SixOfFive/2009_kia_spectra/logs/2026-06-01.md

# 2026-06-01 — dashboard gets a map view; docs catch up to surf

Yesterday a parallel session brought up the kiosk display stack on
slypi (X11 + openbox + **surf**, not Chromium — see the braindump
heads-up + the [slypi vault note]). The vroom repo's reproduction
docs were still telling readers to install Chromium for the kiosk,
and the dashboard had no map view yet — the kiosk was pointed at a
standalone `/home/node/map.html` instead of vroom's dashboard.

Today's work closes both gaps with two commits.

## What landed today

| Commit | What |
|---|---|
| `6aad5e2` | Dashboard map view + toggle; docs + provision.sh switched from chromium to surf |

## Why surf, not Chromium — the gist

Chromium reliably OOM-killed itself on the Pi Zero 2 W (512 MB total)
while loading the dashboard. Surf (suckless WebKit2GTK) handles the
same page plus Leaflet at ~60 MB RSS without OOM, so it's the new
default. Chromium is still apt-installed by `provision.sh` as a
fallback for hardware with more headroom.

Documented in `docs/10-pi-setup.md` under a new "Why surf, not
Chromium" section.

## Doc + provision changes

`docs/10-pi-setup.md`:
- Every "chromium kiosk" reference is now "surf kiosk"
- "Why surf, not Chromium" callout explaining the OOM observation
- Step 8 + "What you should have" reflect the surf/openbox/xinit
  stack

`pi/setup/provision.sh`:
- apt list: dropped `matchbox-window-manager`, added `openbox` +
  `xinit` + `surf` + `xdotool` + `x11-xserver-utils`. Chromium
  retained as a fallback.
- Dropped the LXDE `@autostart` block in
  `/home/$PI_USER/.config/lxsession/LXDE-pi/`
- Added: `/etc/X11/Xwrapper.config` (allowed_users=anybody),
  `~/.xinitrc` (xset + unclutter + openbox + surf at
  `localhost:8000`), `~/.bash_profile` (auto-`exec startx` when
  logging in on tty1), and a `getty@tty1.service.d/autologin.conf`
  drop-in for autologin

The autostart pattern matches what the slypi session converged on in
their separate worktree — same conf paths, same file contents (modulo
the kiosk URL, which their copy points at `file:///home/node/map.html`
and ours points at `http://localhost:8000/`).

## Dashboard map view + toggle

The dashboard now ships with **two views**:

- **Gauges view** (default): the existing battery/RPM/speed/coolant/
  throttle/fuel gauges + control buttons + trip log + events feed
- **Map view**: an embedded Leaflet map, centered (by default) on
  Edmonton city center with OSM raster tiles

A floating button in the top-right corner toggles between them.
Mouse-click in a regular browser, touch-tap on the Elecrow screen —
identical behavior. The choice is persisted to `localStorage` so a
`vroom.service` restart that reloads the page doesn't bounce the
operator back to gauges if they were watching the map.

### Configuration knobs

In `pi/app/config.py`:

```python
MAP_DEFAULT_CENTER = (53.5461, -113.4938)  # Edmonton city center
MAP_DEFAULT_ZOOM = 12
MAP_TILE_URL = "https://{s}.tile.openstreetmap.org/{z}/{x}/{y}.png"
MAP_TILE_ATTRIBUTION = '&copy; <a href=...>OpenStreetMap</a> contributors'
```

Edmonton is the shipped default because it's a public landmark — change
this constant for your install. The Jinja template renders all four
into JS land via `tojson`, so anything you set in Python flows through
without template changes.

### Implementation notes

- **Lazy Leaflet init**: the map JS is only constructed the first time
  the toggle is tapped. A kiosk operator who only ever looks at gauges
  never pays the tile-fetch cost.
- **Hidden vs. unmounted**: the map container starts `display:none`,
  which means Leaflet doesn't render tiles for an invisible div. On
  show, `invalidateSize()` is called so Leaflet recomputes its
  viewport (Leaflet famously misbehaves if its container was hidden
  at construction).
- **Subresource integrity**: both the Leaflet CSS and JS `<link>` /
  `<script>` tags have `integrity="sha256-..."` hashes pinned. If
  unpkg ever serves a different file, the browser refuses to load
  it. (Update the hashes if you bump the Leaflet version.)
- **CDN, not vendored**: matches the precedent set by the slypi-side
  `/home/node/map.html` standalone map. If the Pi is offline (no LAN
  Wi-Fi), the map view shows the page chrome but no tiles. The
  gauges view doesn't need the CDN. A future improvement is vendoring
  Leaflet into `pi/app/display/static/vendor/` so the dashboard
  works fully offline — deferred until/unless that's needed.

### Tests

`pi/tests/test_display_server.py` gained two:

- `test_dashboard_includes_map_view_and_toggle` — verifies the
  toggle button, hidden `#view-map`, Leaflet CDN refs, and the
  `window.MAP_*` JS exports are all in the rendered HTML
- `test_dashboard_map_center_matches_config` — verifies the injected
  `MAP_CENTER` matches `config.MAP_DEFAULT_CENTER` (Edmonton as
  shipped). Renumber the constant in this test if the default
  center is ever changed.

Project test total: 197 → **199** (+2). Lint clean.

## Deploy + verify

On slypi:

```
cd /opt/vroom
git checkout -- pi/systemd/        # established pattern — discard
                                   #   the local User=node sed patches
git pull --ff-only
sudo systemctl restart vroom.service
```

Verified post-restart:

- `curl http://localhost:8000/` renders the new HTML (5524 bytes,
  was ~5000-ish). Toggle button + view-map div + Leaflet CDN refs +
  all four `window.MAP_*` exports all present.
- `python3 pi/tests/test_display_server.py` → **7/7** on Python 3.13.
- `/api/state` still returns the live snapshot.
- Mosquitto (`:1883`), dashboard (`:8000`), SNMP (`:1161`) all
  bound — no service regressions.

The slypi-side kiosk surf process is still pointed at
`file:///home/node/map.html` (the parallel session's standalone map).
**This commit doesn't move it** — that's a one-line `sed` on
`/home/node/.xinitrc` (point at `http://localhost:8000/` instead),
deliberately left to the slypi-session owner.

## Late evening — scope decision: ESP32-only is v1, Pi is v2

After looking at the dashboard map view land, took a step back to ask
"why did we add the Pi in the first place?" Honest review of the
docs:

- The vault note ([[vroom Pi-based remote start for 2009 Kia]]) and
  `docs/architecture.md` are clear: the Pi was always the *telematics*
  half. The trigger function — voltage monitoring, RF replay, run
  timer — has always been ESP32-only.
- The original ask (paraphrased): "my battery never dies in my car."
  That's pure ESP32 work.
- Everything since the SNMP responder commit is technically
  telematics: MQTT broker, dashboard hardening, kiosk stack, map
  view. None of it is wasted (all tested, all works), but **none of
  it is required for the original goal**.

Decision: **v1 ships as ESP32-only. Pi/telematics is parked as v2.**

### What this changes in the repo

Docs only — no code deleted, no slypi services stopped.

- `README.md`: rewritten to lead with the ESP32-only architecture +
  rationale + "v2 — optional telematics" section pointing at the
  parked Pi work
- `docs/BOM.md`: split into "v1 — essential (~$95)" and "v2 —
  optional telematics (+~$121)"
- `docs/architecture.md`: division-of-labor table now starts with
  v1 (everything-on-ESP32), then a "v2 add-on" section restores the
  Pi-side responsibilities; power architecture has v1 (1A buck, no
  MOSFET) + v2 (5A buck, AO3401A gate)
- `braindump.md`: pre-compaction state snapshot updated with the
  scope decision so future sessions see it on entry

### What this does NOT change

- ESP32 firmware (already works without a Pi — the Pi-power MOSFET
  GPIO toggles, `shutdown_pi` UART writes, and the STOPPING-state
  shutdown coordination are inert when no Pi is wired up)
- The `pi/` directory (kept as v2 reference build, all 199 tests
  still pass)
- slypi runtime (vroom.service stays running as the parked v2
  reference; mosquitto, SNMP, dashboard, map view all keep working
  there)
- The reproduction docs 13-20 (still useful — docs 13-16 cover
  in-car install which v1 needs; docs 17 (HA), 18 (long-term-
  stability), 19 (cellular alerting), 20 (SNMP) are v2 reference
  material)

### Why "v2" lives in the repo at all

Keeping it accomplishes three things:

1. **Reversibility** — if the v1 install gets boring after a winter
   of working perfectly and the telematics half becomes interesting,
   it's a `git pull` away. No re-derivation needed.
2. **Documentation** — the Pi-side work is, in aggregate, a pretty
   clean reference for "how to wire a Pi as a vehicle dashboard." It
   has value beyond this build.
3. **Tests stay green** — CI still exercises both halves on every
   push. Drift will catch itself.

The cost is roughly $0 — the repo has the code, tests run on free
CI, and nobody is forced to install the Pi side.

## TODO carried forward (cross-day, no day rollover)

- [x] ~~Update vroom docs about chromium-OOM + surf~~ — done (`6aad5e2`)
- [x] ~~Add tap-toggle between map and gauge view~~ — done (`6aad5e2`)
- [x] ~~Scope-down decision: ESP32-only v1~~ — done (this commit)
- [ ] When parts arrive: bench v1 first (docs 08-12), then in-car
      install (docs 13-16). v2 docs (17-20) only if/when telematics
      becomes interesting after a winter of v1 working.
- [ ] *(deferred to "if v2 becomes a thing")*: Leaflet vendoring,
      slypi xinitrc kiosk swap, HA integration, anything else from
      the prior list
