SixOfFive/2009_kia_spectra/logs/2026-05-30.md

# 2026-05-30 — first Pi deploy + SNMP cross-process bug found

The ESP32 + CC1101 + ADS1115 + display + buck haven't arrived yet, but
the Pi Zero 2 W is on the bench. Today was about getting the Pi-side
stack actually running on real hardware, not just CPython on the dev
workstation (BEAST). Target box: **slypi**, a Pi Zero 2 W Rev 1.0
running Debian 13 trixie, kernel `6.18.29+rpt-rpi-v8` aarch64. slypi
already had NetworkManager-managed static networking, Postfix relay,
logcheck, unattended-upgrades, and paired BT mouse + keyboard from
prior setup — the vroom Pi-side stack drops in on top. The slypi
vault note is the source of truth for the bits we keep off GitHub
(LAN IP, SSH credentials, host-key fingerprint).

## What landed today

| Commit | What |
|---|---|
| _(today)_ | `pi/systemd/vroom-snmp.service`: drop misleading `After=`/`Wants=vroom.service` |
| _(today)_ | `docs/20-snmp-integration.md`: new "Known limitation" on cross-process state staleness |
| _(today)_ | This daily log |

## Display mount decision — keep the existing docs/14 plan

Asked: "do you have the writeup done for mounting the screen onto the
project box?" Re-confirmed the design: the screen does **not** mount on
the enclosure. The current `docs/14-case-mounting.md` has:

- Hammond 1591ESBK enclosure → Velcro'd **under** the driver's-side
  knee panel
- 5" display → VHB-taped to the **top of the dash** above the radio
  bezel
- 50 cm HDMI ribbon + USB cable run up the right side of the steering
  column between them

Walked through the thermal + visibility + antenna-placement reasoning
for why "tablet on dash" (everything in one enclosure on the dash-top)
loses to the split. Decision held — no docs change.

## Provisioning slypi for vroom — the recon

```
host:       slypi (Pi Zero 2 W Rev 1.0, BCM43430 Wi-Fi+BT combo chip)
RAM:        415 MB total, 251 MB free at start
disk:       29 GB SD, 12% used
python3:    3.13.5  (Debian 13 default)
git:        missing
pip3:       missing
flask:      missing
paho-mqtt:  missing
serial:     missing
/opt:       empty
serial0:    no UART device (enable_uart=0 in config.txt — expected)
:8000, :1161:  both free
```

## What I installed

Four apt packages — chose Debian's packaged versions over `pip install
--break-system-packages` because trixie's are recent enough
(flask 3.1.1, paho-mqtt 2.1.0, pyserial 3.5):

```
sudo apt install -y --no-install-recommends \
    git python3-flask python3-serial python3-paho-mqtt
```

Note: `provision.sh` in the repo still uses
`pip3 install --break-system-packages paho-mqtt`. That's a different
trade — pip path on Pi OS Lite (no apt package for paho there).
Trixie has it in apt, which is cleaner; deviating from `provision.sh`
intentionally on this box.

## Repo + runtime layout

```
/opt/vroom             (git clone, owned by deploy user)
/var/log/vroom         (empty — ProtectSystem=strict in
                        vroom-snmp.service grants RW here)
/var/lib/vroom         (empty, future runtime state)
/etc/systemd/system/vroom.service
/etc/systemd/system/vroom-snmp.service
/etc/sudoers.d/vroom   (NOPASSWD: /sbin/shutdown for deploy user)
```

## Service-file patches for slypi

slypi's primary user isn't `pi` (Pi OS Lite default that the shipped
`pi/systemd/vroom*.service` files assume) — see the slypi vault note
for the actual username. Generic patch shape:

```
sed -i "s|^User=pi$|User=$DEPLOY_USER|; \
        s|^Group=pi$|Group=$DEPLOY_USER|" \
    /etc/systemd/system/vroom.service \
    /etc/systemd/system/vroom-snmp.service
```

Not pushed back to the repo — the canonical install is still `pi`, and
slypi is a one-off. If a second non-`pi`-user host ever joins the
fleet, a `PI_USER` env var on `provision.sh` would be the right
generalization.

## secrets.py on slypi

```
MQTT_BROKER = None              # no MQTT broker for vroom yet
SNMP_COMMUNITY = "public"
SNMP_PORT = 1161
SNMP_BIND_HOST = "0.0.0.0"
WIFI_SSID = "unused-managed-by-NetworkManager"
```

WiFi creds left as throwaway strings — wlan0 is managed by
NetworkManager with `ipv4.method manual`; the vroom daemon shouldn't
try to manage WiFi.

MQTT off entirely until we set up a broker for vroom. `config.py`'s
`mqtt_enabled()` returns `False` cleanly when `MQTT_BROKER is None`, so
both publisher and subscriber threads start and immediately exit with
`[mqtt] disabled`.

## Bug — SNMP responder serves boot-time defaults forever

The shipped `vroom-snmp.service` runs `pi.app.snmp_responder` as a
**separate process** from `pi.app.daemon`. Both `import pi.app.state`
and read `STATE`. I assumed in yesterday's design that they'd share
this dict the way threads inside one process do. They don't — module-
level dicts are per-process in CPython, so the UART listener writes
to the daemon process's dict and the SNMP responder reads its own
untouched copy. The walk confirmed:

```
.1.3.6.1.4.1.99999.7.1.0 = INTEGER: 99           # unknown
.1.3.6.1.4.1.99999.7.2.0 = Gauge32: 0            # battery_mv
.1.3.6.1.4.1.99999.7.3.0 = INTEGER: 0            # engine_running
.1.3.6.1.4.1.99999.7.4.0 = STRING: unknown       # state_name
...all the rest of the OIDs return their defaults
```

Compare to `/api/state` from the dashboard, which on the same box
shows `v_battery: 12.6`, `esp32_state: "boot"`, etc. — the daemon
process has live(ish) state; the SNMP process doesn't see it.

The wire format is fine — snmpwalk works, BER encoding is correct,
GET/GETNEXT/walk all do the right thing. The data is the problem.

### The fix (planned for next session, not today)

Run the SNMP responder as a **thread inside the main daemon**, sibling
to `uart_listener` and `mqtt_publisher`. Same process → shared `STATE`
dict. Roughly: add `snmp_responder.start_thread()` and call it from
`daemon.main()`. Delete `vroom-snmp.service`. ~30 LoC + a docs sweep
through `docs/20-snmp-integration.md` and `docs/architecture.md`.

Holding off today because (a) it's a meaningful refactor that wants
its own commit + test pass, and (b) the wire-format testing the
responder enables is still valuable on its own. Documented the
limitation in `docs/20` so anyone reading the OID table knows what
they're getting.

### Misleading systemd dependency caught while debugging

The `vroom-snmp.service` unit had `After=vroom.service` and
`Wants=vroom.service`, which implied the two services were
state-coupled. They aren't. Dropped both lines and added a comment in
the unit file explaining why.

Side-effect during debugging: the `Wants=` line was strong enough to
pull up `vroom.service` when I enabled `vroom-snmp.service`, even
though I'd never explicitly enabled vroom.service. That's how I
noticed the port-8000 collision when I tried to start the dashboard
"for the first time" — it was already running. Now both are properly
`enabled` (not just `running`).

## End state on slypi

```
$ systemctl list-unit-files | grep vroom
vroom-snmp.service                  enabled         enabled
vroom.service                       enabled         enabled

$ systemctl is-active vroom.service vroom-snmp.service
active
active

$ sudo ss -tulnp | grep -E ':8000|:1161'
udp UNCONN 0  0  0.0.0.0:1161  ...python3 -m pi.app.snmp_responder
tcp LISTEN 0  128 0.0.0.0:8000  ...python3 -m pi.app.daemon

$ ps -o pid,rss,cmd -C python3
   PID   RSS CMD
  7637 33076 /usr/bin/python3 -m pi.app.daemon
  8131 12200 /usr/bin/python3 -m pi.app.snmp_responder
```

44 MB resident across both, out of 415 MB total. Plenty of room.

Verified from BEAST (the dev workstation) over the LAN:

```
$ curl http://slypi:8000/api/state
{"counter":null,"engine_running":false,"esp32_state":"boot",
 "events":[],"last_obd":{...},"v_battery":12.6,...}

$ python -c "...snmpwalk via in-tree code..." slypi:1161
.1.3.6.1.4.1.99999.7.1.0 = INTEGER: 99
.1.3.6.1.4.1.99999.7.2.0 = Gauge32: 0
... (all 10 OIDs walk cleanly to END_OF_MIB)
```

BEAST is Windows — no `snmpwalk` in the path. The walk ran via
`pi/app/snmp_responder.py`'s own BER helpers and an inline GETNEXT
loop. Useful to know — for future LibreNMS / Cacti setup either
install net-snmp on the polling host, or just keep using the in-tree
client when sanity-checking.

## What we still can't do without parts

- `uart_listener` errors once per second (`/dev/serial0` doesn't exist)
  → journal noise. Not enabling the UART today because `enable_uart=1`
  in `/boot/firmware/config.txt` interacts with the BCM43430 BT/Wi-Fi
  coexistence pattern documented in the slypi vault note (heavy
  concurrent BT + Wi-Fi can stall the shared 2.4 GHz antenna, and one
  observed reboot left `wlan0` missing until a second reboot let
  `brcmfmac` reprobe). Will do the careful UART setup in the
  docs/11-uart-link.md session, when there's actually an ESP32 on the
  other end of the cable.
- Manual remote-start from the dashboard buttons returns `503 ESP32
  link not connected` — by design, the link is lazy-opened but every
  `send` fails with the missing-port error
- MQTT publish-state cadence — disabled until a broker is up

None of this is blocking. The Phase-3 in-car install (docs/13-19) still
gates on parts arriving.

## Later same day — SNMP refactor landed

Did the thread-in-daemon refactor that the "Known limitation" section
called out. Now one process serves both dashboard + SNMP from the
same in-process `STATE` dict.

Changes (commit `c3876a1`):

- `pi/app/snmp_responder.py` — added `start_thread()` that wraps
  `serve_forever` in a `daemon=True` thread named `vroom-snmp`. Kept
  `main()` for back-compat but it now logs a startup WARNING about
  the per-process state-staleness pitfall.
- `pi/app/daemon.py` — calls `snmp_responder.start_thread()` after
  the MQTT threads, gated on `config.snmp_ready()`.
- `pi/app/config.py` — added `SNMP_ENABLED` toggle + secrets import
  for `SNMP_COMMUNITY`/`SNMP_PORT`/`SNMP_BIND_HOST` with the same
  defaults as the example file. Added `snmp_ready()` helper.
- `pi/tests/test_snmp_responder.py` — new
  `test_start_thread_shares_in_process_state` test: spawns the
  thread, queries it, mutates the shared snapshot source, re-queries,
  asserts the response reflects the mutation. This is the explicit
  regression guard for the cross-process bug.
- `pi/systemd/vroom-snmp.service` — DELETED. No longer needed.
- `pi/setup/provision.sh` — no longer installs vroom-snmp.service.
- `docs/20-snmp-integration.md` — rewrote the architecture
  description, dropped the "Known limitation" callout, replaced with
  a much smaller "Standalone process mode (debugging only)" note.
- `docs/architecture.md` — Pi-side daemon layout is now a single-
  process table of four threads.

### Deploy on slypi

Stop + disable + remove the old separate service:

```
sudo systemctl disable --now vroom-snmp.service
sudo rm /etc/systemd/system/vroom-snmp.service
sudo systemctl daemon-reload
```

Pull. First attempt failed — `git pull` refused because the local
`pi/systemd/vroom.service` and `pi/systemd/vroom-snmp.service` had
the `User=pi` → `User=$DEPLOY_USER` patches from yesterday, and the
remote had deleted one of them entirely. Fix:

```
cd /opt/vroom
git checkout -- pi/systemd/       # discard local sed patches
git pull --ff-only                # now applies cleanly
sudo sed -i "s|^User=pi$|User=$DEPLOY_USER|; \
             s|^Group=pi$|Group=$DEPLOY_USER|" \
    /etc/systemd/system/vroom.service
sudo systemctl daemon-reload
sudo systemctl restart vroom.service
```

Established pattern for slypi: never modify the repo copies under
`/opt/vroom/pi/systemd/` directly — sed-patch only the deployed copies
under `/etc/systemd/system/`. Keeps `git pull` clean forever.

Verified:

```
$ sudo ss -tulnp | grep -E ':8000|:1161'
udp UNCONN ... :1161 ... python3,pid=8828,fd=3
tcp LISTEN ... :8000 ... python3,pid=8828,fd=4
```

Both ports on the same PID. Journal confirms:
`[daemon] SNMP responder on udp://0.0.0.0:1161`.

### Live-data verification

Side-by-side comparison from BEAST against slypi:

```
/api/state:                snmpwalk:
  v_battery     = 12.6       .2.0  Gauge32   = 12600    (12.6 * 1000 mV)
  esp32_state   = boot       .4.0  STRING    = "boot"
  engine_running= False      .3.0  INTEGER   = 0
  events count  = 0          .7.0  Counter32 = 0
  uptime_s      = 0          .5.0  TimeTicks = 0
```

The walk now reflects the daemon's actual state, not boot-time
defaults. The previous run before the refactor returned
`battery_mv: 0` and `state_name: "unknown"` for the same box at the
same time — i.e. the SNMP-process dict was empty while the dashboard
dict had real data. Fixed.

### Side note — UDP packet loss

Saw 1/3 timeouts on direct GET requests during testing — but GETNEXT
past end of MIB resolves 3/3 cleanly, and the responder replies to
every request the kernel hands it (verified by tcpdump-adjacent
observation: the responder thread is not crashing, requests just
aren't always arriving). This is plain UDP-over-Wi-Fi loss on
slypi's BCM43430 chip with BT also active — matches the Wi-Fi/BT
coexistence quirk documented in the slypi vault note. Real SNMP
clients (snmpwalk, LibreNMS, etc.) handle this with `-r N` retries.
Not a code issue, but worth knowing so a future "why does SNMP
sometimes lag" doesn't get chased through the responder code.

## Evening pass — Pi-side hygiene (one more commit)

Four small follow-ups landed in commit `ed814fe`, plus runtime
configuration on slypi:

### 1. Baseline: full test suite on slypi's Python 3.13

CI runs the test matrix on 3.10/3.11/3.12; slypi has 3.13 (Debian
trixie default). `192/192` passing on 3.13, no surprises. 3.13's
`PEP 695` generics + `typing.Tuple` deprecation didn't trip anything
because the code already used built-in generics (`tuple[int, ...]`)
where applicable.

### 2. `uart_listener` error-suppression

Pre-fix, the per-second `[uart-listener] ERROR recv` spam (port
doesn't exist → identical errno-2 every loop iteration) was a real
problem in the journal — 86,400 identical lines per day if the ESP32
takes a few days to arrive. Fixed by adding repeated-error
suppression in `listen_forever`:

- First instance of an identical error logs immediately (so the
  operator sees the problem at boot)
- Further identical errors are suppressed for 60s
- A single "still failing" summary line lands at the end of each
  window with the count and elapsed time
- When recv() recovers, a "recv() recovered" line is logged

Implementation made `time.monotonic` and `time.sleep` injectable so
the new 5 tests in `pi/tests/test_uart_listener.py` exercise the
suppression window without wall-clock waits.

Verified on slypi: after deploy, journal shows the first ERROR at
startup, then exactly one "[60 occurrences in last 60s]" line per
minute. Down from ~3600 lines/hour to ~60.

### 3. `vroom.service` systemd hardening

Added the same defense-in-depth directives the deleted
`vroom-snmp.service` had — `PrivateTmp`, `ProtectSystem=strict`,
`ProtectHome`, `ProtectKernel*`, `ProtectControlGroups`,
`Restrict*`, `LockPersonality`, `MemoryDenyWriteExecute`,
`RestrictAddressFamilies=AF_INET AF_INET6 AF_UNIX`. Plus
`ReadWritePaths=/var/log/vroom /var/lib/vroom` (trip log + future
state) and `DeviceAllow` for `/dev/serial0` + `/dev/ttyAMA0` +
`/dev/ttyS0`.

Intentionally **not** set: `NoNewPrivileges`. The daemon shells out
to `sudo shutdown` when the ESP32 requests power-down, and
NoNewPrivileges would block sudo's setuid escalation. Inline
comment in the unit file explains the tradeoff.

Verified on slypi: `systemctl show vroom.service` confirms
`PrivateTmp=yes`, `ProtectSystem=strict`, `MemoryDenyWriteExecute=yes`,
`RestrictAddressFamilies=AF_INET AF_INET6 AF_UNIX`. Daemon still
runs cleanly — no surprise breakage from the hardening.

### 4. `enable_uart=1` + serial-console disable + dialout group

Two-step:

```
# Append enable_uart=1 to /boot/firmware/config.txt
# (backup at config.txt.bak.20260530)
# Disable serial console (raspi-config nonint do_serial_cons 1)
sudo reboot
# Then add the daemon user to dialout so it can open /dev/serial0
sudo usermod -aG dialout $DEPLOY_USER
sudo systemctl restart vroom.service
```

After reboot + group add + restart:

```
$ ls -l /dev/serial0 /dev/ttyS0
lrwxrwxrwx 1 root root        5 May 30 16:20 /dev/serial0 -> ttyS0
crw-rw---- 1 root dialout 4, 64 May 30 16:20 /dev/ttyS0

$ sudo journalctl -u vroom.service --since "60s ago" | grep -c "ERROR recv"
0
```

Zero ERROR lines from uart_listener after restart — the port opens
cleanly, recv() returns no data (because there's no ESP32 on the
other end yet), uart_listener sleeps poll_interval and loops. Same
behavior we'll have when the ESP32 is connected-but-quiet. Exactly
the "no surprises when parts arrive" state we wanted.

slypi-specific gotchas worth knowing:

- **BCM43430 BT/Wi-Fi coexistence** — `enable_uart=1` alone is safe
  (turns on the mini-UART on GPIO 14/15; the PL011 stays wired to
  BT). Avoided `dtoverlay=disable-bt` and `dtoverlay=miniuart-bt`
  precisely because those WOULD touch BT, and slypi has paired BT
  mouse + keyboard. Post-reboot verified: `bluetoothctl show`
  reports the controller `Powered: yes`, and `wlan0` came up on the
  first reboot (didn't hit the vault-documented "wlan0 missing,
  reboot again" quirk this time).
- **Serial console was routed to `serial0`** by default in
  `/boot/firmware/cmdline.txt` (`console=serial0,115200`). That
  would have raced with the daemon for the port — `raspi-config
  nonint do_serial_cons 1` removed it. Now `cmdline.txt` has just
  `console=tty1`.
- **`node` user wasn't in `dialout`** by default — the daemon's
  first attempt to open `/dev/serial0` after reboot got
  `Permission denied: '/dev/serial0'` (errno 13, not 2). Fixed by
  adding to dialout group + restarting the service so the new
  group set takes effect. NEW gotcha worth pinning in the slypi
  vault note: **systemd does NOT re-read supplementary group
  memberships on `restart` unless the unit is fully stopped first**
  — `restart` was enough here, but in general `stop` + `start` is
  the safer pattern after a `usermod -aG`.

### Final slypi state

```
$ ps -o pid,etime,rss,cmd -C python3
   PID  ELAPSED   RSS CMD
   986    02:05 32936 /usr/bin/python3 -m pi.app.daemon

$ sudo ss -tulnp | grep -E ':8000|:1161'
udp UNCONN ... :1161 ...python3,pid=986,fd=8
tcp LISTEN ... :8000 ...python3,pid=986,fd=9

$ curl -s http://localhost:8000/api/state | jq '.v_battery, .esp32_state'
12.6
"boot"

$ snmp-via-in-tree-client slypi:1161 .1.3.6.1.4.1.99999.7.2.0
Gauge32: 12600     # matches /api/state
```

Single 33-MB process, both ports, dashboard + SNMP serving consistent
live data, no UART noise. All 197 tests passing on Python 3.13. The
Pi side is done as a standalone unit — every remaining gap (UART
data, MQTT publishes, trip log writes) is now downstream of "ESP32
on the cable" or "MQTT broker decision", not Pi-side work.

## Late evening — mosquitto on slypi (the MQTT broker decision)

Picked "fresh mosquitto on slypi" over "reuse an existing LAN broker"
— vroom is a self-contained appliance, no reason to couple its
plumbing to another service that could be retired independently.
slypi has 250+ MB of free RAM and mosquitto's RSS is ~3 MB, so
co-locating with `vroom.service` on the same Pi Zero 2 W is fine.

### Install + config

```
sudo apt install -y --no-install-recommends mosquitto mosquitto-clients
# Got mosquitto 2.0.21 from trixie. Debian auto-enables and starts the
# service bound to 127.0.0.1:1883 only (2.x security-by-default).
```

Default `/etc/mosquitto/mosquitto.conf` keeps persistence on (DB at
`/var/lib/mosquitto/mosquitto.db`) and logs to
`/var/log/mosquitto/mosquitto.log` — both fine, left alone. The
vroom-specific override is intentionally tiny:

```
# /etc/mosquitto/conf.d/vroom.conf
listener 1883 0.0.0.0
allow_anonymous false
password_file /etc/mosquitto/passwd
```

Only the **deltas** from the base config — duplicating any base key
(persistence_location, log_dest, etc.) is a fatal config error in
mosquitto 2.x. Hit that on the first attempt; minimal config is
correct.

### Auth

One user, `vroom`, password is 128 bits from `openssl rand -hex 16`
(cryptographic, not invented). Stored in `/etc/mosquitto/passwd`
(hashed) and in `/opt/vroom/pi/app/secrets.py` (cleartext, mode 600,
gitignored) and in the slypi vault note (unredacted). No copy of the
cleartext lives in this public log.

The password file needs `root:mosquitto` ownership (not
`mosquitto:mosquitto`) — mosquitto 2.x warns on any non-root owner
and future versions will refuse to load. Got the warning on the
first attempt; fixed with `chown root:mosquitto`.

```
sudo touch /etc/mosquitto/passwd
sudo chown root:mosquitto /etc/mosquitto/passwd
sudo chmod 0640 /etc/mosquitto/passwd
sudo mosquitto_passwd -b /etc/mosquitto/passwd vroom "$MQTT_PASS"
```

No ACLs for v1 — authenticated users can publish or subscribe
anywhere. Future improvement if multiple publishers ever share this
broker: split into per-app users (`vroom-pub` / `vroom-sub` / etc.)
with topic ACLs.

### Verification — local

```
$ mosquitto_pub -h 127.0.0.1 -t test/no-auth -m x
Connection error: Connection Refused: not authorised   (good — auth required)

$ mosquitto_pub -h 127.0.0.1 -u vroom -P "$PW" -t test/hello -m broker-up
$ mosquitto_sub -h 127.0.0.1 -u vroom -P "$PW" -t test/hello -C 1
broker-up   (good — pub/sub round-trip)

$ mosquitto_pub -h 127.0.0.1 -u vroom -P "$PW" -t test/r -r -m retained
$ mosquitto_sub -h 127.0.0.1 -u vroom -P "$PW" -t test/r -C 1
retained   (good — retain works; cleaned up with -r -n after)
```

### Wiring vroom to the local broker

Updated `/opt/vroom/pi/app/secrets.py`:

```python
MQTT_BROKER = "127.0.0.1"            # was None (disabled)
MQTT_PORT = 1883
MQTT_USERNAME = "vroom"
MQTT_PASSWORD = "<128-bit cleartext>"
MQTT_TOPIC_PREFIX = "vroom/spectra"
```

`secrets.py` is mode 600, owned by the deploy user, gitignored. Then
`sudo systemctl restart vroom.service` and the daemon's startup
journal now reads:

```
[mqtt-sub] connected, subscribed to vroom/spectra/cmd
[mqtt] connected to 127.0.0.1:1883
```

(Previously both said `disabled (MQTT_ENABLED=False or no broker in secrets)`.)

### Cross-LAN verification from BEAST

```python
import paho.mqtt.client as mqtt, time
c = mqtt.Client(mqtt.CallbackAPIVersion.VERSION2, client_id='beast-probe')
c.username_pw_set('vroom', PASSWORD)
c.on_message = lambda *_: print(...)
c.connect('slypi', 1883, 60)
c.subscribe('vroom/spectra/#')
... loop for 22 s ...

connected rc=Success
[vroom/spectra/state] retain=True  {"v_battery": 12.6, "esp32_state": "boot", ...}
[vroom/spectra/state] retain=False {"v_battery": 12.6, "esp32_state": "boot", ...}
[vroom/spectra/state] retain=False {"v_battery": 12.6, "esp32_state": "boot", ...}
got 3 messages on vroom/spectra/# in 22s
```

- **First message** is `retain=True` — the broker held the most-recent
  snapshot and pushed it to BEAST immediately on subscribe. Exactly
  what we want for Home-Assistant-style late subscribers: connect →
  see current state without waiting for the next publish interval.
- **Subsequent messages** are `retain=False` — live publishes from
  vroom's publisher thread every 10 s (`MQTT_PUBLISH_INTERVAL_S` in
  `pi/app/config.py`).
- Payload schema matches `/api/state` — same `v_battery: 12.6`,
  `esp32_state: "boot"`, OBD dict, etc.

22 s / 10 s interval ≈ 2.2 → 3 messages is correct (1 retained-on-
connect + 2 live publishes).

BEAST is Windows, so `mosquitto_pub`/`sub` aren't in the path —
`pip install paho-mqtt` and the inline script above is the practical
way to sanity-check the broker from BEAST. paho-mqtt is also the
library vroom uses on the Pi side (already in apt as
`python3-paho-mqtt`).

### Three protocol surfaces, one source of truth

vroom now has three ways to observe state from outside the Pi:

| Surface | Endpoint | Payload | Cadence |
|---|---|---|---|
| Dashboard JSON | `http://slypi:8000/api/state` | JSON | on-demand (browser polls every 1 s) |
| SNMPv2c | `snmpwalk slypi:1161 .1.3.6.1.4.1.99999.7` | 10 OIDs | on-demand |
| MQTT | `slypi:1883` topic `vroom/spectra/state` | JSON (retained) | every 10 s, plus retained-on-connect |

All three serve the same `state.snapshot()` dict — confirmed live
during the SNMP refactor that they return matching values (`v_battery`
in JSON = `battery_mv` in SNMP = `v_battery` in MQTT, all 12.6 V /
12600 mV / `12.6`).

## TODO carried forward

- [x] ~~Refactor `snmp_responder` to thread-in-daemon~~ — done (`c3876a1`)
- [x] ~~`uart_listener` ENOENT backoff~~ — done (`ed814fe`)
- [x] ~~Systemd hardening on `vroom.service`~~ — done (`ed814fe`)
- [x] ~~Enable UART on slypi + verify BT still works~~ — done (slypi
      reboot 2026-05-30 16:20)
- [x] ~~Test suite on slypi's Python 3.13~~ — 197/197 done
- [x] ~~Decide on an MQTT broker for vroom~~ — fresh mosquitto on slypi,
      `vroom/spectra/{state,event,cmd}` topics, retain-on-state, ~3 MB RSS
- [ ] When parts arrive: docs/11 UART link, then test against actual ESP32
- [ ] Photos of slypi for `logs/images/2026-05-30/` (none today — just
      a Pi on a desk, nothing photogenic)
- [ ] Eventual: home-assistant integration following `docs/17` (broker
      is up; just need an HA host pointed at it)
