SixOfFive/2009_kia_spectra/logs/2026-05-24.md

# 2026-05-24 — production hardening day

Still pre-parts. Continued through the remaining hardware-independent work items from braindump §11.

## What landed today

| Commit | What |
|---|---|
| `8e174e1` | Deep sleep + RTC-memory streak persistence (`lib/persistence.py` + controller refactor) |
| `8b4d21c` | Phase 2 reproduction docs: flash MicroPython → bench smoke tests → Pi setup → UART link → KeeLoq bench validation (docs/08–12) |
| `76d791c` | GitHub Actions CI (Python 3.10/3.11/3.12) + 9 end-to-end integration tests with paired UART pipe |

Plus README + architecture + braindump refresh capturing the new state.

## Deep sleep — the big one

The whole point of the ESP32 is microamp current between samples. Without deep sleep we'd sit at ~80 mA and drain the car battery in a few days. Now:

- `lib/persistence.py` stores an 8-byte blob in RTC memory: 4-byte magic `VRM2` + uint16 `low_v_count` + 2 reserved. Survives `machine.deepsleep()` (which is a hard reset on the ESP32; nothing else but RTC memory survives).
- `controller.py` replaced the `low_v_streak_start` timestamp (broken across deep sleep because `time.time()` resets) with a sample-count approach. Each MONITORING tick increments or resets the count and persists. Trigger fires when count × WAKE_INTERVAL_S ≥ LOW_V_SUSTAIN_S.
- `run()` loop: after a MONITORING tick where we just took a sample, call `machine.deepsleep(WAKE_INTERVAL_S * 1000)`. Board resets, `load_streak()` reloads the count at the top of next `run()`.
- Other states (STARTING/RUNNING/STOPPING/COOLDOWN) stay in the regular 100ms tick loop — Pi is on and we need UART comms.

Trade-off documented in the controller docstring: manual remote-start from the dashboard only works when the ESP32 is awake, which it only is briefly between deep-sleep cycles or once a trigger has fired. By design — primary mode is voltage-trigger.

## Phase 2 docs (08–12)

Five new reproduction docs that walk anyone from "fresh ESP32 + Pi out of box" to "synthesized KeeLoq Lock cycle accepted by the car":

- **08 flash-micropython** — Thonny + esptool, COM port + USB-serial driver notes, machine.CAN availability check
- **09 bench-smoke-tests** — per-module isolation tests in order: blink, WiFi scan, ADS1115 I2C, CC1101 SPI part-ID + first OOK burst visible on SDR, SN65HVD230 CAN loopback (skippable if firmware lacks CAN)
- **10 pi-setup** — Imager settings, first-boot SSH, provision.sh, secrets.py, systemd start, chromium kiosk on the Elecrow
- **11 uart-link** — 3-wire ESP32↔Pi UART wiring with the explicit "both sides 3.3V, level shifter not needed but warning re: 5V clone boards" callout, bare-cat protocol sanity test, full JSON round-trip with ping ACK
- **12 keeloq-bench-validation** — the moment-of-truth doc. Populate secrets, synthesize a packet, decrypt back with validate-key.py, RTL-SDR sniff comparison to FOB pattern, then car test in order: Lock → Unlock → Start. Includes valet-switch safety setup and the FOB-counter-desync explanation for after bench testing.

## CI

`.github/workflows/tests.yml` runs all unit + integration tests on every push and PR across Python 3.10/3.11/3.12. Flask is the only third-party install needed (paho-mqtt no-ops cleanly when absent).

## Integration tests

`esp32/tests/test_integration.py` builds a paired in-memory UART pipe, wraps one end in the ESP32-side `UartLink` and the other in the Pi-side `Esp32Link`, then drives the controller through realistic scenarios:

- MONITORING sample → STATUS message decodes correctly on Pi side
- STATUS message dispatched via `uart_listener.dispatch` flows into Pi STATE
- Pi sends `start_engine` → ESP32 dispatches → triggers RF + power-on + events → Pi sees them
- KEELOQ_TX event detail contains function + counter
- OBD message round-trips with all fields intact

Plus three explicit constant-parity tests (`TYPE_*`, `CMD_*`, `EVENT_*`) that fail loudly if `pi_link.py` and `esp32_link.py` drift on any shared constant name or value.

## Test totals: 74 across the project

- 4 keeloq + 6 compustar + 9 obd2
- 8 ads1115 + 6 cc1101 + 5 persistence
- 12 controller + 9 integration
- 6 esp32_link + 9 uart_listener

## What's left

Genuinely just hardware bench-test + SDR captures + in-car validation:

1. Inventory parts on arrival
2. Flash MicroPython, copy `esp32/src/` to the chip
3. Run docs/09 bench smoke tests
4. Run sdr/01–07 walkthrough with the FOB → recover device key → fill secrets.py
5. Run docs/12 KeeLoq bench validation → Lock cycle in the car
6. Move to perfboard, mount in case, in-car install

If the bench reveals anything that needs new code, that'll be the next code work. Until then we wait for shipping.

## Late additions — watchdog, dashboard events, install scripts

Three more commits (`e8abc34` README refresh + `f88f076` this round):

- **Hardware watchdog** in the controller: `machine.WDT(timeout=120s)` fed at every tick. Default ON via `WDT_ENABLED` in config. CPython is a no-op (test confirms `ctrl.wdt is None` in tests). 2 new controller tests pass.
- **Dashboard recent-events panel**: the events were always flowing into `state.events` via `uart_listener.dispatch`, but nothing displayed them. Added a bounded list panel to `dashboard.html`, dark-theme styled, JS reverses to newest-first and color-codes by event name (engine_started = green, low_voltage_trigger = red, etc.). Now you can actually see what just happened on the dashboard.
- **mpremote install scripts** (`esp32/scripts/install.sh` + `.ps1`): wraps the `mpremote connect <port> cp -r esp32/src/. :` workflow with sanity checks. Documented in `docs/09` as the faster alternative to dragging files in Thonny.

Final test count: **76** across the project. CI green.

## Where we land

Everything that can be coded without hardware in hand is coded. Test coverage is real (76 passing, including 9 end-to-end integration tests with paired UART pipe). Documentation is reproducible end-to-end through Phase 2.

Next genuine code work waits on parts. The first real signal will be whether the manufacturer-key database hits for the FOB (sdr/07 Path A) or if we need a PICkit (Path B).

## Even later — simulator, MQTT subscriber, power budget, pre-flight check

Couple more rounds added (`b344acf`, plus pre-flight in this round):

- **`esp32/scripts/simulate.py`** — CPython driver that runs the controller through three scripted scenarios with mocked hardware (`low_voltage` full cycle, `manual` command dispatch, `long_idle` no-spurious-trigger). Every emitted UART message printed in human-readable form. Useful for hands-on protocol debugging without burning a board. ASCII-only after fighting Windows cp1252.

- **MQTT command subscriber** (`pi/app/comms/mqtt_subscriber.py`) — closes the home-network loop. Subscribes to `<prefix>/cmd` on the same broker the publisher uses; whitelist forwards `start_engine` / `stop_engine` / `ping` / `set_threshold` to the ESP32, drops everything else. Wired into daemon.py alongside listener + publisher. Shares `state.ESP32_LINK_LOCK` with Flask so concurrent commands don't interleave UART bytes. Now you can `mqtt.publish vroom/spectra/cmd '{"cmd":"start_engine"}'` from Home Assistant.

- **`docs/power-budget.md`** — end-to-end current-draw analysis confirming the architecture meets the "weeks parked" goal: ~9.5 mA from us + ~30 mA car parasitic = ~26 days to first trigger from a full battery. Net-restorative: each 15-min run dumps ~4.8 Ah back via alternator. LM2596 quiescent is the dominant load on our side; swap to TPS62291 if real-world parked drain comes in worse than predicted.

- **`tools/preflight.py`** — runs from your dev machine to validate config thresholds, secrets presence, module imports, and optional deps (flask required, paho-mqtt optional). Catches missing-secrets-before-flash issues in <2s. `--side esp32|pi|both`, `--strict` to exit nonzero on warnings.

- **`pi/app/state.send_to_esp32(msg)`** — thread-safe write wrapper holding `ESP32_LINK_LOCK`. Used by both Flask `/api/command` and MQTT subscriber to avoid byte interleaving on the UART.

**Final test count: 85** (76 + 9 mqtt_subscriber).

**Final state**: all hardware-independent code + tests + reproduction docs + safety analyses complete. Everything from `braindump.md §11` and §13 that doesn't require physical parts is done.

## Final polish round

- `docs/day-one.md` — take-to-the-bench cheat sheet combining docs/08-12 into an ordered checklist with per-module triage table (catches the ESP32 antenna-only scam and the OBD-II male-vs-female trap as you unbox), and a "when things go wrong" troubleshooting section
- Dashboard toast notifications — replaces the blocking `alert()` modal on `/api/command` failure with a slide-up toast at the bottom, color-coded by outcome. Cleaner on a 5" touchscreen + doesn't block the rest of the UI.
- `SECURITY.md` — threat model for a publicly-published in-cab device that can start an engine. Documents what's in the repo vs gitignored, what an SDR-armed attacker can already do regardless of this project, what we newly expose (recovered device key on the SD card / ESP32 flash), and what we explicitly don't defend against (LAN-side dashboard auth, MQTT broker compromise beyond the whitelist, power-glitch flash dumps).
- README build-status updated: 85 tests, latest feature set, day-one.md linked.

That's the end of the road for "things to do without parts in hand." 12 commits today, ~3500 lines of code + docs net added, every change auto-committed and pushed.

## End-of-day SDR progress summary

Got far enough into Phase 1 to identify the rough HOP/SER structure of the FOB packet but ran into a fundamental demodulator quality issue. Details below; finer breakdown of struggles in the next section.

### Captures completed
- Frequency confirmed via `rtl_power` sweep (recorded in `framing.md`, public per user OK).
- Per-button captures at `-g 20`:
  - Start: 13 bursts across 3 multi-press files (002, 003, 004)
  - Lock: 3 bursts (one file from earlier round — user didn't capture lock-002/003/004)
  - Unlock: 13 bursts across 2 files
  - Trunk: 13 bursts across 2 files
- All trimmed via `trim-burst.py` into per-burst `.bin` files
- All demodulated via `demod-ook.py` into `.pN.bits` files (gitignored)

### Demodulator status
- Works structurally — finds preamble + 66-bit data
- This FOB's encoding doesn't match standard HCS PWM (which has clean 1:2 pulse ratio per bit). Pairs of pulses can be (S,S), (S,L), (L,S), or (L,L); standard PWM only allows (S,L) and (L,S). The (S,S) and (L,L) pairs make the bit decision noisy.
- Per-bit accuracy ~80% on a single decode; majority-vote across multiple decodes recovers most (but not all) bits.

### Framing classification (via `analyze-framing.py`)
```
pos:  0         1         2         3         4         5         6
      0123456789012345678901234567890123456789012345678901234567890123456
type: SSHSHSSSHSSSHSSSSHSSHHSSHHHHHHSHHHHHHHSSSSHSSSHSSSSSSSSSSSHHSSHHHS
```
27 HOP positions, 39 SER positions, 0 FN positions identified. The function code didn't cleanly fall out — Start's noisy decoding makes it `?` at the positions where Unlock and Trunk show stable differing values. Candidates for the 4-bit function code: positions 29, 35, 36 (clear button-by-button differences) plus one more we can't identify without cleaner Start data.

Details (sanitized public version) saved here; per-FOB bit details in the gitignored `sdr/analysis/framing.local.md`.

### Tools added today (~all gitstaged + pushed)
- `inspect-capture.py` — pre-URH burst finder
- `trim-burst.py` — slice multi-press captures
- `demod-ook.py` — headless OOK demodulator (replaces URH)
- `debug-envelope.py` — run-length diagnostics
- `consensus-bits.py` — majority-vote across .bits files
- `analyze-framing.py` — classify positions HOP/FN/SER across buttons

The whole SDR walkthrough is now Python-stdlib end-to-end — URH dropped as a dependency.

### What's blocking advancement to step 07 (key recovery)
1. Demodulator bit-decision logic needs improvement for this FOB's specific encoding. Standard PWM ratio test (`hi_len < lo_len ?`) coin-flips on (S,S) and (L,L) pairs.
2. The function code bits aren't cleanly identified yet — need either better demod OR 10+ Lock captures to symmetrize the dataset.
3. Without the function code mapping locked, can't move to key recovery confidently.

### Probable next moves
- Capture 10+ Lock presses to balance the dataset
- Investigate whether this FOB uses Manchester encoding or some other non-standard scheme (the consistent (S,S)+(L,L) pair patterns hint at this)
- Or: install URH after all (`py -3.13 -m pip install urh`) for visual signal inspection, comparing one packet's waveform against what the demodulator decodes

## SDR phase actual start — Vomeko dongle + Win11 USB-3 host pain

Started running through `sdr/01-software-setup.md` for real. The walkthrough survived first contact but exposed three doc gaps that got fixed in-place:

### Struggle 1: rtl-sdr Windows binaries — bad link

The doc pointed at `https://github.com/osmocom/rtl-sdr/releases` for Windows binaries. **That GitHub mirror has no releases.** Real sources are:
- Official osmocom FTP: https://ftp.osmocom.org/binaries/windows/rtl-sdr/ (fresh weekly builds)
- RTL-SDR Blog fork: https://github.com/rtlsdrblog/rtl-sdr-blog/releases (signed Windows release, includes Zadig and tuned drivers for R828D)

Fixed in commit `bb93ead`.

### Struggle 2: URH wheels on Python 3.14

`pip install urh` on Python 3.14 (current default install) fails with "You need Cython to build URH's extensions!" — URH 2.10 publishes prebuilt Windows wheels only for **cp313-win_amd64** (Python 3.13 specifically). Not 3.10, not 3.11, not 3.12, not 3.14. Linux ships wheels for 3.10–3.14.

Solution: install Python 3.13 alongside 3.14 (with "Add to PATH" unchecked), then `py -3.13 -m pip install --user urh` → `py -3.13 -m urh`. Documented after first guessing 3.12 (wrong — also no Windows wheel for 3.12). Commits `e9af934` then `750880e`.

### Struggle 3: R828D tuner + USB-3-only host = unreliable

The Vomeko dongle (R828D tuner, not R820T2 as the docs assumed — these clones ship with whichever is cheaper that batch) failed dramatically on direct USB 3.x connection:
- `Unknown USB Device (Device Descriptor Request Failed)` initially
- After Zadig: descriptor reads work, but `rtlsdr_demod_read_reg failed with -9` (USB pipe stall) on register reads
- Tuner identifies as R828D, then i2c writes fail
- Async bulk transfers crash with `cb transfer status: 4` → `5` (device dropped) and `Library error -5`

What got it working:
1. **USB 2.0 hub between the dongle and the PC.** Forces USB 2.0 negotiation, isolates the dongle from the host controller. Even an unpowered cheap hub helps.
2. **Drop sample rate to 250 kSps** instead of 2 MS/s. R828D + USB-3-only-host + budget hub can't sustain 2 MS/s reliably — `rtl_test` survives sometimes, fails other times. 250 kSps is rock-solid. For our 50 kHz-wide FOB signal, 250 kSps has 2.5× margin so it's plenty.

Both changes documented in `sdr/01` and `sdr/04`. Commits `982a051`, `f0bae96`, `7323993`.

### Success: frequency confirmed

Once the dongle stabilized via the hub, `rtl_power` ran cleanly (sweep mode is gentler than streaming) and produced a clean spectrum result. Strong peak above the noise floor in the expected ISM band, classic HCS OOK signature spreading across ~10 kHz of adjacent bins. Recorded the measured center frequency (which user OK'd as non-sensitive) into `sdr/analysis/framing.md`. Commit `4e172a8`.

Total turnaround from "rtl_test prints garbage" → "FOB carrier identified" was about two hours of poking. The dongle is borderline-stable but workable for the project.

## Privacy hygiene update

Refactored `sdr/analysis/framing.md` to keep only the universal / explicitly-OK info in the committed file:
- Packet layout (universal HCS300/301)
- Timing constants (universal HCS encoder configuration)
- Measured frequency (user said OK to publish)

Moved per-FOB sensitive values (28-bit serial, function-code mapping, captured hopping codes, counter values) to a new gitignored file:
- `sdr/analysis/framing.local.md` (gitignored)
- `sdr/analysis/framing.local.md.example` (committed template; copy it before step 06)
- `.gitignore` extended with `sdr/analysis/*.local.md` pattern

Updated `sdr/06` and `sdr/07` to direct future-me (or any reader) to write FOB-identifying values to the local file, not the committed one. The device key always lived in the gitignored `esp32/src/secrets.py`; this just gives the same treatment to the serial + function mapping + hopping captures.

**Heading into step 04 (recording 10 Start + 3 Lock + 3 Unlock captures) at 250 kSps. The captures themselves are gitignored (`sdr/captures/*.bin`) so they stay local.**

## Late-day plot twist — this FOB isn't KeeLoq at all

The thing that broke the demodulator (~80% per-bit accuracy on Start with consistent S/S and L/L pulse pairs) wasn't a demodulator bug. The whole HCS300/KeeLoq assumption was wrong. Cross-referencing the rtl_433 project source tree found `compustar_1wg3r.c` — a device decoder for the Compustar 1WG3R family (1WG3R-SH, 1WAMR-1900) that's almost certainly the same protocol family as our 1WSHR-PRO. Key revelations:

- **Modulation: OOK_PULSE_PWM** with `short_width=708 µs`, `long_width=1076 µs`, `sync_width=1448 µs`. Not the 1:2 ratio HCS uses.
- **Fixed code.** No rolling counter, no KeeLoq encryption, no device key. Every press of the Start button transmits an identical 35-bit pattern.
- Integrity is a single inversion check (`button_inverse XOR button_code == 0xFF` in the canonical 1WG3R layout).

Empirically confirmed by re-decoding our captures with the corrected pulse widths: all 10 Start presses produce the same bits. All 10 Unlock presses produce the same different bits. The "rolling code" we'd been assuming had to exist *didn't*. That's what the (S,S)+(L,L) "decoder error" pairs were — they were sync pulses (3 of them in a row per packet) which the HCS-PWM demodulator was misclassifying.

### Implications

- KeeLoq cipher infrastructure (`esp32/src/lib/keeloq.py`) — **not needed for this FOB.** Kept in tree as future-proofing for any HCS-KeeLoq variant.
- Device-key recovery (sdr/07 walkthrough) — **not needed.** No key to recover.
- Counter management (RTC-memory persistence of a hopping-code counter) — **not needed.**
- ESP32 firmware reduces to: store 4 captured bit patterns in `secrets.py`, transmit verbatim with proper pulse widths. Capture-and-replay, not synthesize-and-encrypt.

This makes the whole project substantially simpler.

## rtl_433 ground-truth verification

Installed the nightly Windows build of rtl_433 (release 25.12 doesn't have the compustar_1wg3r decoder yet — it was added post-25.12). Ran `-A` (pulse analyzer mode) on `fob-start-lg20-b1.bin`:

```
Pulse width distribution:
 [1] count: 142, width:  732 us  [728;760]    -> "0" bit HIGH
 [3] count: 144, width: 1100 us  [1100;1108]  -> "1" bit HIGH
 [2] count:  24, width: 1476 us  [1472;1480]  -> sync HIGH

Gap width distribution:
 [0] count: 142, width:  756 us  -> LOW gap after "1" bit
 [2] count: 144, width: 1136 us  -> LOW gap after "0" bit
 [1] count:  24, width: 1500 us  -> LOW gap after sync

SNR: 42 dB
```

Two important things the analyzer told us that we'd been guessing:

1. **The protocol uses symmetric PWM.** Both HIGH and LOW vary per bit, not just HIGH. "0" = HIGH(732) + LOW(1136); "1" = HIGH(1100) + LOW(756); sync = HIGH(1476) + LOW(1500). Pulse pairs sum to ~1860 µs.
2. **Burst arithmetic checks out exactly:** 142 zeros + 144 ones + 24 syncs = 310 pulses. If each packet is `[3 syncs] + [35 data bits]` and there are 8 repeats per burst plus a ~6-pulse wake-up preamble, that's `6 + 8 × (3 + 35) = 310`. Match.

rtl_433's `-R 302` (compustar_1wg3r decoder) does NOT decode our packets — it expects 1 sync + 36 bits per packet per the canonical 1WG3R spec, but our 1WSHR-PRO transmits 3 syncs + 35 bits. The 1WSHR-PRO is a structural sub-variant of 1WG3R: same RF protocol family, same pulse widths within tolerance, slightly different framing. Since we replay verbatim (don't decode), the divergence is cosmetic.

Recorded all of this in `sdr/analysis/framing.md` (public, commit `0df2936`).

## Firmware rewrite — KeeLoq → fixed-code replay

Pushed as commit `80bef8d`. 12 files, 571 insertions, 427 deletions.

**Removed:**
- `controller.py`: counter persistence (`_load_counter` / `_save_counter` / `COUNTER_FILE` / `self.counter` / the `json` import).
- `compustar.py`: `build_packet` / `build_hopping_code` / TE-based `packet_to_pulses` (3 functions ~80 LOC).
- `secrets.py.example`: `COMPUSTAR_DEVICE_KEY` / `COMPUSTAR_SERIAL` / `COMPUSTAR_COUNTER`.
- `config.py`: `RF_TE_US`.
- `preflight.py`: device-key / serial / counter checks.

**Added:**
- `compustar.py`: `parse_bit_pattern()`, `packet_to_pulses()` with symmetric PWM, `build_pulses_for_button()`, `validate_packets()`, `Button` class (string identifiers).
- `controller.py`: `_transmit_button(button_name)` with graceful failure modes (missing dict / missing key / malformed pattern → emit `compustar_tx_fail` event, don't crash).
- `secrets.py.example`: `COMPUSTAR_REMOTE_ID` + `COMPUSTAR_PACKETS` dict (35-char bit patterns per button, with leniency for whitespace / `_` / `-` separators).
- `preflight.py`: `validate_packets()` call + placeholder-pattern warning.

**Renamed:**
- Both `pi_link.py` ends: `EVENT_KEELOQ_TX(_FAIL)` → `EVENT_COMPUSTAR_TX(_FAIL)`. Wire value `keeloq_tx` → `compustar_tx`.
- Dashboard `main.js` `EVENT_CLASS` map updated.

**Test totals:** 23 compustar + 17 controller + 9 integration + 4 keeloq + 6 cc1101 + 8 ads1115 + 5 persistence + 9 obd2 = **81 ESP32 tests passing**. Preflight clean.

The keeloq module + its tests are kept as-is — unused for this FOB but useful future-proofing for any HCS-KeeLoq variant a future reader might be working with.

## What's actually left

Still genuinely waiting on physical parts before the next round of new code work:

1. Update `framing.local.md` with the rtl_433-verified pulse widths (DONE — kept gitignored)
2. Copy `secrets.py.example` → `secrets.py` and fill in the 4 captured 35-bit bit patterns + Remote ID (will do when bench-testing transmit)
3. Bench-test transmit: load secrets, send Start packet via CC1101 at 433.968 MHz, confirm the car cycles (Lock first as a safety per the existing valet-switch protocol from `docs/12`)
4. Rewrite `docs/12-keeloq-bench-validation.md` to drop the KeeLoq framing and reflect the much simpler "store-and-replay" path. (Will do once the bench cycle confirms our captures are good.)
5. Mark `sdr/07-key-recovery.md` as not-applicable to this FOB, leave it in tree for any future HCS-KeeLoq variant.

Everything coded today is hardware-ready. The mental model went from "synthesize encrypted rolling-code packets" to "echo back the 35 bits we already captured" — a much smaller, much easier problem.

## Doc-cleanup round — `502f8ec`

The firmware was rewritten but the reproduction docs were still walking readers through KeeLoq recovery + HCS66 synthesis. Spent the post-rewrite round bringing them in line.

Renamed `docs/12-keeloq-bench-validation.md` → `docs/12-bench-validation.md` and rewrote it: secrets-populate workflow now expects `COMPUSTAR_REMOTE_ID` + the four 35-bit `COMPUSTAR_PACKETS` strings. The "counter desync after testing" warning is gone — fixed-code means no counter on either side, so bench-testing has zero effect on the real FOB.

Updated `sdr/05-demodulation.md` to direct readers to `demod-compustar.py` for the 1WG3R family (the project's actual case); kept `demod-ook.py` as the documented HCS-PWM fallback. Added an `rtl_433 -A` cross-check section showing how to verify pulse widths independently of our demodulator.

Rewrote `sdr/06-framing-extraction.md` for the simpler path: read the 16-bit Remote ID from any decoded packet, capture the 35-bit pattern per button once, record both in `framing.local.md`. The HCS-KeeLoq diff-based discovery (start-vs-start to isolate hopping bits, etc.) moved to an appendix.

Marked `sdr/07-key-recovery.md` with a "NOT NEEDED for Compustar 1WG3R-family FOBs" callout at the top. The original key-recovery content is preserved below for any reader whose FOB is an HCS-KeeLoq variant. The bottom "replicate the FOB" section was rewritten to note the `build_packet` API was removed and that HCS-KeeLoq users can either resurrect it from git history or write their own around the still-in-tree `keeloq.py`.

Cross-refs updated in `reproduce.md`, `day-one.md`, `11-uart-link.md`, `README.md`. `braindump.md` section-4 steps 1-6 marked done with notes on what shipped where; section-13 cheat sheet updated for a future Claude landing after this commit.

10 files, +732/-495 LOC. All 81 ESP32 tests still pass.

## Security pass — the leaks I caused and cleaned up

When user asked "the captures and other information that could be used to mess with my car is excluded or obfuscated?" I did a grep audit of committed files. Bad news: my own example code had leaked real values into committed text. Specifically:

- **Real 16-bit Remote ID** in seven files: `braindump.md` (3 places), `docs/12-bench-validation.md` (expected REPL output), `sdr/05-demodulation.md` (example demod output), `esp32/tests/test_controller.py`, `esp32/tests/test_integration.py`, `esp32/scripts/simulate.py`.
- **Real button code byte + its bitwise-NOT** in `sdr/05-demodulation.md`'s example demod output line.
- **Real 35-bit Start pattern** in `esp32/src/lib/compustar.py`'s `parse_bit_pattern` docstring example.
- **All four real 35-bit button patterns** (Start / Lock / Unlock / Trunk) in `sdr/06-framing-extraction.md`'s "fill framing.local.md" and "populate secrets.py" example blocks.

Combined, that's enough material to remotely operate the user's car. Not just operationally sensitive — actively dangerous.

Scrubbed everything in commit `6e82722`:

- Every real Remote ID literal → `0x____` / `0x<your-fob-id>` / `0xXXXX` placeholders, except test fixtures which use the obviously-synthetic `0xABCD`.
- The compustar.py docstring pattern → an alternating filler that's clearly synthetic.
- The four pattern literals in sdr/06 → `<35 chars from your demod output>` placeholders, with an explicit "don't post your real captured patterns publicly" callout.
- The button=0x9F / ~button=0x60 in sdr/05 → `0x<bc>` / `0x<~bc>` placeholders.

Then realized in the same audit that `braindump.md` itself shouldn't be public regardless — it's a Claude-session context-preservation document with operational details and forward-looking project state. Untracked it via `git rm --cached braindump.md` + gitignore entry in `379e2b1`. Local copy still on disk for future sessions; just not pushed.

The scrub only fixes HEAD. The leaked values still live in the blob objects of commits `0fa7dc8 .. 502f8ec` on GitHub, accessible via direct SHA URL until GitHub's GC reaps them (default ~90 days). Wrote a force-push history-rewrite procedure at `tools/scrub-history/` (gitignored — its `replacements.txt` lists the leaked literals on the LEFT side of each substitution rule, so committing it would be a re-leak):

1. `pip install git-filter-repo`
2. Backup bundle via `git bundle create`
3. `git filter-repo --path braindump.md --invert-paths --force` (removes braindump.md from every historic commit)
4. `git filter-repo --replace-text replacements.txt` (substitutes the literal Remote ID + button codes + bit patterns across all remaining blobs)
5. Verify with `git log --all -S "..."` greps
6. Re-add `origin` (filter-repo strips it as a safety)
7. `git push --force-with-lease origin main`
8. Optional: email GitHub Support to request immediate GC

User chose this path. Waiting for them to run it locally.

`.gitignore` updates today:
- `tools/scrub-history/` — the working dir for the history rewrite (must never be committed; its content includes the leaked literals).
- `braindump.md` — context-preservation doc that shouldn't be public regardless.

Existing gitignore rules that worked correctly:
- `sdr/analysis/framing.local.md` — the actual values lived here the whole time, never tracked.
- `sdr/captures/*` — raw IQ + bits files.
- `esp32/src/secrets.py` — never created on disk yet, will be gitignored when populated.

## End-of-day commit summary

| Commit | What |
|---|---|
| `0df2936` | sdr/analysis/framing.md: record rtl_433 -A ground-truth verification |
| `80bef8d` | firmware: replace KeeLoq path with 1WSHR-PRO fixed-code packet replay (12 files, +571/-427) |
| `1bebd81` | logs/2026-05-24: add late-day plot twist + firmware rewrite milestone |
| `502f8ec` | docs: rewrite reproduction docs for Compustar fixed-code path (10 files, +732/-495) |
| `6e82722` | security: scrub real FOB identifying values from committed docs + code |
| `043ae74` | gitignore: exclude tools/scrub-history/ working directory |
| `379e2b1` | security: untrack braindump.md, exclude from future commits |

Plus this log update.

## Final state

- Phase 1 (SDR analysis): **done**. Pulse widths verified, four button patterns captured, Remote ID known. All in `framing.local.md` (gitignored).
- Phase 2 (ESP32 + Pi firmware): **done**. 81 tests passing. Capture-and-replay path works end-to-end in CPython simulation. Awaiting parts for hardware bench validation per `docs/12-bench-validation.md`.
- Phase 3 (in-car install): blocked on parts.
- Security: HEAD on GitHub is clean. History rewrite procedure prepared locally; user-initiated whenever convenient.

The day went from "demodulator is at 80% accuracy and we're stuck" to "we don't need the demodulator's interpretation at all because the protocol is fixed-code; capture-and-replay handles everything". Net: one of those productive days where the win is in throwing away code that turned out to be solving the wrong problem.
