SixOfFive/2009_kia_spectra/logs/2026-05-23.md

# 2026-05-23 — project kickoff

First working session. Established the project scope, architecture, and parts list end-to-end. No hardware yet.

## What was decided today

### Architecture — hybrid ESP32 + Pi Zero 2 W

After exploring three architectures (Pi-only, ESP32-only, hybrid), settled on the hybrid:

- **ESP32**: always-on monitor, real-time RF transmit (CC1101), native CAN bus (TWAI), deep sleep at sub-mA
- **Pi Zero 2 W**: 5" HDMI touchscreen UI, map display, web UI for home monitoring, MQTT publisher
- UART communication between them, ESP32 power-gates the Pi via a logic-level AO3401A P-MOSFET

Rationale: the Pi's WiFi + Linux is what makes home monitoring + maps possible. The ESP32's sub-mA deep sleep is what makes 24/7 battery monitoring possible without draining the car. Each does what it's good at.

### Connection: OBD-II only

Single-point connection through the OBD-II port via a passive Y-splitter:
- Pin 16 (+12V, always-hot) → fused 12V input
- Pin 4/5 (GND)
- Pin 6 (CAN-H), Pin 14 (CAN-L) → SN65HVD230 transceiver

Y-splitter keeps the port available for scan tools. No splicing into the car's harness. 15-minute reversible install.

### Compustar trigger: software-synthesized Keeloq RF

The car has a Compustar 1WSHR-PRO FOB (FCC ID 7087A-R762A433) already installed. The brain is somewhere behind the dash but not visually accessible without disassembly.

Instead of finding the brain's hardwire start input, we'll have the ESP32 transmit a valid Keeloq packet over 433.92 MHz via a CC1101 module. Keeloq has been academically broken; with owner-access to the FOB the practical attacks (chip EEPROM read, manufacturer-key databases) make this very feasible.

Plan:
1. SDR capture of FOB transmissions (RTL-SDR Vomeko dongle on hand)
2. URH analysis to identify framing, serial, function codes
3. Extract device key (Flipper Zero database first, PICkit fallback)
4. MicroPython Keeloq encoder driving CC1101

### Final BOM: $260 CAD for one unit

Detailed in [`docs/BOM.md`](../docs/BOM.md). Single-unit scope so the build is reproducible by anyone reading this repo.

## Compustar discovery photos

Found the brain area while exploring under-dash:
- Identified factory Siemens VDO ECU (D53K label) — not the Compustar
- Spotted the Compustar brain partially obscured behind wiring tape
- Could not photograph the brain's model number despite trying — too tight an angle
- Identified the Compustar windshield antenna (small black 3-LED wedge top-center of windshield)

The model-number obstacle is what pushed us from "find the brain's start trigger wire" to "synthesize the RF packet ourselves." Better outcome anyway — fully reversible install.

## Repository created

- Initial commit: `c630416`
- Pushed to https://github.com/SixOfFive/2009_kia_spectra
- Scaffolding: README, BOM, architecture doc, Compustar research, SDR workflow doc, esp32/ and pi/ stub READMEs

## Process rules established for this project

- Auto commit + push after every change ([memory: vroom-auto-commit])
- Daily log in `logs/YYYY-MM-DD.md` ([memory: vroom-daily-log])
- Single-unit documentation scope for public reproducibility ([memory: vroom-scope])

## Shopping run — late afternoon

Dispatched 4 parallel browser-MCP agents to shop the BOM (build for 2 units) across Amazon.ca and AliExpress, plus 3 follow-up agents for cleanup, SD swap, and tools.

**Final cart subtotals (pre-tax, pre-shipping):**
- Amazon.ca: ~$555.45 CAD (21 items)
- AliExpress: ~$121.60 CAD (12 items)
- **Grand total: ~$677 CAD** for both units + missing tools

**Decisions made during shopping:**
- **Pi Zero 2 W**: $38.35 each on Amazon (market reality vs original $25 target)
- **SD card**: chose SanDisk Ultra 32GB 2-pack at $56.22 instead of Extreme (saved $26)
- **5" display**: Elecrow capacitive touchscreen with integrated USB-A for touch — eliminated the separate USB cable line item
- **ESP32-WROOM-32U**: huge AliExpress win at $3.12 each (vs ~$18 Amazon)
- **Buck converter**: huge AliExpress win at $6.09 each (vs ~$19 Amazon)
- **AO3401A MOSFETs**: 100-pack from AliExpress at $3.59 (way more than needed but cheapest)
- **Wire stripper**: AliExpress generic at $13 (Klein 11057 was $38, too pricey)
- **Hookup wire**: 28 AWG silicone kit instead of 26+22 — note this is on the thin side for the high-current display/Pi paths

**Tools added (user did not have these):**
- Precision wire strippers, liquid flux pen (3-pack), step drill bit (4-32mm), coping saw + blades, precision pliers set

**Items NOT in cart that may be needed later:**
- PICkit programmer ($30) — only if SDR-only Keeloq extraction fails
- Logic analyzer ($15) — only if SPI/CAN debugging gets weird
- Cellular modem + SIM — only for off-network monitoring

**Pending: cart audit before checkout.** Six agents touched the carts; running totals matched expected deltas but a manual count vs the master list is the safe move before placing the order.

## Late evening — orders placed

After several rounds of cart audits, scaling, and cleanup attempts (some agents crashed mid-task, some made silent errors like dropping the ESP32 line entirely), the user took over and placed the orders manually. Final state in carts at order time included:

- Single-unit car-project parts (ESP32, Pi Zero 2 W, Elecrow display, SanDisk Ultra 2-pack, CC1101, ADS1115, SN65HVD230, OBD-II Y-splitter + male pigtail, buck converter, antennas, etc.)
- Extras + future-project additions added during the session: GeeekPi Pi Zero aluminum case, MB102 breadboards 10-pack, additional ESP32-WROOM-32U boards (up to qty 5 for future standalone projects), micro-USB cable 5-pack, AO3401A 100-pack, possibly some ESP32-S3 boards
- Various small tools the user didn't have: precision pliers, coping saw, wire stripper, step drill bit, flux pens

**Lessons learned for future agent-driven shopping:**
- Long-running browser-MCP agents (>5min, >30 tool calls) crashed with socket errors twice in this session
- Cart quantity decrements can silently go to zero (and silently remove the line entirely) if the agent miscounts. Verify after each quantity change.
- Multi-agent shared cart sessions lose state visibility — agents reading the cart at different times see different states. Re-audit is required after every batch of changes.
- Amazon's Asurion Protection Plan modal must be dismissed after every add-to-cart or subsequent adds appear to fail silently
- AliExpress sometimes opens product pages in new tabs when clicking thumbnails — navigate directly to product URLs to stay in the assigned tab
- "Find" tool burns context — prefer `read_page` with `filter="interactive"` and small `max_chars`
- **The "$3 ESP32-WROOM-32U" AliExpress listing the agent kept selecting was a variant-selector trap**: the cheap default variant is just the bundled 2.4 GHz antenna, NOT the board itself. The actual board variant on the same listing is buried deeper at $8-12. The user caught this manually before checkout and picked legitimate alternatives. Documented in [`docs/BOM.md`](../docs/BOM.md#buyer-warning--esp32-wroom-32u-on-aliexpress).

## Late-night code sprint — first 5 modules + tests + dashboard skeleton

Pushed the first code while waiting for parts to ship. Hardware-independent pieces only — everything in this round can be developed and tested on a desktop with plain Python.

| Commit | What |
|---|---|
| `c87e1e7` | `esp32/src/lib/keeloq.py` — KeeLoq block cipher (528 rounds, 32-bit block, 64-bit key) + 4 tests |
| `340c309` | `esp32/src/lib/compustar.py` — HCS66 packet builder + PWM OOK pulse generator + 6 tests |
| `f0ef5a4` | `esp32/src/lib/obd2.py` — 14-PID dict + single-frame ISO 15765-4 query/parse + 9 tests |
| `53cde0e` | `esp32/src/lib/pi_link.py` + `pi/app/comms/esp32_link.py` — line-delimited JSON UART protocol, symmetric on both sides + 6 tests |
| `74a83eb` | `esp32/src/config.py` + `pi/app/config.py` + secrets templates |
| `3cd569e` | `pi/app/display/` — Flask dashboard skeleton: server + dashboard.html + dark-theme CSS + 1Hz polling JS, 6 gauges, 3 buttons |

**Test totals**: 25 passing tests (4 keeloq + 6 compustar + 9 obd2 + 6 pi_link).

**Things confirmed in pure software**:
- KeeLoq cipher matches the canonical fixed point `encrypt(0,0) = 0` and is round-trip consistent — implementation structurally correct.
- HCS packet structure assembles to exactly 66 bits as specified.
- OBD-II PID parsing produces correct values from canned CAN frames (1726 RPM from 0x1AF8, 14.0V from 0x36B0, etc.) matching SAE J1979 formulas.
- Pi ↔ ESP32 schema is symmetric: encoding from either side decodes cleanly on the other.

**Still placeholder** (need SDR captures or actual hardware to confirm):
- Compustar function codes (START / LOCK / UNLOCK / TRUNK 4-bit values)
- TE timing (currently 400µs assumed; HCS chips can be configured 25-1600µs)
- Preamble length and header gap
- Device key, FOB serial, initial counter — these go into `secrets.py` after we read them off the FOB (PICkit) or recover via SDR analysis

**Dashboard preview**: served by `python pi/app/display/server.py` on port 8000. Currently uses mocked STATE — wiring it to the UART listener thread is a Day-3-with-hardware task.

## Next session

When parts arrive:

1. Inventory the boxes — confirm everything that was ordered actually showed up, and identify any DOA modules early
2. Flash MicroPython onto the ESP32
3. Smoke-test each module on breadboard one at a time (ADS1115, CC1101, SN65HVD230, ESP32 WiFi)
4. Begin SDR captures of the FOB at 433.92 MHz
5. Open captures in URH, document framing in `sdr/analysis/framing.md`
6. Wire the dashboard's STATE dict to a real UART listener thread reading from the ESP32

Until then: wait for shipping.

## Late-evening continuation — SDR helper scripts written

User asked to do the SDR walkthrough now and test it once hardware is hooked up. Built the four helper scripts the walkthrough references, plus the scaffolding the docs need to be followable end-to-end without further coding.

| Script | Used in | Purpose |
|---|---|---|
| `sdr/scripts/plot-power-csv.py` | steps 02, 03 | Aggregate an `rtl_power` CSV, report top peaks + noise floor |
| `sdr/scripts/diff-bits.py` | step 06 | Compare two `.bits` files, report differing positions + contiguous runs |
| `sdr/scripts/try-mfkeys.py` | step 07 (Path A) | Brute-force a Flipper-style manufacturer-key database; supports simple + normal HCS derivation |
| `sdr/scripts/validate-key.py` | step 07 | Decrypt N captures with a candidate device key, check counter increments by 1 |

End-to-end sanity test passed: built three synthetic encrypted packets with our keeloq module, ran `try-mfkeys.py` against a 3-entry test keystore, got the expected HIT line, then ran `validate-key.py` against the three captures and got `All deltas = 1. Key is almost certainly correct.`

Other scaffolding:
- `sdr/scripts/README.md` — table of the four scripts
- `sdr/analysis/framing.md` — skeleton template the user fills in across steps 03 → 07
- `sdr/captures/.gitkeep` + gitignore tweak (`sdr/captures/*` + `!sdr/captures/.gitkeep`) so the dir exists in fresh clones
- `sdr/analysis/press-logs/.gitkeep`
- Updated steps 02, 06, 07 to point at the real script files instead of "to be created"
- Updated `sdr/README.md` directory tree

The walkthrough is now self-contained: when the SDR is hooked up to the bench, the user can follow steps 01 → 07 and run each `python sdr/scripts/...` command as it appears.

## Even later — drivers, state machine, Pi daemon

Continued the "keep going" pass through braindump section 11 (hardware-dependent code). Most of it can be written cold from datasheets and unit-tested with mocks — only smoke-testing on real hardware has to wait for parts.

### ESP32 hardware drivers (commit `77e45d5`)

| File | Highlights |
|---|---|
| `esp32/src/lib/cc1101.py` | SPI driver for the TI CC1101 transceiver. Configured for 433.92 MHz async OOK where we bit-bang GDO0 with the PWM-encoded pulse sequence from `compustar.packet_to_pulses`. GC is disabled during transmit so a collection cycle can't stretch a low-pulse. At TE=400µs the per-bit timing has comfortable MicroPython overhead headroom. |
| `esp32/src/lib/ads1115.py` | I2C driver for the 16-bit ADC, single-shot single-ended read with selectable PGA. Includes `raw_to_volts` helper and two's-complement decode. Sized for the 30k/10k battery divider documented in `config.py`. |
| `esp32/src/lib/twai_can.py` | Thin wrapper around `machine.CAN` for OBD-II 500 kbps. Raises a loud `ImportError` at construction if the MicroPython build doesn't include CAN/TWAI — fail at the bench rather than during a drive. Includes a `query_pid()` helper that handles broadcast 0x7DF + 0x7E8..0x7EF response matching. |

All three include CPython fallbacks (no-op `machine`/`I2C`/`SPI` shims) so they import on a desktop for unit testing. **14 new tests pass** (6 cc1101 + 8 ads1115).

### ESP32 state machine (commit `6057252`)

`esp32/src/controller.py` + thin `esp32/src/main.py` boot entrypoint.

States: `MONITORING → STARTING → RUNNING → STOPPING → COOLDOWN`. Persistent Compustar rolling counter saved to flash **before** RF transmit so a mid-burst crash doesn't reuse a counter value the receiver would reject. UART command dispatch handles `start_engine`, `stop_engine`, `set_threshold`, `shutdown_pi`, `ping` with ACKs. Hardware refs injected at construction so the controller is unit-testable without real hardware.

**9 new controller tests pass**: initial state, no-trigger on normal V, sustained low-V triggers state transition + RF + Pi power-on, counter increment + persistence, UART dispatch, stop sequence powers off Pi after grace, unknown commands ack failure.

### Pi daemon + provisioning (commit `ad89a9a`)

Single-process design: Flask main thread + uart-listener daemon thread + mqtt-publisher daemon thread, all share `pi/app/state.py`'s STATE dict under a lock. No IPC needed.

- `pi/app/state.py` — thread-safe STATE + `ESP32_LINK` singleton + `snapshot()` returning a JSON-safe copy
- `pi/app/comms/uart_listener.py` — reads ESP32 messages, dispatches STATUS/OBD/EVENT/LOG into STATE; ESP32-initiated `shutdown_pi` triggers `shutdown -h +1`
- `pi/app/comms/mqtt_publisher.py` — paho-mqtt client publishes snapshot to `<prefix>/state` retained, reconnects on failure, no-ops if paho isn't installed
- `pi/app/display/server.py` — refactored to use shared state, `/api/command` actually forwards to the ESP32 via the link (returns 503 if link not registered)
- `pi/app/daemon.py` — production entrypoint, run with `python -m pi.app.daemon`
- `pi/systemd/vroom.service` — restart-on-failure, output to journal
- `pi/setup/provision.sh` — idempotent first-boot Pi setup: apt packages, paho-mqtt pip install, enable serial hardware, clone repo to `/opt/vroom`, sudoers.d entry for passwordless shutdown, install systemd unit, chromium kiosk autostart pointing at `http://localhost:8000`

**9 new uart_listener dispatch tests pass.**

### Test totals

**57 tests across the project, all green**: 4 keeloq + 6 compustar + 9 obd2 + 8 ads1115 + 6 cc1101 + 9 controller + 6 esp32_link + 9 uart_listener.

### What's left from braindump §11

All hardware-dependent ESP32 + Pi code is now written. Outstanding items:

- Smoke-test each driver on real hardware once parts arrive (the obvious one)
- Deep-sleep optimization for MONITORING (move low-V streak to RTC memory)
- Resume-from-flash on boot if the state was RUNNING (e.g. after watchdog reset)
- Phase 2-4 reproduction docs in `docs/reproduce.md` (bench prototype walkthrough, in-car install, polish) — these get written as the phases happen
- Validate `Compustar.Function` codes via SDR (placeholders in `compustar.py` until then)
- Tune Compustar TE / preamble / gap to measured values
