SixOfFive/2009_kia_spectra/docs/images/obd2-power-pinout.png

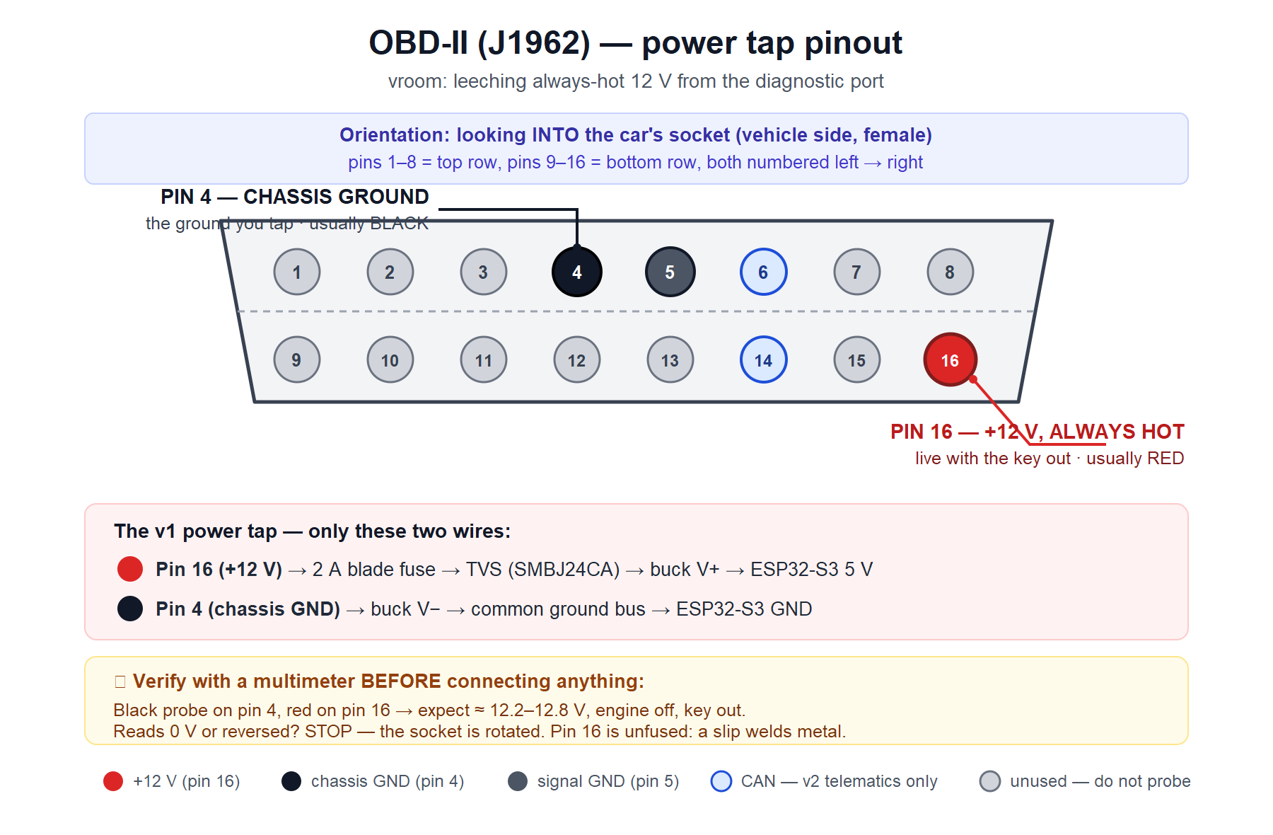
docs/images/obd2-power-pinout.png
