SixOfFive/2009_kia_spectra/esp32-s3/docs/wiring-breadboard.png

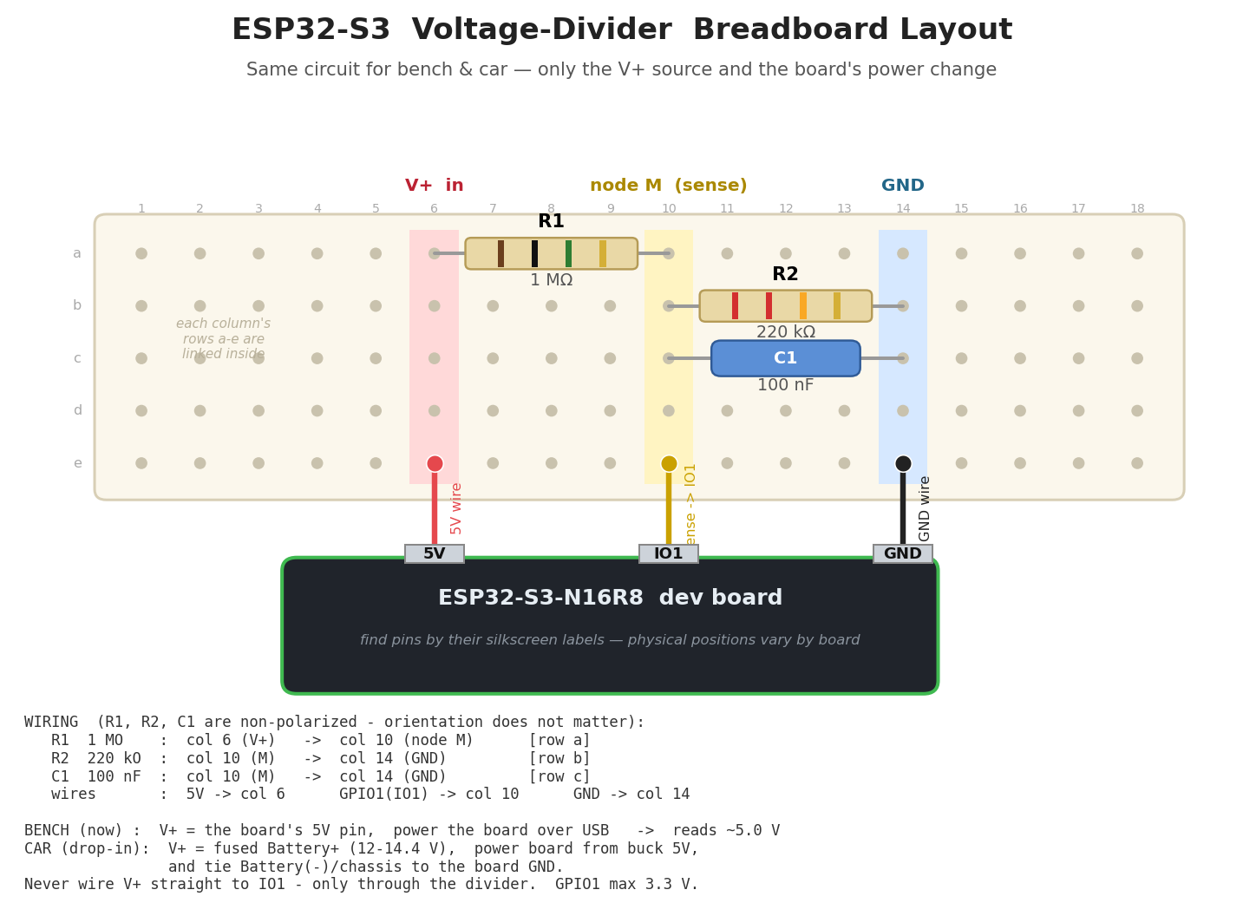
esp32-s3/docs/wiring-breadboard.png
