SixOfFive/2009_kia_spectra/esp32-s3/voltage_monitor/voltage_monitor.ino

// voltage_monitor.ino
// ESP32-S3-N16R8 voltage monitor with on-device history + live web dashboard.
//
//   * Reads a resistor divider on GPIO1, scales to the real source voltage.
//   * Records a rolling 24 h history (1440 samples @ 60 s) in PSRAM of:
//       voltage, chip temp, free heap, disk used, net bytes in, net bytes out.
//     History is snapshotted to the LittleFS filesystem every 10 min and reloaded
//     on boot, so it survives reboots. Served as CSV at /history -> the browser
//     RENDERS the graphs from the ESP32 (refresh / AP mode show real history).
//   * WiFi STA; on boot-failure OR 5 min of lost connection -> Access-Point
//     fallback (own DHCP/router at 192.168.4.1) so the dashboard stays reachable.
//
// Build / flash (KEEP the PartitionScheme - maps the full 16 MB incl. the FS):
//   arduino-cli compile --fqbn esp32:esp32:esp32s3:PSRAM=opi,FlashSize=16M,PartitionScheme=app3M_fat9M_16MB -u -p COM6 <this folder>

#include <Arduino.h>
#include <WiFi.h>
#include <WebServer.h>
#include <ESPmDNS.h>
#include <DNSServer.h>
#include <LittleFS.h>
#include <Update.h>
#include <SPI.h>
#include <time.h>
#include <Preferences.h>   // NVS-backed persistence for CPU clock + WiFi power-save
#include "esp_task_wdt.h"   // task watchdog -- auto-reboot if the loop or safety task stalls
#include <lwip/sockets.h>   // select() -- gate chunked sends without blocking (see waitWritable)
#include "esp_system.h"     // esp_reset_reason() -- why the last boot happened
#include "esp_core_dump.h"  // fw 4.79: /coredump -- where the last panic was
#include "esp_partition.h"  // fw 4.79: reading the coredump partition
#include "esp_sntp.h"       // NTP sync notification callback
#include "esp_wifi.h"       // esp_wifi_set_protocol() -- force 802.11b for range/stability
#include <BLEDevice.h>      // stack placed once at boot and kept up (fw 4.76): scans, connect test, OBD link
#include <BLEScan.h>
#include <BLEAdvertisedDevice.h>
#include <BLEClient.h>      // /btconnect -- can the board talk to a dongle, not just see it
#include <BLERemoteService.h>
#include <BLERemoteCharacteristic.h>
#include "obd_elm.h"      // OBD pages: ELM327 reply parsing and J1979 decoding, host-tested
// Defined with the OBD log further down but called earlier -- by the safety task's
// edge detector and by /obdjson -- and the Arduino builder's generated prototypes
// missed both.
bool obdEngineFresh(uint32_t nowMs, ObdEngine* out);
void obdLogRecount();
#include "esp_attr.h"       // RTC_NOINIT_ATTR -- WDT breadcrumbs that survive a reset
#include <stdarg.h>         // logLine() variadic formatting
#include <Adafruit_GFX.h>
#include <Adafruit_ILI9341.h>
#include <XPT2046_Touchscreen.h>
#include <Fonts/FreeSansBold24pt7b.h>
#include <Fonts/FreeSans12pt7b.h>
#include "cc1101_compustar.h"
#include "snmp_agent.h"

// secrets.h (gitignored) holds WiFi credentials + the per-FOB captured
// Compustar patterns. The repo ships only secrets.h.example. Without a
// real secrets.h the firmware still builds and runs (AP-only, RF disabled)
// using the placeholders below -- nothing secret is committed.
#if __has_include("secrets.h")
  #include "secrets.h"
#else
  #define SECRET_WIFI_SSID "your-wifi"
  #define SECRET_WIFI_PASS "your-password"
  #define SECRET_AP_PASS   "esp32volt"
  #define COMPUSTAR_PATTERNS_CAPTURED 0
  #define COMPUSTAR_START  "00000000000000000000000000000000000"
  #define COMPUSTAR_LOCK   "00000000000000000000000000000000000"
  #define COMPUSTAR_UNLOCK "00000000000000000000000000000000000"
  #define COMPUSTAR_TRUNK  "00000000000000000000000000000000000"
#endif

// ----------------------- user config -----------------------
// WiFi + AP credentials come from secrets.h (gitignored). See the
// secrets include block above for the placeholder fallback.
const char* WIFI_SSID = SECRET_WIFI_SSID;
const char* WIFI_PASS = SECRET_WIFI_PASS;
const char* HOSTNAME  = "esp32-volt";       // -> http://esp32-volt.local/

const char* AP_SSID   = "ESP32-Volt";       // fallback Access Point (its own DHCP @ 192.168.4.1)
const char* AP_PASS   = SECRET_AP_PASS;      // from secrets.h (8+ chars, or "" for open)

// ---- Runtime-configurable WiFi (NVS-backed) -------------------------------
// Everything below can be changed from the WiFi tab and survives reboots. The
// constants above are only the FIRST-BOOT defaults, used until the NVS keys
// exist. secrets.h therefore seeds the config; it no longer dictates it.
//
// Safety note: this device lives behind a dash and can start a car. A bad SSID
// or password would strand it on its fallback AP with no way to fix it, so
// credential changes go through applyPendingWifi() -- try, verify, and revert
// automatically if the new network does not come up.
String   g_sta_ssid, g_sta_pass;          // home network
String   g_ap_ssid,  g_ap_pass;           // fallback AP
String   g_hostname;
uint8_t  g_ap_auth    = 1;                // 0 open, 1 WPA2-PSK, 2 WPA/WPA2 mixed, 3 WPA2/WPA3
uint8_t  g_ap_chan    = 1;                // fallback AP channel
bool     g_ap_hidden  = false;
uint8_t  g_sta_minsec = 2;                // min accepted AP security: 0 any, 1 WPA, 2 WPA2, 3 WPA3
                                          // (2 = the Arduino default, i.e. today's behaviour)
uint32_t g_ap_after_s = 300;              // home WiFi down this long -> raise the AP
uint32_t g_ap_retry_s = 600;              // from the AP, retry home this often
uint32_t g_ap_wait_s  = 10;               // how long each retry waits for a join
uint32_t g_boot_s     = 20;               // boot-time connect window
float    g_tx_dbm     = 19.5f;            // TX power (snapped to the nearest supported step)
uint8_t  g_proto      = 7;                // bit0 = 11b, bit1 = 11g, bit2 = 11n, bit3 = LR

// Pending credential switch, driven from loop() so the HTTP reply gets out first.
bool     g_wifiPend    = false;
String   g_pendSsid, g_pendPass;

// Forward declarations: the /wificfg handlers appear earlier in this file than
// these helpers, and Arduino's auto-prototype pass does not cover statics.
static void             applyWifiRangeProfile();
float                   longTermMvph(float vNow);
float                   smoothedVoltsRecent(int n);
void                    seedLongTermFromHistory();
long                    longTermEtaS(float vNow);
static wifi_auth_mode_t staMinAuth();
static uint8_t          protoBits();
static wifi_power_t     txEnumFor(float dbm);


const char* FW_VERSION = "4.80";
// Compile stamp, so a board in the field can be matched to a build without
// guessing from the version alone (two flashes can share a version during
// development). Shown in the footer of every page and in /json.
const char* FW_BUILD   = __DATE__ " " __TIME__;            // 4.34 = live sustain countdown on Main + every countdown start/reset logged with its reason

// ----- NTP time sync (only when WiFi STA is connected) -----
const char* NTP_SERVER1 = "time.windows.com";
const char* NTP_SERVER2 = "pool.ntp.org";
// POSIX TZ for Mountain Time (Edmonton/Alberta) incl. DST. Change this one
// string if you're elsewhere -- it only affects on-device localtime; the
// dashboard formats per-sample timestamps in the browser's own timezone.
const char* TZ_INFO = "MST7MDT,M3.2.0,M11.1.0";
const uint32_t NTP_RESYNC_MS = 6UL * 3600UL * 1000UL;   // re-sync every 6 h (drift)

const int   VSENSE_PIN = 1;                 // GPIO1 = ADC1_CH0 (ADC1 = safe with WiFi on)
const float DIVIDER    = 5.545f;            // (1M + 220k) / 220k
float       CAL        = 1.000f;            // calibration trim

const int      HIST_N     = 1440;           // ring-buffer length (24 h @ 60 s)
const uint32_t SAMPLE_MS  = 60000;          // one history sample per 60 s
const uint32_t SAVE_MS    = 600000;         // snapshot history to flash every 10 min
const uint32_t AP_AFTER_DOWN_MS = 300000;   // 5 min of lost WiFi -> Access Point
// ...and once in AP mode, keep trying to get back onto the home network. Without
// this the fallback is a one-way door: a brief router hiccup strands the board
// in SoftAP until someone power-cycles it. In a parked car that means it is
// unreachable AND drawing roughly double (AP mode has no power save at all).
const uint32_t AP_RETRY_STA_MS  = 600000;   // from AP, re-try the home WiFi every 10 min
const uint32_t AP_RETRY_WAIT_MS = 10000;    // how long to wait for the join
const int      SAMPLES    = 64;             // ADC averaging

// Onboard RGB LED voltage indicator (volts):
//   > 14.6 or < 9.0  -> RED    (over-voltage or too low)
//   12.0 .. 14.6     -> GREEN  (good)
//   9.0  .. 12.0     -> BLUE   (low-ish)
const bool     LED_ENABLED = false;         // physical LED OFF for now; set true near deployment
const int      LED_PIN    = 48;             // onboard WS2812; if unresponsive try 38 or 47
const float    V_LOW      = 9.0f;
const float    V_MID      = 12.0f;
const float    V_HIGH     = 14.6f;
const uint8_t  LED_BRIGHT = 32;             // 0-255

// 2.4" ILI9341 + XPT2046 SPI display (set false to disable)
const bool DISPLAY_ENABLED = false;         // display set aside for now; flip true to re-enable
const int  TFT_SCLK = 12, TFT_MOSI = 11, TFT_MISO = 13;
const int  TFT_CS = 10, TFT_DC = 9, TFT_RST = 14, TFT_BL = 21;
const int  TS_CS = 8, TS_IRQ = 7;

// CC1101 433.92 MHz OOK transmitter (Compustar 1WG3R replay).
// 3.3V logic ONLY -- the CC1101 is not 5V tolerant. Pins chosen to avoid
// the ADC voltage pin (GPIO1), the strapping pins (0/3/45/46), the
// flash/PSRAM pins (26-37), native USB (19/20), UART0 (43/44), the RGB
// LED (48), and the display pins (7-14, 21). See cc1101_compustar.h.
const bool     RF_ENABLED  = true;          // set false to skip CC1101 init entirely
const int      CC1101_SCK  = 18;
const int      CC1101_MISO = 17;
const int      CC1101_MOSI = 16;
const int      CC1101_CS   = 15;
const int      CC1101_GDO0 = 4;
const uint8_t  RF_TX_POWER = 0xC0;          // PATABLE[1]: 0xC0 ~ +10 dBm (max)
const uint8_t  RF_REPEATS  = 8;             // packet repeats per press (FOB sends ~8)
// Remote-start is a press-AND-HOLD on the real FOB (the SDR captures were ~10
// bursts over many seconds), and the brain deliberately wants the start code
// sustained before it will crank -- an anti-accidental-start guard. A short
// lock-length burst isn't enough. START therefore repeats far more (~4.5 s of
// continuous packets) to mimic a held button.
// START wake-up structure (the FOB precedes each start packet with a long
// carrier to wake the receiver's duty-cycled listener):
const uint16_t RF_WAKEUP_MS    = 1450;      // continuous wake-up carrier per burst (FOB ~1436 ms)
const uint8_t  RF_TRAIN_CELLS  = 6;         // ~750 us equal on/off training cells after the carrier (FOB ~5-6)
const uint8_t  RF_START_DATAREPS = 8;       // sync+data repeats after EACH carrier (FOB sends 8)
const uint8_t  RF_START_BURSTS = 1;         // ONE burst per press, exactly like the FOB. Was 3 (over-
                                            // engineered from a long-hold capture); a 2nd start command
                                            // ~2.5 s later can read as a re-press and CANCEL the start.
const uint16_t RF_GUARD_MS = 39;            // silence between bursts
// fw 4.1: SDR timeline of the FOB (sdr/captures/fob-60s-2026-08-06.bin) showed
// the 8 data packets are spaced only ~1.1 ms apart -- back-to-back inside the
// window the carrier just woke -- and a ~0.5 s carrier trails the data. Our 4.0
// spaced packets 39 ms apart and sent no tail, so the receiver likely dropped
// bit-clock lock between packets. Match the FOB exactly.
const uint16_t RF_START_PKT_GAP_MS = 1;     // gap between the 8 data packets (FOB ~1.1 ms)
const uint16_t RF_TAIL_CARRIER_MS  = 525;   // trailing carrier after the data (FOB ~525 ms)

// ----- Low-voltage auto-start (OPT-IN -- ships DISABLED) -----
// When ARMED, the firmware fires the Compustar START code by itself once
// battery voltage has stayed at or below the threshold continuously for the
// hold time. The point is to start the engine while the battery can still
// crank, so the alternator puts charge back before it goes flat.
//
// Why a sustain time at all: cranking the engine yanks terminal voltage down
// to ~9-10 V for a second or two. Requiring the low reading to persist for a
// full minute means a real crank (or a momentary load like the blower) can
// never be mistaken for a flat battery.
// Default trigger is 12.2 V (changed from 12.4 V on 2026-08-12).
//
// The cold-weather argument for 12.4 V is real and worth keeping on record:
//   * Cold cranking. Near -20 C the engine needs roughly double the torque
//     while the battery can deliver only about half its rated power, so the
//     "still cranks" line moves UP a couple tenths from the mild-weather value.
//   * Electrolyte freezing. 12.2 V resting is about SG 1.19, which slushes up
//     around -26 C. 12.4 V is ~SG 1.23, good to about -37 C.
//
// It is nevertheless the wrong number FOR THIS CAR, on measurement rather than
// theory. This battery settles at about 12.30 V after days parked. A 12.4 V
// trigger therefore sits ABOVE its resting voltage: the board would fire at
// once, then need 12.55 V (threshold + AS_REARM_MARGIN) held for AS_REARM_S to
// re-arm -- a level this battery never reaches without a long drive. It would
// fall through to the AS_REARM_MAX_COOLDOWNS escape hatch and start the engine
// every cooldown, indefinitely. A threshold above resting voltage is not a
// safety margin, it is a loop.
//
// The honest reading of a 12.30 V rested battery is ~60 % SoC on a pack that no
// longer holds a full charge -- consistent with the two batteries this car has
// already killed. Raising the trigger cannot fix a tired battery; it only makes
// the starter run more. Revisit if the battery is replaced, or once the
// parasitic drain is located: a healthy pack resting at 12.6-12.7 V would carry
// a 12.4 V trigger comfortably, and in deep cold it should.
const float    AS_DEF_VOLTS     = 12.2f;    // suggested trigger (V) -- see above
const uint32_t AS_DEF_HOLD_S    = 60;       // must stay below threshold this long
const uint32_t AS_DEF_COOL_S    = 7200;     // 2 h between VERIFIED auto-starts (anti-loop)
// Gap before retrying a start that produced NO charging. This is a different
// risk from the cooldown above and deserves its own number. A cooldown exists
// because the engine ran: firing again soon would toggle a running engine off
// and waste fuel. A failed start is positive evidence the engine is NOT running,
// so an early retry cannot toggle anything off -- and on 2026-08-15 the first
// burst was simply ignored by the Compustar while the retry started the car in
// 19 s, so waiting a full cooldown just drains the battery for nothing.
// The verification window (AS_VERIFY_S, 180 s) is the effective floor: the
// g_verifying guard blocks any fire until it closes.
const uint32_t AS_DEF_RETRY_S   = 300;      // 5 min before retrying an unverified start
const float    AS_V_FLOOR       = 8.0f;     // below this the divider isn't on a battery
const float    AS_V_CEIL        = 16.0f;    // above this the reading isn't a plausible battery
const float    AS_ALT_V         = 13.2f;    // above this the alternator is running
const uint32_t AS_PARK_S        = 900;      // must sit below AS_ALT_V this long before arming
// Re-arm hysteresis: after a start the battery must climb back above the
// trigger by this margin and hold, so a battery sitting right at the trigger
// doesn't re-fire every cooldown. Deliberately RELATIVE to the threshold, not a
// fixed 12.55 V -- on a tired battery that can only recover to, say, 12.5 V a
// fixed bar would never be met and auto-start would silently stop working.
// AS_REARM_MAX_COOLDOWNS is the escape hatch for the same reason: hysteresis
// may delay a start, it must never be able to block one permanently.
const float    AS_REARM_MARGIN  = 0.15f;    // must recover to (threshold + this)...
const uint32_t AS_REARM_S       = 600;      // ...and hold it this long
const uint8_t  AS_REARM_MAX_COOLDOWNS = 2;  // after this many cooldowns, re-arm anyway
const uint32_t AS_VERIFY_S      = 180;      // after firing, expect charging within this
// An engine edge has to PERSIST, not just cross a voltage. Measured 2026-08-17:
// one continuous drive (13:21 -> 14:57) was recorded as FOURTEEN separate runs,
// several lasting 1-2 seconds, because the alternator dips below the off
// threshold (AS_ALT_V - 0.3 = 12.9 V) transiently at idle and under load. Every
// spurious OFF in that drive read 12.52-12.90 V while every ON read 13.2-14.2 V,
// so voltage alone cannot separate them -- the signal is genuinely crossing the
// line. Time can: the shortest gap that looked like a real stop in that drive
// was 164 s, and every artefact was under 60 s.
// The edge is TIMESTAMPED WHEN IT FIRST APPEARED, not when it was confirmed, so
// run durations and the gaps between runs stay exact.
// The off edge was AS_ALT_V - 0.3 = 12.90 V until 2026-08-19, when a run that
// ended ~12:57 had still not closed 36 minutes later. A battery that has just
// been charged holds SURFACE CHARGE well above its rested voltage, and that
// afternoon it plateaued at 12.91-12.99 V -- straddling the old threshold, so
// the detector never saw the engine stop. Left alone it self-clears once the
// surface charge decays, but the OFF is then timestamped ~45 min late, which
// inflates the run and starts the 12 h long-term anchor from the wrong moment.
// Measured separation that day, which is what 13.10 V is chosen from:
//   engine actually running   13.58 - 14.27 V  (14.2 at start, tapering to 13.6)
//   after shutdown, settling  12.91 - 13.11 V  (decaying)
// AS_RUN_OFF_S is what protects this: the 2026-08-17 dips that caused the
// fourteen-runs bug were all under 60 s, so a 120 s hold still rejects them
// even with the threshold this close to the running floor.
const float    AS_ENG_OFF_V     = 13.10f;   // below this, held AS_RUN_OFF_S, a run ends
const uint32_t AS_RUN_OFF_S     = 120;      // low must hold this long to end a run
const uint32_t AS_RUN_ON_S      = 5;        // and high this long to start one
// Longest run this car could plausibly have made. Only used at boot, to tell an
// open run that is still going from one orphaned by the pre-4.58 static-reset bug.
const uint32_t RUN_MAX_PLAUSIBLE_S = 12UL * 3600UL;
// Consecutive history samples that must be above AS_ENG_OFF_V before a boot
// reconstruction believes the engine was running then. The graph is a 1-in-240
// snapshot, so isolated samples catch transients that are not the alternator.
const int      RUN_RECON_MIN_N     = 3;
const uint8_t  AS_DEF_MAX_FAILS = 2;        // consecutive unverified starts -> lockout (default)
// Optional cap on auto-starts per rolling 24 h. 0 (or any value <= 0) means
// UNLIMITED, which is the default: if the battery genuinely needs starting six
// times in a cold night, refusing on the seventh is its own kind of failure.
// The lockout-on-no-charge guard is what stops a runaway, not this.
const int      AS_DEF_MAX24     = 0;        // 0 / -1 = unlimited
const uint32_t AS_BOOT_GRACE_MS = 120000;   // no auto-start in the first 2 min after boot
const float    AS_V_MIN_CFG     = 10.0f;    // accepted config range for the threshold
const float    AS_V_MAX_CFG     = 13.0f;
const int      START_N          = 64;       // start-event ring buffer length
// The WebServer abandons an upload when no byte arrives within the connection's
// read timeout -- 5 s, set when it accepts the client -- and reports that as
// UPLOAD_FILE_ABORTED, which the handler logs as "aborted by client" although the
// client never gave up. Six uploads of fw 4.73 died that way at random offsets
// over a -60 dBm link, with and without WiFi power-save. A stall is not a failure.
const uint32_t OTA_STALL_MS     = 30000;

// ----- SNMP (read-only, for Cacti / LibreNMS / snmpwalk) -----
// Enterprise subtree 1.3.6.1.4.1.99999.**8** -- the Pi-side responder uses .7,
// so both can live on one network. Port 161 is fine here: no OS privilege
// rules on bare metal. Community is read-only; there is no SET path at all.
const bool     SNMP_ENABLED   = true;
// ----- Bluetooth (debug page only) -----
// The radio is OFF in normal operation and only the Debug page turns it on:
// /btscan brings the stack up, scans and reports; /btconnect makes ONE short
// connection to an address you name, asks it a few read-only questions and
// disconnects. Nothing is stored, nothing is paired, nothing stays connected.
//
// Two hard constraints, both of which change how a result should be read:
//   * The ESP32-S3 has NO Bluetooth Classic. This is BLE only, so a Classic
//     (SPP) device is invisible to it -- an empty result does NOT mean nothing
//     is there.
//   * BLE and WiFi share one radio and one antenna. A scan steals airtime from
//     the link this page arrived over, so keep scans short.
// Measured: the NimBLE stack takes ~70 KB of heap while it is up. The first
// value here was 80 KB, which is nonsense -- it let a scan start with 10 KB left
// for WiFi and HTTP, and the board panicked. The floor has to cover the stack
// AND leave the rest of the system its working room.
const uint32_t BT_MIN_HEAP    = 130000;     // refuse to bring the stack up below this
// NimBLE's teardown is not instantaneous. Starting a fresh init() seconds after
// a deinit() panicked repeatedly; this gap lets the controller settle first.
const uint32_t BT_COOLDOWN_MS = 5000;
// fw 4.76: the stack is placed ONCE, at boot, and never taken down. 4.72 turned the
// radio off after 5 min idle to hand its ~70 KB back, but every bring-up/teardown
// cycle left the heap more fragmented until a bring-up could not be placed at all
// ("memory is too fragmented to start Bluetooth"), and only a reboot cured that.
// Placed at boot, there is no later bring-up left to refuse.
// NOT DONE -- tried while testing 4.76, then reverted: lowering the core's 4096 B
// "malloc() prefers internal RAM up to here" threshold (heap_caps_malloc_extmem_enable)
// to move web strings and JSON into PSRAM. lwIP in this core allocates with plain
// malloc (CONFIG_SPIRAM_TRY_ALLOCATE_WIFI_LWIP is off), so its packet buffers moved
// into PSRAM as well -- a setup the core does not support. It bought ~25 KB of
// headroom, which is not worth running lwIP in an unsupported configuration. Leave it
// at 4096. (An OTA under it rebooted reset=PANIC, but so did a later one on 4096: that
// panic is core 0's 1024 B IPC task overflowing during the boot-time Bluetooth bring-up
// on the first boot after an OTA -- the 4.79 core dump shows it -- not this threshold.)
// Free heap is not the binding constraint -- CONTIGUITY is. The stack wants
// sizeable blocks, and HTTP traffic fragments the heap with String churn, so a
// board reporting 170 KB free can still fail to place a 70 KB stack. Gate on the
// largest single allocation available, not just the total.
const uint32_t BT_MIN_BLOCK   = 60000;
const int      BT_SCAN_MAX_S  = 15;
const uint16_t SNMP_PORT      = 161;
const char*    SNMP_COMMUNITY = "public";
// -----------------------------------------------------------

struct Sample {
  uint32_t ts;          // unix epoch seconds when sampled (0 if NTP not yet synced)
  float    vbatt;       // volts
  float    temp;        // chip C
  uint16_t heap_kb;     // free heap, KB
  uint16_t disk_kb;     // filesystem used, KB
  uint32_t net_in;      // bytes received this interval (approx, HTTP)
  uint32_t net_out;     // bytes sent this interval
  int16_t  rssi;        // WiFi RSSI dBm (0 in AP mode)
  uint8_t  cpu0;        // core 0 load %, averaged across the interval
  uint8_t  cpu1;        // core 1 load %, averaged across the interval
  int16_t  drain;       // battery drain rate at this sample, mV/h (signed; <0 = discharging, 0 = not fitted yet)
  uint16_t link_mbps;   // WiFi link rate at this sample (nominal Mbps from the negotiated PHY; 0 if not associated)
};

// Battery-drain regression result. Declared up here with Sample because the
// .ino auto-prototype pass emits `DrainFit computeDrain();` near the top of the
// file -- the type has to already exist by then or the build fails.
const int      DRAIN_MIN_N  = 30;      // need at least 30 min of samples
const float    DRAIN_FLAT_V = 11.8f;   // projection target: below this it won't crank
const uint32_t DRAIN_GAP_S  = 600;     // a >10 min hole ends the window (board was off)

struct DrainFit {
  bool     ok;
  float    mvph;    // signed millivolts/hour; negative = discharging. Temperature-
                    // compensated: the true depletion rate with the diurnal thermal
                    // swing regressed out (falls back to raw slope if temp is flat).
  float    r2;      // 0..1 fit quality (of the two-variable model)
  int      n;       // samples in the fit
  uint32_t win_s;   // span covered
  float    days;    // days until DRAIN_FLAT_V at this rate; <0 = n/a
  float    mv_per_c;// temperature coefficient the fit found, mV/degC (diagnostic)
};
DrainFit g_drain = {false, 0, 0, 0, 0, -1, 0};   // refreshed once per history sample

// Hourly drain bucket + its regression result. Declared up here for the SAME
// reason as DrainFit above: the .ino auto-prototype pass emits
// `HourFit computeHourlyDrain();` near the top of the file, so both types have
// to exist by then. (Full rationale for the buckets is further down, at DR_MAX.)
// Series carried by the hourly archive and served by /agg. The ORDER IS THE FILE
// FORMAT -- append only, and bump HAG_MAGIC if anything is ever reordered or
// removed. Names match the /history column names and the chart `col` fields.
enum { AG_VBATT = 0, AG_TEMP, AG_DRAIN, AG_RSSI, AG_LINK, AG_NIN, AG_NOUT,
       AG_CPU0, AG_CPU1, AG_HEAP, AG_DISK, AG_N };
const char* const AG_NAME[AG_N] = { "vbatt", "temp", "drain", "rssi", "link",
       "net_in", "net_out", "cpu0", "cpu1", "heap_kb", "disk_kb" };
// Decimal places per series when serialised -- the difference between 12.25 and
// 12.250000 over a poor link, across ~180 rows, is most of the payload.
const uint8_t AG_DEC[AG_N] = { 2, 1, 0, 0, 0, 0, 0, 0, 0, 0, 0 };

// 136 B per hour. Deliberately floats rather than scaled ints: the drain fit
// needs the precision on vbatt, and at 3.3 KB/day the packing saves nothing that
// matters on a 10 MB filesystem. Flash wear is not a constraint here (see 4.37).
struct HourAgg {
  uint32_t ts;                                   // midpoint of the hour covered
  float    mean[AG_N], mn[AG_N], mx[AG_N];
};

struct HourFit   { bool ok; float mvph; float r2; int n; uint32_t span_s; float mvpc; };
HourFit g_hfit = {false, 0, 0, 0, 0, 0};

// ---- Run history ----------------------------------------------------------
// Engine starts, stops and failed attempts ONLY, kept separately from the event
// log because they answer a different question over a much longer window: how
// long does this car sit between runs, and how often does a start not take?
// The event log rotates at 48 KB x 2 and would lose that inside a fortnight.
//
// 16 B per event, appended, two generations of 2000 -- roughly 4000 events, or
// years at the handful per day this car produces.
enum { RUN_CMD = 0, RUN_ON = 1, RUN_OFF = 2, RUN_FAIL = 3 };
enum { RSRC_AUTO = 0, RSRC_MANUAL = 1, RSRC_EXT = 2 };
struct RunEvent {
  uint32_t ts;                 // unix epoch (0 = clock not yet valid; dropped)
  uint8_t  kind, src, flags;   // flags bit0 on RUN_CMD = the CC1101 accepted the burst
  uint8_t  _rsv;
  float    v;                  // battery volts at the event
  uint32_t dur_s;              // RUN_OFF: how long it ran; otherwise 0
};
const uint8_t  RUN_F_TX_OK    = 0x01;         // the CC1101 accepted the burst
const uint8_t  RUN_F_BACKFILL = 0x80;         // reconstructed, NOT recorded live
const uint8_t  RUN_F_RECON    = 0x40;         // edge inferred at boot, timestamp is an estimate
const uint8_t  RUN_F_OBD      = 0x20;         // edge timed by the engine computer over OBD, not by voltage
const uint8_t  RUN_F_STOPCMD  = 0x10;         // fw 4.78: a CMD record that was a stop (Start sent to a running engine)
const char*    RUN_FILE = "/runs.bin";
const char*    RUN_OLD  = "/runs.old";
const uint32_t RUN_MAGIC = 0x52554E31;        // "RUN1"
const int      RUN_ROTATE = 2000;             // records per generation

// One-time reconstruction, written only if no run file exists at all.
//
// The run history starts empty because nothing durable ever recorded engine
// events -- that is the gap this feature closes. These entries are recovered
// from other evidence and are flagged RUN_F_BACKFILL so the dashboard marks them
// as reconstructed; they must never be mistaken for live records.
//
// Provenance:
//   2026-08-08 16:52  the value of `last_run` in NVS, read off /json on 08-14/15
//                     before the 08-15 run overwrote it. Auto-start had never
//                     fired at that point, so the source was the key or the FOB.
//                     No end time was ever stored, so there is no matching OFF.
//   2026-08-15        the first automatic start. Timestamps and voltages cross-
//                     checked against the /starts ring (1786806639, 1786808727)
//                     and last_run (1786808746); the derived times agree exactly.
//
// Anything older is genuinely unrecoverable: the 1000-line log ring had already
// rolled back only as far as 08:21 that morning, and the sample ring holds 24 h.
struct RunSeed { uint32_t ts; uint8_t kind, src, flags; float v; uint32_t dur; };
const RunSeed RUN_SEED[] = {
  { 1786229571, RUN_ON,   RSRC_EXT,  RUN_F_BACKFILL,                  0.00f,    0 },
  { 1786806639, RUN_CMD,  RSRC_AUTO, RUN_F_BACKFILL | RUN_F_TX_OK,   12.14f,    0 },
  { 1786806819, RUN_FAIL, RSRC_AUTO, RUN_F_BACKFILL,                 12.16f,  180 },
  { 1786808727, RUN_CMD,  RSRC_AUTO, RUN_F_BACKFILL | RUN_F_TX_OK,   12.16f,    0 },
  { 1786808746, RUN_ON,   RSRC_AUTO, RUN_F_BACKFILL,                 13.29f,    0 },
  { 1786810288, RUN_OFF,  RSRC_AUTO, RUN_F_BACKFILL,                 12.89f, 1541 },
};
const int RUN_SEED_N = sizeof(RUN_SEED) / sizeof(RUN_SEED[0]);

// The engine edges are detected on the safety task (core 0), which must never
// touch the filesystem. Queue here, let the loop write. A ring rather than a
// single slot because a fire and its ENGINE ON can land close together.
const int      RUNQ_N = 8;
RunEvent       g_runq[RUNQ_N];
// Set for the duration of an OTA. The safety task on core 0 must not touch the
// filesystem while Update.write() is erasing: on the S3 a flash erase disables
// the cache for BOTH cores, and a second core stalled inside a critical section
// at that moment is exactly how the interrupt watchdog fires. Observed as
// `boot: fw 4.48, reset=interrupt-watchdog` after a dozen failed uploads.
volatile bool  g_otaActive = false;
volatile int   g_runqHead = 0, g_runqTail = 0;
static portMUX_TYPE g_runqMux = portMUX_INITIALIZER_UNLOCKED;

// ---- countdown flap windows ----------------------------------------------
// A battery dithering across the trigger emits a STARTED/RESET pair every few
// seconds. The generic flap consolidation further down cannot collapse these
// because it keys on the FULL line text and every line carries its own voltage
// -- 12.19 V and 12.20 V are different strings, so the count never accumulates
// and the ring fills with near-identical lines.
//
// So the countdown stops logging per event entirely. Events accumulate and each
// window emits exactly TWO lines -- one for starts, one for resets. Voltages
// become a range, so a start at 12.15 V and one at 12.20 V fold into the same
// line instead of splitting it, which is what defeated the old mechanism.
//
// A window is also closed early, before an auto-start fires or an engine edge is
// logged, so a summary never lands after the event it led up to. That is what
// keeps the log readable in order despite the batching.
//
// Lines are kept short deliberately: LOG_LEN is 108 including a 20-character
// timestamp, so the reset line has an 88-character budget and the reason list is
// truncated rather than allowed to push the counts off the end.
const uint32_t CD_WIN_MS   = 1800000UL;   // 30 min
const int      CD_VERBOSE  = 0;           // 0 = never log individually; one summary per kind
const int      CD_WHY_N    = 4;           // distinct reset reasons tracked per window

struct CdWin {
  uint32_t t0ms;                  // window start (millis; 0 = no window open)
  uint16_t n;                     // events seen in this window
  uint16_t suppressed;            // of which this many were not logged individually
  float    vmin, vmax;
  uint32_t smax;                  // RESET only: longest countdown reached, seconds
  const char* why[CD_WHY_N];      // RESET only: distinct reasons (string literals)
  uint16_t whyN[CD_WHY_N];
  uint8_t  whys;
};
CdWin g_cdStart = {0}, g_cdReset = {0};

// The single place a Sample is mapped onto the series vector. Both the hourly
// accumulator and /agg's day span go through here, so they cannot drift apart.
// NOTE: this is the FIRST function definition in the file, which is where the
// .ino auto-prototype block gets inserted -- so every type used in any function
// signature (HourFit, DrainFit, HourAgg, Sample) must be declared ABOVE it.
static inline void agFromSample(float* av, const Sample& s) {
  av[AG_VBATT] = s.vbatt;   av[AG_TEMP] = s.temp;      av[AG_DRAIN] = s.drain;
  av[AG_RSSI]  = s.rssi;    av[AG_LINK] = s.link_mbps;
  av[AG_NIN]   = s.net_in;  av[AG_NOUT] = s.net_out;
  av[AG_CPU0]  = s.cpu0;    av[AG_CPU1] = s.cpu1;
  av[AG_HEAP]  = s.heap_kb; av[AG_DISK] = s.disk_kb;
}

// ---------- rolling event log (bounded RAM ring; never touches flash) ----------
// A fixed ring of the most recent lines -- can't grow, so it can't fill RAM or
// the drive. Viewable at /logs (auto-refreshing page) and /logtext (raw). Written
// from both the loop and the safety task, so the ring update is under a spinlock.
static const int LOG_LINES = 1000;          // capacity; rarely full (events are sparse + debounced)
static const int LOG_LEN   = 108;
static char (*g_log)[LOG_LEN] = nullptr;    // ring in PSRAM (8 MB, like the history buffer) -- no DRAM cost
static int  g_logHead = 0, g_logCount = 0;
static portMUX_TYPE g_logMux = portMUX_INITIALIZER_UNLOCKED;
// Flash-persistence cursor. logLine() (called from BOTH cores) only bumps the
// ring + g_logSeq under the spinlock; the loop drains new lines to LittleFS via
// flushLogToFlash(), so all file I/O stays single-threaded on the loop core and
// never runs inside the critical section.
static volatile uint32_t g_logSeq = 0;          // total lines ever pushed (monotonic)
static volatile uint32_t g_logPersistedSeq = 0; // how many have reached flash

// ---- flap consolidation --------------------------------------------------
// A value dithering at a threshold emits the same one- or two-line pattern over
// and over. Observed: LOW-V STARTED/RESET pairs one second apart, repeatedly --
// left alone that fills the 1000-line ring in minutes and buries everything
// else worth reading.
//
// So recognise a repeating 1- or 2-line cycle and, instead of appending, keep
// rewriting a "[repeated N times]" suffix on the lines already in the ring.
// Keyed on the FULL message text including voltages, so 12.22 V and 12.23 V are
// different lines and a change in the value starts a fresh count. That is what
// makes the collapsed line trustworthy rather than a lie of omission.
static char     g_flapA[LOG_LEN] = {0};        // first line of the detected cycle
static char     g_flapB[LOG_LEN] = {0};        // second line ("" = single-line cycle)
static int      g_flapIA = -1, g_flapIB = -1;  // their ring indices
static uint16_t g_flapN    = 0;                // repeats collapsed so far
static uint8_t  g_flapStep = 0;                // next expected slot in the cycle
static char     g_prevMsg[LOG_LEN] = {0};      // last two appended messages
static char     g_lastMsg[LOG_LEN] = {0};
static int      g_prevIdx = -1, g_lastIdx = -1;

// Rewrite ring[idx] as its original text plus "[repeated N times]". Caller holds
// g_logMux. Truncates any previous suffix first so the count never stacks up.
static void flapStamp(int idx, uint16_t n) {
  if (idx < 0 || !g_log) return;
  char* p = strstr(g_log[idx], "  [repeated ");
  if (p) *p = 0;
  size_t len = strlen(g_log[idx]);
  snprintf(g_log[idx] + len, LOG_LEN - len, "  [repeated %u times]", (unsigned)(n + 1));
}

static void flapReset() {
  g_flapA[0] = g_flapB[0] = 0; g_flapIA = g_flapIB = -1;
  g_flapN = 0; g_flapStep = 0;
}

void logLine(const char* fmt, ...) {
  char msg[LOG_LEN];
  va_list ap; va_start(ap, fmt); vsnprintf(msg, sizeof(msg), fmt, ap); va_end(ap);
  char line[LOG_LEN];
  time_t tt = time(nullptr);
  if (tt > 1700000000L) {                       // wall clock: full date + time
    struct tm* lt = localtime(&tt);
    char stamp[24];
    strftime(stamp, sizeof(stamp), "%Y-%m-%d %H:%M:%S", lt);
    snprintf(line, sizeof(line), "%s %s", stamp, msg);
  } else {                                       // pre-NTP: uptime seconds
    snprintf(line, sizeof(line), "+%lus %s", (unsigned long)(millis() / 1000), msg);
  }
  portENTER_CRITICAL(&g_logMux);
  if (g_log) {
    bool collapsed = false;

    // Already tracking a cycle: does this message continue it?
    if (g_flapN > 0 || g_flapA[0]) {
      const char* expect = (g_flapStep == 0) ? g_flapA : g_flapB;
      if (expect[0] && strcmp(msg, expect) == 0) {
        bool pair = (g_flapB[0] != 0);
        g_flapStep = pair ? (g_flapStep ^ 1) : 0;
        if (g_flapStep == 0) {                 // a full cycle just completed
          g_flapN++;
          flapStamp(g_flapIA, g_flapN);
          if (pair) flapStamp(g_flapIB, g_flapN);
          g_logSeq++;                          // re-persist the amended line(s)
        }
        collapsed = true;
      } else {
        flapReset();                           // pattern broken -- resume normally
      }
    }

    if (!collapsed) {
      // Detect the START of a cycle from the two most recently appended lines.
      if (g_lastMsg[0] && strcmp(msg, g_lastMsg) == 0) {          // A,A
        strncpy(g_flapA, msg, LOG_LEN - 1); g_flapA[LOG_LEN - 1] = 0;
        g_flapB[0] = 0; g_flapIA = g_lastIdx; g_flapIB = -1;
        g_flapN = 1; g_flapStep = 0;
        flapStamp(g_flapIA, g_flapN);
        g_logSeq++;
        collapsed = true;
      } else if (g_prevMsg[0] && strcmp(msg, g_prevMsg) == 0) {   // A,B,A
        strncpy(g_flapA, g_prevMsg, LOG_LEN - 1); g_flapA[LOG_LEN - 1] = 0;
        strncpy(g_flapB, g_lastMsg, LOG_LEN - 1); g_flapB[LOG_LEN - 1] = 0;
        g_flapIA = g_prevIdx; g_flapIB = g_lastIdx;
        g_flapN = 1; g_flapStep = 1;           // we have just re-seen A
        flapStamp(g_flapIA, g_flapN);
        flapStamp(g_flapIB, g_flapN);
        g_logSeq++;
        collapsed = true;
      }
    }

    if (!collapsed) {                          // ordinary append
      strncpy(g_log[g_logHead], line, LOG_LEN - 1); g_log[g_logHead][LOG_LEN - 1] = 0;
      strncpy(g_prevMsg, g_lastMsg, LOG_LEN - 1); g_prevMsg[LOG_LEN - 1] = 0;
      strncpy(g_lastMsg, msg,       LOG_LEN - 1); g_lastMsg[LOG_LEN - 1] = 0;
      g_prevIdx = g_lastIdx; g_lastIdx = g_logHead;
      g_logHead = (g_logHead + 1) % LOG_LINES;
      if (g_logCount < LOG_LINES) g_logCount++;
      g_logSeq++;                       // loop will persist anything past g_logPersistedSeq
    }
  }
  portEXIT_CRITICAL(&g_logMux);
  Serial.println(line);                 // keep the USB console too
}

// Human name for a WiFi disconnect reason code (esp_wifi_types wifi_err_reason_t).
static const char* wifiReason(uint8_t r) {
  switch (r) {
    case 1:   return "unspecified";
    case 2:   return "auth-expire";
    case 3:   return "auth-leave";
    case 4:   return "assoc-expire";
    case 5:   return "assoc-toomany";
    case 8:   return "assoc-leave";
    case 15:  return "4way-handshake-timeout";
    case 200: return "beacon-timeout";
    case 201: return "no-AP-found";
    case 202: return "auth-fail";
    case 203: return "assoc-fail";
    case 204: return "handshake-timeout";
    case 205: return "connection-fail";
    default:  return "other";
  }
}

// Human name for the negotiated PHY mode (the closest thing to "what speed are
// we linked at" -- 11b/g are single rates, HT20/40 are the 11n widths).
static const char* phyModeName(wifi_phy_mode_t m) {
  switch (m) {
    case WIFI_PHY_MODE_LR:   return "LR";
    case WIFI_PHY_MODE_11B:  return "11b";
    case WIFI_PHY_MODE_11G:  return "11g";
    case WIFI_PHY_MODE_HT20: return "11n-HT20";
    case WIFI_PHY_MODE_HT40: return "11n-HT40";
    case WIFI_PHY_MODE_HE20: return "11ax-HE20";
    default: return "?";
  }
}

// Negotiated PHY mode as a string, or "n/a" if not currently associated.
static const char* staPhyMode() {
  wifi_phy_mode_t pm;
  if (WiFi.status() == WL_CONNECTED && esp_wifi_sta_get_negotiated_phymode(&pm) == ESP_OK)
    return phyModeName(pm);
  return "n/a";
}

// Nominal link rate (Mbps) for the negotiated PHY -- a graphable "speed": drops
// when the AP downshifts us on a weak link. 0 when not associated.
static uint16_t staLinkMbps() {
  wifi_phy_mode_t pm;
  if (WiFi.status() != WL_CONNECTED || esp_wifi_sta_get_negotiated_phymode(&pm) != ESP_OK) return 0;
  switch (pm) {
    case WIFI_PHY_MODE_11B:  return 11;
    case WIFI_PHY_MODE_11G:  return 54;
    case WIFI_PHY_MODE_HT20: return 72;
    case WIFI_PHY_MODE_HT40: return 150;
    case WIFI_PHY_MODE_HE20: return 143;
    case WIFI_PHY_MODE_LR:   return 1;
    default: return 0;
  }
}

// Verbose WiFi diagnostics into the event log: association, IP, and -- most
// usefully for the drop-out hunt -- the disconnect REASON code every time it
// falls off. (Per-request / SNMP-poll traffic is deliberately NOT logged.)
void onWiFiEvent(WiFiEvent_t ev, WiFiEventInfo_t info) {
  switch (ev) {
    case ARDUINO_EVENT_WIFI_STA_CONNECTED:
      logLine("WiFi assoc to AP (channel %d)", info.wifi_sta_connected.channel);
      break;
    case ARDUINO_EVENT_WIFI_STA_GOT_IP:
      logLine("WiFi got IP %s @ %d dBm, ch %d, %s, SSID '%s'",
              WiFi.localIP().toString().c_str(), (int)WiFi.RSSI(),
              WiFi.channel(), staPhyMode(), WiFi.SSID().c_str());
      break;
    case ARDUINO_EVENT_WIFI_STA_DISCONNECTED: {
      // Debounce: the driver retries every few seconds while out of range, each
      // firing this event. Log the first, then suppress identical repeats for
      // 2 min so a prolonged outage can't flood the ring -- and report the count.
      uint8_t r = info.wifi_sta_disconnected.reason;
      static uint8_t lastR = 255; static uint32_t lastMs = 0; static uint16_t supp = 0;
      uint32_t now = millis();
      if (r != lastR || (now - lastMs) > 120000UL) {
        if (supp) logLine("WiFi DISCONNECT: reason %u (%s) [+%u more suppressed]", r, wifiReason(r), supp);
        else      logLine("WiFi DISCONNECT: reason %u (%s)", r, wifiReason(r));
        lastR = r; lastMs = now; supp = 0;
      } else if (supp < 60000) supp++;
      break; }
    case ARDUINO_EVENT_WIFI_STA_LOST_IP:
      logLine("WiFi lost IP");
      break;
    default: break;
  }
}

// Why the last boot happened -- brownout / watchdog / panic are the ones that
// would silently make it "go unusable", so surface them at boot.
static const char* resetReasonName() {
  switch (esp_reset_reason()) {
    case ESP_RST_POWERON:   return "power-on";
    case ESP_RST_SW:        return "software";
    case ESP_RST_PANIC:     return "PANIC/exception";
    case ESP_RST_INT_WDT:   return "interrupt-watchdog";
    case ESP_RST_TASK_WDT:  return "TASK-WATCHDOG";
    case ESP_RST_WDT:       return "other-watchdog";
    case ESP_RST_BROWNOUT:  return "BROWNOUT";
    case ESP_RST_DEEPSLEEP: return "deep-sleep";
    case ESP_RST_EXT:       return "external-pin";
    default:                return "unknown";
  }
}

// NTP sync notification (initial + each periodic re-sync).
void onNtpSync(struct timeval* tv) {
  logLine("NTP sync: clock updated");
}

// ----- time sync state -----
uint32_t lastNtpSyncMs = 0;     // millis() of the last configTzTime() kick
bool     g_timeSynced  = false; // true once the clock reads a plausible year

bool timeIsValid() {
  return time(nullptr) > 1700000000UL;   // ~2023-11-14; means NTP set the clock
}

// Kick off (or refresh) SNTP. Safe to call repeatedly; each call re-queries
// the servers. Only meaningful with a live STA connection.
void syncTimeNow() {
  configTzTime(TZ_INFO, NTP_SERVER1, NTP_SERVER2);
  lastNtpSyncMs = millis();
}

WebServer server(80);
DNSServer dnsServer;
bool      apMode    = false;
int       g_last_mv = 0;

// Persisted power/perf settings (NVS). Loaded in setup(), re-saved on each
// toggle. NVS lives in a flash partition, so these survive reboot AND a
// brownout -- the chosen CPU clock and WiFi power-save state come back.
Preferences prefs;
uint32_t  g_cpu_mhz = 240;       // restored at boot, then applied
bool      g_wifi_ps = true;      // restored at boot, then applied (true = modem-sleep)

// ----- low-voltage auto-start: persisted config + live state -----
// Config lives in NVS (survives reboot/brownout). Ships disabled; arming is
// a deliberate click in the dashboard.
bool      g_as_en    = false;              // ARMED?  NVS "as_en"
float     g_as_volts = AS_DEF_VOLTS;       // trigger threshold, V   NVS "as_volts"
uint32_t  g_as_hold  = AS_DEF_HOLD_S;      // sustain seconds        NVS "as_hold"
uint32_t  g_as_cool  = AS_DEF_COOL_S;      // cooldown seconds       NVS "as_cool"
uint32_t  g_lowSince    = 0;               // millis() when V first went below threshold (0 = not low)
uint32_t  g_lastStartMs = 0;               // millis() of the last auto-start this session
uint32_t  g_lastStartTs = 0;               // epoch of the last auto-start  NVS "as_last"
uint32_t  g_lastRunTs   = 0;               // epoch the engine was last seen RUNNING (charging),
                                           // whoever started it -- key/FOB/board.  NVS "last_run"

// Engine on/off state. FILE SCOPE, not function-static, because reconcileOpenRun()
// has to seed it at boot -- see the note there for why a plain static loses runs.
bool      g_btUp        = false;           // BLE stack currently initialised
bool      engRunning    = false;
uint32_t  engOnMs       = 0;               // millis() of the confirmed ON edge
bool      g_runRecDone  = false;           // boot reconciliation has run (or had nothing to do)
float     g_lastV       = 0.0f;            // most recent voltage reading (owned by the safety task)
float     g_lastTemp    = 0.0f;            // most recent chip temp C (owned by the safety task)

// Safety task + watchdog (definitions in setup / after evalAutoStart). Declared
// here so evalAutoStart() and handleTransmit() can see g_rfMutex.
TaskHandle_t      g_safetyTask   = nullptr;
SemaphoreHandle_t g_rfMutex      = nullptr;
// Task-watchdog timeout. Raised 30 s -> 300 s on 2026-08-12 on the evidence of
// four days of logs: NINE watchdog firings, every one of them network I/O
// ('http', '/history', 'ota'), and every one recording "safety was 'idle'" --
// the core-0 task the watchdog exists to protect was healthy in all nine. Not
// one real hang was ever caught; each firing cost a reboot AND 15 minutes of
// disarmed auto-start, because a reboot resets the 900 s park-confirm.
//
// So a longer timeout makes the safety function MORE available, not less. The
// cost is that a genuine safety-task hang now takes up to 5 min to self-recover
// instead of 30 s -- immaterial when the sampler runs at 1 Hz, the trigger needs
// a 60 s sustain, and the battery moves about 1 mV/h.
//
// This is compensation, not the fix: bounding the I/O (waitWritable) is the
// correct repair, and it stays. The wider timeout stops legitimate slowness --
// a 68 s OTA over a contended channel -- from looking like a stall.
const uint32_t    WDT_TIMEOUT_MS = 300000;  // 5 min; see the note above

// WDT-culprit breadcrumbs. Each watched task stamps "what am I doing" into RTC
// memory, which survives a TASK-WATCHDOG reset -- so the next boot can report
// which task was stuck on what, instead of us guessing. On a reset the stuck
// task's mark shows the blocking op; the healthy task's mark just shows its last
// normal phase. A magic guards against garbage on a cold (power-on) boot.
RTC_NOINIT_ATTR static char     g_loopMark[28];
RTC_NOINIT_ATTR static char     g_safetyMark[28];
RTC_NOINIT_ATTR static uint32_t g_markMagic;

// ---- Tier 1 of sample storage: RTC slow RAM -------------------------------
// Newly-taken samples land here and NOTHING is written to flash until the batch
// is full. RTC_NOINIT survives a watchdog reset, a software reset and an OTA
// reboot -- every reset this board has actually taken -- so batching costs no
// data. Only pulling the battery loses the tail, and that also stops the car.
//
// This replaces a 46 KB rewrite of the whole ring every 10 minutes. That was
// ~6.6 MB/day, and it also meant any reboot threw away up to ten minutes of
// history. Now a reboot costs nothing and a day costs 46 KB.
const int SB_N = 30;                                   // 30 min of samples, 960 B of RTC RAM
const uint32_t SB_MAGIC = 0x53424631;                  // "SBF1"
RTC_NOINIT_ATTR static Sample   g_sb[SB_N];
RTC_NOINIT_ATTR static uint16_t g_sbN;
RTC_NOINIT_ATTR static uint32_t g_sbMagic;
volatile bool g_sbFlush = false;                        // safety task asks, loop writes
// The safety task appends to g_sb while the loop is writing it out, so the count
// needs its own lock -- same arrangement as g_logMux for the event log.
static portMUX_TYPE g_sbMux = portMUX_INITIALIZER_UNLOCKED;

// Written-bytes counters, so wear is observable rather than assumed. Reset on
// boot; exposed in /json as fs_wr_b / fs_wr_n.
uint32_t g_fsBytes = 0, g_fsCommits = 0;
static const uint32_t MARK_MAGIC = 0x574D4B31;   // "WMK1"
static inline void loopMark(const char* s)   { strncpy(g_loopMark,   s, sizeof(g_loopMark) - 1);   g_loopMark[sizeof(g_loopMark) - 1] = 0; }
static inline void safetyMark(const char* s) { strncpy(g_safetyMark, s, sizeof(g_safetyMark) - 1); g_safetyMark[sizeof(g_safetyMark) - 1] = 0; }

// Extra restraint state. These stop the three ways an automatic starter
// misbehaves: firing while you're driving, firing over and over on a battery
// that never really recovers, and cranking a car that isn't going to start.
uint32_t  g_parkS       = 0;               // seconds continuously below AS_ALT_V (alternator off)
uint32_t  g_rearmS      = 0;               // seconds continuously at/above AS_REARM_V
bool      g_needRearm   = false;           // set after a start; blocks refiring until recovered
bool      g_asLock      = false;           // latched lockout  NVS "as_lock"
uint8_t   g_asFails     = 0;               // consecutive unverified starts  NVS "as_fails"
// ---- Hourly drain buckets -------------------------------------------------
// The 24 h sample ring cannot see a drain that plays out over days, and a
// two-point anchor (fw 4.29) is hostage to noise at either end. So keep one
// averaged bucket per hour for the WHOLE park and regress across all of them.
//
// Each bucket is 60 samples averaged, which kills the per-sample ADC
// quantisation (~5.5 mV) outright. Buckets persist to LittleFS, so a reboot --
// the thing that has repeatedly destroyed this measurement -- costs nothing.
//
// Two deliberate choices:
//   * Buckets are stored from engine-off, but the FIT starts at +12 h. The first
//     half-day is surface charge dissipating, not parasitic drain; including it
//     would badly overstate the slope. The data is still there to look at.
//   * Temperature is stored per bucket and used as a second regressor. This
//     battery moves ~5 mV/degC and the diurnal swing is several times the daily
//     trend, so a time-only fit over a partial last day is biased by whatever
//     the weather did. V ~ time + temp removes it.
const int      DR_MAX      = 1500;                        // ~62 days
const uint32_t DR_SETTLE_S = 12UL * 3600UL;               // skip post-run settling
const int      DR_MIN_PTS  = 6;                           // need this many to report
const char*    DR_FILE     = "/hourly.bin";               // long-term archive
const char*    DR_OLD      = "/hourly.old";               // one prior generation

// Daily tier. The hourly archive covers ~125 days across two generations, so a
// year view needs its own store -- and at 365 points a year wants daily
// resolution anyway. Deliberately reuses HourAgg rather than introducing a
// second record type: no new on-disk format, and therefore no third format
// migration (the first two both shipped with bugs, see 4.38 and 4.39).
// 400 records x 136 B = 54 KB per generation, two generations = ~2 years.
const int      DY_MAX      = 400;
const char*    DY_FILE     = "/daily.bin";
const char*    DY_OLD      = "/daily.old";
HourAgg*       g_dy   = nullptr;                          // PSRAM ring
int            g_dyN  = 0;
double         g_dySum[AG_N];
float          g_dyMin[AG_N], g_dyMax[AG_N];
uint32_t       g_dyCnt = 0, g_dyDay = 0;
volatile bool  g_dyPending = false;
HourAgg        g_dyPend;

// /agg scratch: sums + per-bucket min/max for the largest span (365 buckets x
// AG_N series x 3 arrays) and the counts. PSRAM, allocated once at boot.
float*         g_agBuf = nullptr;
uint16_t*      g_agCnt = nullptr;
HourAgg*       g_dr   = nullptr;                          // PSRAM ring (rolls at DR_MAX), ~204 KB
int            g_drN  = 0;
double         g_agSum[AG_N];                             // in-progress hour
float          g_agMin[AG_N], g_agMax[AG_N];
uint32_t       g_drCnt = 0, g_drHour = 0;
volatile bool  g_drPending = false;                       // a bucket awaits flash (loop core)
HourAgg        g_drPend;

// File format. The legacy 12 B {ts,v,t} records written by 4.36-4.39 have no
// header, and a leading epoch never collides with this magic, so the absence of
// a header is itself the version marker.
const uint32_t HAG_MAGIC = 0x48414731;                    // "HAG1"

static void dyReset() {
  for (int i = 0; i < AG_N; i++) { g_dySum[i] = 0; g_dyMin[i] = 1e30f; g_dyMax[i] = -1e30f; }
  g_dyCnt = 0;
}

static void dyPush(const HourAgg& b) {
  if (!g_dy) return;
  if (g_dyN < DY_MAX) { g_dy[g_dyN++] = b; }
  else { memmove(g_dy, g_dy + 1, (DY_MAX - 1) * sizeof(HourAgg)); g_dy[DY_MAX - 1] = b; }
}

static void agReset() {
  for (int i = 0; i < AG_N; i++) { g_agSum[i] = 0; g_agMin[i] = 1e30f; g_agMax[i] = -1e30f; }
  g_drCnt = 0;
}

static void drPush(const HourAgg& b) {
  if (!g_dr) return;
  if (g_drN < DR_MAX) { g_dr[g_drN++] = b; }
  else { memmove(g_dr, g_dr + 1, (DR_MAX - 1) * sizeof(HourAgg)); g_dr[DR_MAX - 1] = b; }
}

// Regress V against time and temperature across the settled buckets.
// Returns mV/h (negative = discharging), r2, and the temp coefficient.
HourFit computeHourlyDrain() {
  HourFit f = {false, 0, 0, 0, 0, 0};
  if (!g_dr || g_drN < DR_MIN_PTS) return f;
  uint32_t from = g_lastRunTs ? (g_lastRunTs + DR_SETTLE_S) : 0;
  int i0 = 0; while (i0 < g_drN && g_dr[i0].ts < from) i0++;
  int n = g_drN - i0;
  if (n < DR_MIN_PTS) return f;

  double t0 = g_dr[i0].ts;
  double sx=0, sy=0, sz=0, sxx=0, sxy=0, sxz=0, szz=0, syz=0;
  double tmin=1e9, tmax=-1e9;
  for (int i = i0; i < g_drN; i++) {
    double x = (g_dr[i].ts - t0) / 3600.0;     // hours
    double y = g_dr[i].mean[AG_VBATT];          // volts
    double z = g_dr[i].mean[AG_TEMP];           // degC
    sx+=x; sy+=y; sz+=z; sxx+=x*x; sxy+=x*y; sxz+=x*z; szz+=z*z; syz+=y*z;
    if (z<tmin) tmin=z; if (z>tmax) tmax=z;
  }
  double N = n;
  // Centre everything, then solve the 2x2 normal equations for [b_time, b_temp].
  double mx=sx/N, my=sy/N, mz=sz/N;
  double Sxx=sxx-N*mx*mx, Szz=szz-N*mz*mz, Sxz=sxz-N*mx*mz;
  double Sxy=sxy-N*mx*my, Szy=syz-N*mz*my;
  double b_time, b_temp = 0;
  double det = Sxx*Szz - Sxz*Sxz;
  if ((tmax - tmin) > 3.0 && fabs(det) > 1e-9) {        // enough temp spread to separate
    b_time = (Sxy*Szz - Szy*Sxz) / det;
    b_temp = (Szy*Sxx - Sxy*Sxz) / det;
  } else {
    if (fabs(Sxx) < 1e-9) return f;
    b_time = Sxy / Sxx;                                  // temp flat -> plain fit
  }
  double a = my - b_time*mx - b_temp*mz;
  double ssr=0, sst=0;
  for (int i = i0; i < g_drN; i++) {
    double x=(g_dr[i].ts-t0)/3600.0, y=g_dr[i].mean[AG_VBATT], z=g_dr[i].mean[AG_TEMP];
    double e = y - (a + b_time*x + b_temp*z);
    ssr += e*e; sst += (y-my)*(y-my);
  }
  f.ok     = true;
  f.mvph   = (float)(b_time * 1000.0);
  f.mvpc   = (float)(b_temp * 1000.0);
  f.r2     = sst > 0 ? (float)(1.0 - ssr/sst) : 0.0f;
  f.n      = n;
  f.span_s = g_dr[g_drN-1].ts - g_dr[i0].ts;
  return f;
}

// ---- Long-term drain reference -------------------------------------------
// A 24 h RAM ring cannot measure a drain that plays out over days, and every
// reboot restarts it -- which is exactly what the /history watchdog stalls were
// doing. So anchor a reference point in NVS instead: 12 h after the engine last
// stopped (skipping the fast, fluctuating settling phase while surface charge
// dissipates), record time+voltage. The long-term rate is then simply the slope
// from that anchor to now, and it SURVIVES REBOOTS because both ends are stored.
const uint32_t LT_SETTLE_S = 12UL * 3600UL;   // ignore the first 12 h after a run
const uint32_t LT_MIN_S    = 6UL  * 3600UL;   // need this much baseline to report
const int      LT_SMOOTH_N = 120;             // samples averaged at each end (2 h @ 60 s)
uint32_t  g_ltRefTs  = 0;                  // epoch of the settled reference
float     g_ltRefV   = 0.0f;               // voltage at that reference
uint32_t  g_ltDue    = 0;                  // epoch when the reference should be taken

bool      g_verifying   = false;           // waiting to see the alternator come up
uint32_t  g_verifyMs    = 0;               // millis() when verification started
int       g_pendingIdx  = -1;              // index of the start event awaiting verification
bool      g_verifyAuto  = false;           // was the pending start automatic? (only those can lock out)
// fw 4.78: run attribution and dating.
int8_t    g_verifiedSrc = -1;              // source of a start the board verified; the ON edge that follows is its
uint32_t  g_verifiedMs  = 0;               // millis() of that verification
volatile uint32_t g_stopCmdMs = 0;         // millis() a Start was sent to a running engine (a stop)
bool      g_runStartDated = false;         // this run's ON time already comes from the ECU
uint32_t  g_lastOffTs   = 0;               // wall clock of the last OFF edge; no start is dated before it
const uint32_t OBD_BACKDATE_MAX_S = 1800;  // PID 1F may move a run's start back by at most this
uint32_t  g_win24Ms     = 0;               // millis() at the start of the rolling 24 h window
uint8_t   g_fires24     = 0;               // auto-starts fired in that window (informational)
int       g_as_max24    = AS_DEF_MAX24;    // cap per 24 h; <= 0 = unlimited  NVS "as_max24"
// Consecutive unverified starts before the lockout latches. Adjustable because
// the RF link to the Compustar is probabilistic, not binary: 2026-08-15 saw the
// first attempt draw no crank at all (battery flat at 12.17 V three seconds
// after a tx=ok burst) and the retry 35 min later bring the alternator up in
// 19 s. A fixed 2 turns two unlucky bursts into a latched lockout on a car that
// starts perfectly well. 0 disables the latch entirely.  NVS "as_maxf"
uint8_t   g_as_maxfails = AS_DEF_MAX_FAILS;
uint32_t  g_as_retry    = AS_DEF_RETRY_S;  // gap after an UNVERIFIED start  NVS "as_retry"

// One logged engine-start event. Written through to flash immediately so a
// start is never lost to the brownout that a cranking engine can cause.
struct StartEvent {
  uint32_t ts;        // unix epoch when fired (0 if NTP hadn't synced)
  uint32_t up_s;      // uptime seconds at fire -- orders events even with no clock
  float    vbatt;     // battery voltage at the moment it fired
  uint8_t  src;       // 0 = auto (low voltage), 1 = manual (dashboard button),
                      // 2 = external (key/FOB -- detected from alternator voltage)
  uint8_t  ok;        // 1 = the CC1101 reported the burst went out
  uint8_t  ver;       // did the engine actually run? 0 = unknown, 1 = confirmed, 2 = no charge seen
  uint8_t  _pad;
};
StartEvent g_starts[START_N];
int       g_startCount = 0;
int       g_startHead  = 0;

Sample*   hist      = nullptr;               // ring buffer (in PSRAM)
int       histCount = 0;                     // valid samples (<= HIST_N)
int       histHead  = 0;                     // next write index
uint32_t  g_in_total = 0, g_out_total = 0;   // cumulative HTTP byte counters
uint32_t  lastInSnap = 0, lastOutSnap = 0;

SPIClass  tftSPI(HSPI);
Adafruit_ILI9341 tft(&tftSPI, TFT_DC, TFT_CS, TFT_RST);
XPT2046_Touchscreen ts(TS_CS, TS_IRQ);
int       dispMode = 0;                       // 0 = voltage, 1 = temperature
bool      dispTouchPrev = false;
char      dispLastVal[16] = "";

// CC1101 radio on its own SPI bus (FSPI), separate from the display's HSPI.
SPIClass        radioSPI(FSPI);
CC1101Compustar radio(&radioSPI, CC1101_SCK, CC1101_MISO, CC1101_MOSI,
                      CC1101_CS, CC1101_GDO0);
bool            rfReady = false;

// RF transmit status as a short string for the dashboard / JSON.
//   off     = RF_ENABLED is false
//   absent  = enabled but the CC1101 didn't answer on SPI
//   blocked = chip present but patterns not captured (placeholder secrets)
//   armed   = chip present AND real patterns loaded -> /transmit will TX
const char* rfStatusStr() {
  if (!RF_ENABLED) return "off";
  if (!rfReady)    return "absent";
  return COMPUSTAR_PATTERNS_CAPTURED ? "armed" : "blocked";
}

// Map a button name to its captured 35-bit pattern. nullptr if unknown.
const char* compustarPattern(const String& btn) {
  if (btn == "START")  return COMPUSTAR_START;
  if (btn == "LOCK")   return COMPUSTAR_LOCK;
  if (btn == "UNLOCK") return COMPUSTAR_UNLOCK;
  if (btn == "TRUNK")  return COMPUSTAR_TRUNK;
  return nullptr;
}

// ---------- CPU load ----------
// Real per-core utilisation, not a proxy. The Arduino ESP32 core ships with
// CONFIG_FREERTOS_GENERATE_RUN_TIME_STATS + USE_TRACE_FACILITY enabled and the
// counters clocked off esp_timer, so every task (including the two idle tasks)
// carries a microsecond run-time counter. Load on a core is simply the share of
// wall time its IDLE task did NOT get.
//
// Deliberately NOT the "spin a low-priority counter task" trick: that keeps a
// runnable task on the CPU forever, which defeats FreeRTOS tick-idling and would
// quietly raise the parked-car current draw.
float g_cpu0 = 0.0f, g_cpu1 = 0.0f;   // percent, 0..100 (latest 2 s window)
// Accumulated across the history interval so the graph plots the average load
// over the whole minute, not whichever 2 s window happened to land on it.
float    g_cpuAcc0 = 0.0f, g_cpuAcc1 = 0.0f;
uint16_t g_cpuN    = 0;

void sampleCpuLoad() {
  static uint32_t pIdle0 = 0, pIdle1 = 0, pTotal = 0;
  UBaseType_t n = uxTaskGetNumberOfTasks();
  TaskStatus_t* st = (TaskStatus_t*) malloc(n * sizeof(TaskStatus_t));
  if (!st) return;
  uint32_t total = 0;
  n = uxTaskGetSystemState(st, n, &total);
  uint32_t idle0 = 0, idle1 = 0;
  for (UBaseType_t i = 0; i < n; i++) {
    const char* nm = st[i].pcTaskName;
    if (nm && strncmp(nm, "IDLE", 4) == 0) {
      if      (nm[4] == '1') idle1 = st[i].ulRunTimeCounter;
      else                   idle0 = st[i].ulRunTimeCounter;   // "IDLE0" or plain "IDLE"
    }
  }
  free(st);
  uint32_t dT = total - pTotal;              // unsigned math handles the wrap
  if (pTotal != 0 && dT > 0) {
    uint32_t d0 = idle0 - pIdle0, d1 = idle1 - pIdle1;
    float l0 = 100.0f - (100.0f * (float)d0 / (float)dT);
    float l1 = 100.0f - (100.0f * (float)d1 / (float)dT);
    g_cpu0 = l0 < 0 ? 0 : (l0 > 100 ? 100 : l0);
    g_cpu1 = l1 < 0 ? 0 : (l1 > 100 ? 100 : l1);
    g_cpuAcc0 += g_cpu0; g_cpuAcc1 += g_cpu1; g_cpuN++;
  }
  pIdle0 = idle0; pIdle1 = idle1; pTotal = total;
}

float readBatteryVolts() {
  uint32_t acc = 0;
  for (int i = 0; i < SAMPLES; i++) acc += analogReadMilliVolts(VSENSE_PIN);
  g_last_mv = (int)(acc / SAMPLES);
  g_lastV = (g_last_mv / 1000.0f) * DIVIDER * CAL;
  return g_lastV;
}

// Bound how long a SINGLE chunked write may block.
//
// NetworkClient::write() retries up to WIFI_CLIENT_MAX_WRITE_RETRY (10) times,
// each doing a 1 s select() plus a send() bounded by SO_SNDTIMEO -- and
// WebServer sets that from HTTP_MAX_SEND_WAIT, which is 5000 ms. So one write
// against a stalled client can block ~10 x (1 + 5) = 60 s, TWICE the 30 s task
// watchdog.
//
// This is why fw 4.24 did not fix it. 4.24 fed the WDT *between* chunks, which
// helps a merely-slow client, but the feed sits AFTER the write -- and a write
// that never returns is never followed. Confirmed in the field on 4.26:
// "WDT stall: loop was '/history'". Bounding the socket to 1000 ms caps one
// write at ~10 x (1 + 1) = 20 s, comfortably inside the watchdog, after which
// the per-chunk feed does its job.
static void boundSendStall() { server.client().setTimeout(1000); }

// Wait until the socket will actually accept a write, WITHOUT ever entering a
// blocking write, and WITHOUT weakening the watchdog.
//
// Why the two previous attempts failed. NetworkClient::write() retries up to
// WIFI_CLIENT_MAX_WRITE_RETRY (10) times, each with a HARDCODED 1 s select()
// (WIFI_CLIENT_SELECT_TIMEOUT_US) -- so a single write has a ~10 s floor no
// matter what SO_SNDTIMEO is, and sendContent() issues several writes per chunk.
// fw 4.24 fed the WDT *between* chunks (never reached, the feed is after the
// write) and fw 4.27 shrank SO_SNDTIMEO (cannot touch the hardcoded select
// floor). Both still tripped the 30 s watchdog on /history.
//
// So: poll the socket ourselves in short slices and only send when it is ready.
// The WDT is reset each slice because WE own the wait -- it stays fully armed,
// and a genuine hang anywhere else still reboots the board as before. A client
// that never drains gets the response aborted rather than hanging the loop.
static bool waitWritable(uint32_t budget_ms) {
  int fd = server.client().fd();
  if (fd < 0) return false;
  uint32_t t0 = millis();
  while ((uint32_t)(millis() - t0) < budget_ms) {
    if (!server.client().connected()) return false;
    fd_set w; FD_ZERO(&w); FD_SET(fd, &w);
    struct timeval tv; tv.tv_sec = 0; tv.tv_usec = 50 * 1000;   // 50 ms slice
    int r = ::select(fd + 1, nullptr, &w, nullptr, &tv);
    if (r > 0) return true;
    if (r < 0) return false;
    esp_task_wdt_reset();          // our wait, our feed -- watchdog stays armed
  }
  return false;                    // stalled client -> abort, do not block the loop
}

void trackReq() {
  String u = server.uri();
  g_in_total += u.length() + 120;   // approx request size
  // Finer WDT breadcrumb: record WHICH endpoint, not a generic 'http', so that
  // if a stall happens inside this handler the next boot names it. loopMark()
  // strncpy's into a fixed RTC buffer, so the temporary String is safe here.
  loopMark(u.c_str());
}

const char* voltStatus(float v) {
  if (v < V_LOW || v > V_HIGH) return "red";   // too low or over-voltage
  if (v < V_MID) return "blue";                // V_LOW <= v < V_MID
  return "green";                              // V_MID <= v <= V_HIGH
}

void updateLed(float v) {
  if (!LED_ENABLED) { rgbLedWrite(LED_PIN, 0, 0, 0); return; }   // disabled -> LED off
  const char* s = voltStatus(v);
  uint8_t r = (s[0] == 'r') ? LED_BRIGHT : 0;
  uint8_t g = (s[0] == 'g') ? LED_BRIGHT : 0;
  uint8_t b = (s[0] == 'b') ? LED_BRIGHT : 0;
  rgbLedWrite(LED_PIN, r, g, b);
}

uint16_t statusColor16(float v) {
  const char* s = voltStatus(v);
  if (s[0] == 'r') return tft.color565(240, 70, 70);
  if (s[0] == 'g') return tft.color565(60, 200, 90);
  return tft.color565(80, 150, 255);
}

void dispDrawStatic() {
  tft.fillScreen(ILI9341_BLACK);
  tft.setFont(&FreeSans12pt7b);
  tft.setTextColor(ILI9341_WHITE);
  tft.setCursor(12, 30);
  tft.print(dispMode == 0 ? "VOLTAGE" : "CHIP TEMP");
  const char* unit = (dispMode == 0) ? "VOLTS" : "deg C";
  int16_t x1, y1; uint16_t w, h;
  tft.getTextBounds(unit, 0, 0, &x1, &y1, &w, &h);
  tft.setCursor((320 - (int)w) / 2 - x1, 210);
  tft.print(unit);
  tft.setFont(NULL); tft.setTextSize(1); tft.setTextColor(0x7BEF);
  tft.setCursor(12, 230);
  tft.print("tap to toggle");
  dispLastVal[0] = 0;                           // force the value to redraw
}

void dispDrawValue(float v, float tC) {
  char buf[16];
  uint16_t col;
  if (dispMode == 0) { snprintf(buf, sizeof(buf), "%.2f", v);  col = statusColor16(v); }
  else               { snprintf(buf, sizeof(buf), "%.1f", tC); col = ILI9341_WHITE; }
  if (strcmp(buf, dispLastVal) == 0) return;    // unchanged -> skip (no flicker)
  strcpy(dispLastVal, buf);
  tft.fillRect(0, 55, 320, 120, ILI9341_BLACK); // clear the number band
  tft.setFont(&FreeSansBold24pt7b);
  tft.setTextSize(2);
  tft.setTextColor(col);
  int16_t x1, y1; uint16_t w, h;
  tft.getTextBounds(buf, 0, 0, &x1, &y1, &w, &h);
  tft.setCursor((320 - (int)w) / 2 - x1, 150);
  tft.print(buf);
}

// ---------- battery drain rate ----------
// Least-squares fit of voltage against time over the most recent *parked*
// stretch of history, so the slope is the actual discharge rate.
//
// The point of this is the parasitic-drain hunt: pull one fuse, let it sit,
// and compare mV/h against the previous run. That turns "does this trace look
// flatter?" into a number, which is the difference between a diagnosis and a
// hunch. r2 is reported because over a short window the slope is mostly noise
// -- a low r2 means "don't trust this yet, leave it longer".
DrainFit computeDrain() {
  DrainFit f; f.ok = false; f.mvph = 0; f.r2 = 0; f.n = 0; f.win_s = 0; f.days = -1;
  if (!hist || histCount < 1) return f;
  // NB: don't early-return on histCount < DRAIN_MIN_N here -- that would report a
  // bare n=0 and the UI reads "0 of 30 min" (looks broken) whenever total history
  // is short, e.g. right after a reboot or a storage-format reset. Run Pass 1 so
  // f.n reflects the real partial window; the n < DRAIN_MIN_N guard below still
  // withholds the fitted slope until there's enough data.
  int oldest = (histCount < HIST_N) ? 0 : histHead;

  // Pass 1 -- find the most recent contiguous parked window (newest backwards).
  // Two passes rather than buffering, to keep ~11 KB of arrays off the heap.
  int n = 0; uint32_t prevTs = 0, oldTs = 0, newTs = 0; bool useTs = true; float vNow = 0;
  for (int k = histCount - 1; k >= 0; k--) {
    Sample& s = hist[(oldest + k) % HIST_N];
    if (s.vbatt >= AS_ALT_V) break;       // alternator was running -- window ends
    if (s.vbatt < 1.0f)      break;       // implausible / no source
    uint32_t t = (s.ts > 1700000000UL) ? s.ts : 0;
    if (!t) useTs = false;
    else if (prevTs && (prevTs - t) > DRAIN_GAP_S) break;   // gap: board was off
    if (n == 0) { vNow = s.vbatt; newTs = t; }              // newest end of the window
    if (t) prevTs = t;
    oldTs = t;
    n++;
  }
  // Report the partial window even when it's too short to fit, so the UI can
  // show honest progress ("need 10 more minutes") instead of a bare 0 that
  // reads as broken. A reboot ends the window, so this counts up from the
  // last power cycle, not from the start of history.
  f.n = n;
  if (n < DRAIN_MIN_N) return f;

  // Pass 2 -- two-variable least squares: V = a*x + b*T + c, x = time (s),
  // T = chip temperature. Temperature explains roughly half the parked voltage
  // wobble (diurnal warming/cooling), so a plain V-vs-time slope is noisy. The a
  // term here is the true discharge rate with that thermal swing regressed out;
  // b is the temperature coefficient (mV/degC). Falls back to a plain V-vs-time
  // fit when the window shows no temperature variation.
  double sx = 0, sy = 0, st = 0, sxx = 0, stt = 0, sxt = 0, sxy = 0, sty = 0, syy = 0;
  int i = 0;
  for (int k = histCount - 1; k >= 0 && i < n; k--, i++) {
    Sample& s = hist[(oldest + k) % HIST_N];
    double x = useTs ? (double)(s.ts - oldTs)
                     : (double)((n - 1 - i) * (SAMPLE_MS / 1000));
    double y = s.vbatt;
    double T = s.temp;
    sx += x; sy += y; st += T;
    sxx += x * x; stt += T * T; sxt += x * T;
    sxy += x * y; sty += T * y; syy += y * y;
  }
  double N = (double)n;
  double Sxx = sxx - sx * sx / N;      // centered cross-products
  double Stt = stt - st * st / N;
  double Sxt = sxt - sx * st / N;
  double Sxy = sxy - sx * sy / N;
  double Sty = sty - st * sy / N;
  double Syy = syy - sy * sy / N;
  if (Sxx <= 0 || Syy <= 0) return f;
  double slope, ssr, tempCoef = 0.0;
  double D = Sxx * Stt - Sxt * Sxt;
  if (Stt > 1e-9 && D > 1e-9) {                 // temperature varies -> 2-var fit
    slope    = (Sxy * Stt - Sty * Sxt) / D;     // V/s, thermal effect removed
    tempCoef = (Sty * Sxx - Sxy * Sxt) / D;     // V/degC
    ssr      = slope * Sxy + tempCoef * Sty;    // regression sum of squares
  } else {                                       // flat temp -> plain V-vs-time
    slope = Sxy / Sxx;
    ssr   = slope * Sxy;
  }
  f.r2 = (float)(ssr / Syy);
  if (f.r2 < 0) f.r2 = 0;
  if (f.r2 > 1) f.r2 = 1;
  f.mvph     = (float)(slope * 1000.0 * 3600.0);
  f.mv_per_c = (float)(tempCoef * 1000.0);
  f.n        = n;
  f.win_s    = (useTs && newTs > oldTs) ? (uint32_t)(newTs - oldTs)
                                        : (uint32_t)((n - 1) * (SAMPLE_MS / 1000));
  f.ok       = true;
  if (slope < 0) {                               // project time to flat at the true rate
    double perDay = -slope * 86400.0;
    if (perDay > 1e-9) f.days = (float)((vNow - DRAIN_FLAT_V) / perDay);
  }
  return f;
}

// Is the parked-drain fit trustworthy enough to GRAPH and to project an ETA from?
// computeDrain() reports ok as soon as there are 30 samples, but a just-settled
// or post-gap window can show a steep, spurious slope -- that is the "spike" that
// misrepresents the graph and produces a bogus short ETA ("4 h" when it's really
// days). Requiring a decent fit quality AND at least an hour of continuous parked
// data rejects those transients; until then drain reads "settling" (0 on the
// graph, no ETA) instead of a wrong number.
static const float    DRAIN_TRUST_R2  = 0.6f;
static const uint32_t DRAIN_TRUST_WIN = 3600;    // >= 1 h continuous parked window
static const float    DRAIN_MAX_MVPH  = 40.0f;   // |rate| above this isn't real parked drain --
                                                 // it's a confound (reboot-spanning fit, a CPU-clock
                                                 // voltage step, or post-drive surface-charge settling).
                                                 // The trigger is voltage-threshold based, so capping
                                                 // the *projection* here is safe; it just reads
                                                 // "settling" until a believable slow slope emerges.
static inline bool drainTrusted() {
  return g_drain.ok && g_drain.r2 >= DRAIN_TRUST_R2 && g_drain.win_s >= DRAIN_TRUST_WIN
      && fabsf(g_drain.mvph) <= DRAIN_MAX_MVPH;
}

// Estimated seconds until low-voltage auto-start would fire: project the current
// parked drain rate (g_drain) down to the trigger threshold, then add the
// sustain hold. Same math as the "projected to 11.8 V" countdown, but the target
// is the user's g_as_volts and it includes g_as_hold. Returns -1 when it doesn't
// apply -- auto-start disarmed or locked, no trustworthy discharging fit yet, or
// the battery is holding/charging so it won't reach the threshold at this rate.
// If voltage is already below the threshold, returns the sustain time remaining.
long autoStartEtaS(float v) {
  if (!g_as_en || g_asLock) return -1;
  if (v < g_as_volts) {                                 // already low: hold remaining
    if (g_lowSince == 0) return (long)g_as_hold;
    long rem = (long)g_as_hold - (long)((millis() - g_lowSince) / 1000);
    return rem > 0 ? rem : 0;
  }
  // Prefer the long-term anchored estimate wherever one exists. It spans days
  // from a fixed point at the SAME phase of the settling curve, so it is not
  // distorted by the diurnal thermal swing -- which on this car is ~130 mV
  // against a ~20 mV daily trend, i.e. the noise is several times the signal.
  // It also survives reboots. The 24 h least-squares fit below is only a
  // fallback for when no anchor exists yet: it is a short window, it restarts on
  // every reboot, and it reads day/night cycling as depletion.
  long lt = longTermEtaS(v);
  if (lt >= 0) return lt + (long)g_as_hold;

  if (!drainTrusted() || g_drain.mvph >= 0) return -1;  // no trustworthy fit, or not discharging
  double vps = (-(double)g_drain.mvph) / 3600000.0;     // mV/h -> V/s (positive)
  if (vps < 1e-12) return -1;
  double toThresh = ((double)v - (double)g_as_volts) / vps;
  return (long)(toThresh + (double)g_as_hold);
}


void recordSample() {
  if (!hist) return;
  Sample s;
  s.ts      = timeIsValid() ? (uint32_t)time(nullptr) : 0;
  s.vbatt   = readBatteryVolts();
  s.temp    = g_lastTemp;            // refreshed by the safety task just before this call
  s.heap_kb = (uint16_t)(ESP.getFreeHeap() / 1024);
  // Reading the filesystem here means core 0 touching flash. During an OTA that
  // races Update.write()'s erases, so reuse the last value instead.
  static uint16_t lastDiskKb = 0;
  if (!g_otaActive) lastDiskKb = (uint16_t)(LittleFS.usedBytes() / 1024);
  s.disk_kb = lastDiskKb;
  s.net_in  = g_in_total  - lastInSnap;   lastInSnap  = g_in_total;
  s.net_out = g_out_total - lastOutSnap;  lastOutSnap = g_out_total;
  s.rssi    = apMode ? 0 : (int16_t)WiFi.RSSI();
  s.cpu0    = g_cpuN ? (uint8_t)(g_cpuAcc0 / g_cpuN + 0.5f) : (uint8_t)(g_cpu0 + 0.5f);
  s.cpu1    = g_cpuN ? (uint8_t)(g_cpuAcc1 / g_cpuN + 0.5f) : (uint8_t)(g_cpu1 + 0.5f);
  // Stored one cycle behind (computeDrain runs at the end of this function), which
  // is a 60 s lag on a metric that moves over hours -- fine. 0 until the fit is
  // trustworthy, so a settling/post-gap transient can't spike the graph.
  float mv = drainTrusted() ? g_drain.mvph : 0.0f;
  if (mv >  32000.0f) mv =  32000.0f;
  if (mv < -32000.0f) mv = -32000.0f;
  s.drain   = (int16_t)lroundf(mv);
  s.link_mbps = staLinkMbps();
  g_cpuAcc0 = 0; g_cpuAcc1 = 0; g_cpuN = 0;      // start a fresh interval average
  hist[histHead] = s;
  histHead = (histHead + 1) % HIST_N;
  if (histCount < HIST_N) histCount++;

  // Tier 1: park it in RTC RAM. No flash traffic here -- this is the safety task
  // on core 0, which must never touch the filesystem. When the batch fills, ask
  // the loop to write it.
  portENTER_CRITICAL(&g_sbMux);
  if (g_sbMagic != SB_MAGIC) { g_sbMagic = SB_MAGIC; g_sbN = 0; }
  if (g_sbN < SB_N) g_sb[g_sbN++] = s;
  bool full = (g_sbN >= SB_N);
  portEXIT_CRITICAL(&g_sbMux);
  if (full) g_sbFlush = true;

  g_drain = computeDrain();     // refresh once per sample, not per HTTP poll

  // Fold this sample into the current hourly bucket. RAM only -- the loop core
  // owns all flash I/O, so we just flag a completed bucket for it to persist.
  if (s.ts && s.vbatt > 8.0f && s.vbatt < 16.0f) {
    uint32_t hr = s.ts / 3600;
    if (g_drHour == 0) { g_drHour = hr; agReset(); }
    if (hr != g_drHour) {
      if (g_drCnt) {
        HourAgg b;
        b.ts = g_drHour * 3600 + 1800;            // midpoint of the hour it covers
        for (int i = 0; i < AG_N; i++) {
          b.mean[i] = (float)(g_agSum[i] / g_drCnt);
          b.mn[i]   = g_agMin[i];
          b.mx[i]   = g_agMax[i];
        }
        drPush(b);
        g_drPend = b; g_drPending = true;         // loop appends it to flash
        g_hfit = computeHourlyDrain();            // refresh once per hour, not per poll
      }
      agReset(); g_drHour = hr;
    }
    float av[AG_N];
    agFromSample(av, s);
    for (int i = 0; i < AG_N; i++) {
      g_agSum[i] += av[i];
      if (av[i] < g_agMin[i]) g_agMin[i] = av[i];
      if (av[i] > g_agMax[i]) g_agMax[i] = av[i];
    }
    g_drCnt++;

    // Daily tier. Unlike the hourly bucket this is NOT discarded when the engine
    // starts: a day on which the car ran is real data, and the min/max make the
    //14 V excursion visible rather than hiding it in the mean.
    uint32_t dy = s.ts / 86400;
    if (g_dyDay == 0) { g_dyDay = dy; dyReset(); }
    if (dy != g_dyDay) {
      if (g_dyCnt) {
        HourAgg b;
        b.ts = g_dyDay * 86400 + 43200;           // midday of the day it covers
        for (int i = 0; i < AG_N; i++) {
          b.mean[i] = (float)(g_dySum[i] / g_dyCnt);
          b.mn[i]   = g_dyMin[i];
          b.mx[i]   = g_dyMax[i];
        }
        dyPush(b);
        g_dyPend = b; g_dyPending = true;         // loop appends it to flash
      }
      dyReset(); g_dyDay = dy;
    }
    for (int i = 0; i < AG_N; i++) {
      g_dySum[i] += av[i];
      if (av[i] < g_dyMin[i]) g_dyMin[i] = av[i];
      if (av[i] > g_dyMax[i]) g_dyMax[i] = av[i];
    }
    g_dyCnt++;
  }

  // Board-health warning: log if free heap crosses below a floor (a leak or
  // memory pressure would show here) -- latched so it fires once per crossing.
  static bool heapWarned = false;
  uint32_t freeHeap = ESP.getFreeHeap();
  if (!heapWarned && freeHeap < 40000)      { logLine("WARNING: low heap %lu bytes", (unsigned long)freeHeap); heapWarned = true; }
  else if (heapWarned && freeHeap > 60000)  { logLine("heap recovered (%lu bytes)", (unsigned long)freeHeap); heapWarned = false; }
}

// ---- Tier 2 of sample storage: append-only journal ------------------------
// Two generations, rotated, never rewritten in place -- the same shape as the
// event log above, for the same reason. A full-file rewrite costs its whole
// length in flash traffic every time; an append costs one record.
static const char* JRN_FILE = "/hist.jrn";
static const char* JRN_OLD  = "/hist.old";
static const uint32_t JRN_MAGIC = 0x564A5232;          // "VJR2" -- bumped if Sample changes

// One generation holds a full ring, so .old + .jrn always cover >= HIST_N.
static const size_t JRN_CAP = 8 + sizeof(Sample) * HIST_N;

static void jrnHeader(File& f) {
  uint32_t m = JRN_MAGIC; uint32_t sz = (uint32_t)sizeof(Sample);
  f.write((uint8_t*)&m, 4); f.write((uint8_t*)&sz, 4);
}

// Drain the RTC batch to flash. LOOP CORE ONLY -- the safety task sets g_sbFlush
// and never touches the filesystem itself.
void flushSamplesToFlash() {
  if (!g_sbFlush) return;
  g_sbFlush = false;
  uint16_t n = g_sbN;
  if (!n) return;
  if (n > SB_N) n = SB_N;                              // corrupt count: salvage what fits

  bool fresh = !LittleFS.exists(JRN_FILE);
  File f = LittleFS.open(JRN_FILE, FILE_APPEND);
  if (!f) return;
  if (fresh) jrnHeader(f);
  f.write((uint8_t*)g_sb, sizeof(Sample) * n);
  size_t sz = f.size();
  f.close();
  g_fsBytes += sizeof(Sample) * n + (fresh ? 8 : 0);
  g_fsCommits++;

  // Consume exactly the n we wrote. A sample taken by the safety task during the
  // write is still at the tail, so shift it down rather than zeroing the count --
  // zeroing would drop it from flash while leaving it in the RAM ring, and the
  // two would disagree after the next reboot.
  portENTER_CRITICAL(&g_sbMux);
  if (g_sbN > n) memmove(g_sb, g_sb + n, (g_sbN - n) * sizeof(Sample));
  g_sbN = (g_sbN > n) ? (uint16_t)(g_sbN - n) : 0;
  portEXIT_CRITICAL(&g_sbMux);

  if (sz >= JRN_CAP) {                                 // keep exactly one prior generation
    LittleFS.remove(JRN_OLD);
    LittleFS.rename(JRN_FILE, JRN_OLD);
  }
}

// Replay one journal generation into the ring. Chronological order across the
// two files is guaranteed by the caller (.old first).
static int replayJournal(const char* path) {
  if (!hist || !LittleFS.exists(path)) return 0;
  File f = LittleFS.open(path, FILE_READ);
  if (!f) return 0;
  uint32_t m = 0, sz = 0;
  f.read((uint8_t*)&m, 4); f.read((uint8_t*)&sz, 4);
  if (m != JRN_MAGIC || sz != sizeof(Sample)) { f.close(); return 0; }  // format changed
  int n = 0;
  Sample s;
  while (f.read((uint8_t*)&s, sizeof(Sample)) == (int)sizeof(Sample)) {
    hist[histHead] = s;
    histHead = (histHead + 1) % HIST_N;
    if (histCount < HIST_N) histCount++;
    n++;
  }
  f.close();
  return n;
}

// Write the whole ring into a fresh journal, oldest sample first.
// 4.37's migration read /history.bin into the RAM ring and deleted the file
// WITHOUT this step, so the samples lived only in volatile RAM and were lost at
// the next reboot. Anything that puts samples in the ring from outside the
// journal has to call this before the source is discarded.
static int seedJournalFromRing() {
  if (!hist || histCount <= 0) return 0;
  LittleFS.remove(JRN_FILE);
  File f = LittleFS.open(JRN_FILE, FILE_WRITE);
  if (!f) return 0;
  jrnHeader(f);
  int idx = (histHead - histCount + HIST_N) % HIST_N;   // oldest first
  for (int k = 0; k < histCount; k++) {
    f.write((uint8_t*)&hist[idx], sizeof(Sample));
    idx = (idx + 1) % HIST_N;
  }
  f.close();
  g_fsBytes += 8 + sizeof(Sample) * histCount; g_fsCommits++;
  return histCount;
}

// Rebuild the ring at boot, oldest source first: the pre-4.37 snapshot (once),
// then both journal generations, then whatever is still sitting in RTC RAM.
void loadHistory() {
  if (!hist) return;

  // One-time migration off /history.bin so upgrading does not throw away the
  // last 24 h. The file is removed after reading; from then on it is journal only.
  if (LittleFS.exists("/history.bin")) {
    File f = LittleFS.open("/history.bin", FILE_READ);
    if (f) {
      uint32_t magic = 0;
      f.read((uint8_t*)&magic, 4);
      if (magic == 0x564F4C36) {       // older formats are discarded (layout changed)
        f.read((uint8_t*)&histCount, 4);
        f.read((uint8_t*)&histHead, 4);
        f.read((uint8_t*)hist, sizeof(Sample) * HIST_N);
        if (histCount < 0 || histCount > HIST_N) { histCount = 0; histHead = 0; }
      }
      f.close();
    }
    // Get it onto flash BEFORE dropping the source. If the seed fails, keep
    // /history.bin so the next boot can retry rather than losing the lot.
    int seeded = seedJournalFromRing();
    if (seeded > 0) {
      LittleFS.remove("/history.bin");
      Serial.printf("history: migrated %d samples from /history.bin into the journal\n", seeded);
    } else {
      Serial.println("history: journal seed FAILED -- keeping /history.bin for retry");
    }
  }

  int a = replayJournal(JRN_OLD);
  int b = replayJournal(JRN_FILE);

  // The RTC batch that had not reached flash when we reset. This is the whole
  // point of the RTC tier -- a watchdog reboot now loses nothing.
  int c = 0;
  if (g_sbMagic == SB_MAGIC && g_sbN > 0 && g_sbN <= SB_N) {
    for (uint16_t i = 0; i < g_sbN; i++) {
      hist[histHead] = g_sb[i];
      histHead = (histHead + 1) % HIST_N;
      if (histCount < HIST_N) histCount++;
      c++;
    }
    g_sbFlush = true;                  // and get them onto flash on the first loop
  } else {
    g_sbMagic = SB_MAGIC; g_sbN = 0;   // cold boot: initialise the buffer
  }
  if (a || b || c)
    Serial.printf("history: replayed %d old + %d journal + %d RTC = %d samples\n",
                  a, b, c, a + b + c);
}

// ---- countdown window bookkeeping ----------------------------------------
// Returns true if the caller should log this event individually.
static bool cdNote(CdWin& w, uint32_t nowMs, float v, uint32_t secs, const char* why) {
  if (w.t0ms == 0 || (uint32_t)(nowMs - w.t0ms) >= CD_WIN_MS) {
    w.t0ms = nowMs; w.n = 0; w.suppressed = 0;
    w.vmin = 1e30f; w.vmax = -1e30f; w.smax = 0; w.whys = 0;
  }
  w.n++;
  if (v < w.vmin) w.vmin = v;
  if (v > w.vmax) w.vmax = v;
  if (secs > w.smax) w.smax = secs;
  if (why) {
    int slot = -1;
    for (int i = 0; i < w.whys; i++) if (strcmp(w.why[i], why) == 0) { slot = i; break; }
    if (slot < 0 && w.whys < CD_WHY_N) { slot = w.whys++; w.why[slot] = why; w.whyN[slot] = 0; }
    if (slot >= 0) w.whyN[slot]++;
  }
  if (w.n <= CD_VERBOSE) return true;
  w.suppressed++;
  return false;
}

// Emit the summary for a window that has anything suppressed, and clear it.
static void cdFlush(CdWin& w, bool isReset) {
  if (w.t0ms == 0) { return; }
  if (w.n == 0) { w.t0ms = 0; return; }
  uint32_t mins = CD_WIN_MS / 60000UL;
  if (isReset) {
    char reasons[40]; reasons[0] = 0;          // budget-capped; truncates, never overruns
    for (int i = 0; i < w.whys; i++) {
      size_t l = strlen(reasons);
      if (l + 8 >= sizeof(reasons)) break;
      snprintf(reasons + l, sizeof(reasons) - l, "%s%s x%u",
               l ? ", " : "", w.why[i], (unsigned)w.whyN[i]);
    }
    logLine("countdown: %u reset%s/%lum, %.2f-%.2f V, max %lus/%lus -- %s",
            (unsigned)w.n, w.n == 1 ? "" : "s", (unsigned long)mins,
            w.vmin, w.vmax, (unsigned long)w.smax, (unsigned long)g_as_hold,
            reasons[0] ? reasons : "recovered");
  } else {
    logLine("countdown: %u start%s/%lum, %.2f-%.2f V (trigger %.2f, need %lus)",
            (unsigned)w.n, w.n == 1 ? "" : "s", (unsigned long)mins,
            w.vmin, w.vmax, g_as_volts, (unsigned long)g_as_hold);
  }
  w.t0ms = 0;
}

// Close both windows if they have expired, or unconditionally when something
// worth reading in order is about to be logged (a fire, an engine edge) so the
// summary never lands after the event it preceded.
void cdMaybeFlush(uint32_t nowMs, bool force) {
  if (g_cdStart.t0ms && (force || (uint32_t)(nowMs - g_cdStart.t0ms) >= CD_WIN_MS)) cdFlush(g_cdStart, false);
  if (g_cdReset.t0ms && (force || (uint32_t)(nowMs - g_cdReset.t0ms) >= CD_WIN_MS)) cdFlush(g_cdReset, true);
}

// ---------- start-event log (LittleFS, survives reboot/brownout) ----------

void saveStarts() {
  File f = LittleFS.open("/starts.bin", FILE_WRITE);
  if (!f) return;
  uint32_t magic = 0x53545231;                 // "STR1"
  f.write((uint8_t*)&magic, 4);
  f.write((uint8_t*)&g_startCount, 4);
  f.write((uint8_t*)&g_startHead, 4);
  f.write((uint8_t*)g_starts, sizeof(StartEvent) * START_N);
  f.close();
}

void loadStarts() {
  if (!LittleFS.exists("/starts.bin")) return;
  File f = LittleFS.open("/starts.bin", FILE_READ);
  if (!f) return;
  uint32_t magic = 0;
  f.read((uint8_t*)&magic, 4);
  if (magic == 0x53545231) {
    f.read((uint8_t*)&g_startCount, 4);
    f.read((uint8_t*)&g_startHead, 4);
    f.read((uint8_t*)g_starts, sizeof(StartEvent) * START_N);
    if (g_startCount < 0 || g_startCount > START_N ||
        g_startHead  < 0 || g_startHead  >= START_N) { g_startCount = 0; g_startHead = 0; }
  }
  f.close();
}

// ---------- event-log persistence (LittleFS, survives reboot/brownout) ----------
// The event-log ring lives in PSRAM and is wiped on reboot -- useless for
// answering "what happened right before it rebooted". So we mirror it to a small
// rolling file: append new lines to /log.txt, and once it passes LOG_FILE_CAP
// rotate it to /log.old (one prior generation kept), bounding disk to ~2x the
// cap. On boot the tail of both files is replayed back into the ring. Every
// flash write happens from the loop via flushLogToFlash(); logLine() itself
// never touches the filesystem, so file I/O stays off the critical section and
// off the safety-task core.
static const char*  LOG_FILE     = "/log.txt";
static const char*  LOG_OLD      = "/log.old";
static const size_t LOG_FILE_CAP = 49152;      // 48 KB -> rotate; ~96 KB max on disk (of ~10 MB)

// Push a pre-formatted line straight into the ring, keeping its original
// timestamp and WITHOUT re-persisting it. Used only to replay flash on boot.
static void logRingPush(const char* line) {
  if (!g_log) return;
  strncpy(g_log[g_logHead], line, LOG_LEN - 1); g_log[g_logHead][LOG_LEN - 1] = 0;
  g_logHead = (g_logHead + 1) % LOG_LINES;
  if (g_logCount < LOG_LINES) g_logCount++;
}

// Append any ring lines not yet on flash. LOOP-CORE ONLY (single-threaded file
// I/O). Cheap when idle -- the fast path returns before taking the lock.
// Write the reconstruction, once, if there is no run history at all yet.
void seedRunHistory() {
  if (LittleFS.exists(RUN_FILE) || LittleFS.exists(RUN_OLD)) return;
  File f = LittleFS.open(RUN_FILE, FILE_WRITE);
  if (!f) return;
  uint32_t m = RUN_MAGIC, r = (uint32_t)sizeof(RunEvent);
  f.write((uint8_t*)&m, 4); f.write((uint8_t*)&r, 4);
  for (int i = 0; i < RUN_SEED_N; i++) {
    RunEvent e;
    e.ts = RUN_SEED[i].ts; e.kind = RUN_SEED[i].kind; e.src = RUN_SEED[i].src;
    e.flags = RUN_SEED[i].flags; e._rsv = 0;
    e.v = RUN_SEED[i].v; e.dur_s = RUN_SEED[i].dur;
    f.write((uint8_t*)&e, sizeof(RunEvent));
  }
  f.close();
  g_fsBytes += 8 + sizeof(RunEvent) * RUN_SEED_N; g_fsCommits++;
  logLine("run history seeded with %d reconstructed events (marked as such)", RUN_SEED_N);
}

// Queue a run event. Safe from either core: RAM only, no allocation.
// ts = 0 means "now"; a debounced edge passes the moment it actually happened.
void runLogAt(uint32_t ts, uint8_t kind, uint8_t src, float v, uint32_t dur_s, uint8_t flags) {
  if (!timeIsValid()) return;                 // an event with no date is not worth keeping
  RunEvent e;
  e.ts = ts ? ts : (uint32_t)time(nullptr);
  e.kind = kind; e.src = src; e.flags = flags; e._rsv = 0;
  e.v = v; e.dur_s = dur_s;
  portENTER_CRITICAL(&g_runqMux);
  int nxt = (g_runqHead + 1) % RUNQ_N;
  if (nxt != g_runqTail) { g_runq[g_runqHead] = e; g_runqHead = nxt; }   // full -> drop, never block
  portEXIT_CRITICAL(&g_runqMux);
}
void runLog(uint8_t kind, uint8_t src, float v, uint32_t dur_s, uint8_t flags) {
  runLogAt(0, kind, src, v, dur_s, flags);
}

// Drain the queue to flash. LOOP CORE ONLY.
void flushRunsToFlash() {
  for (;;) {
    RunEvent e;
    portENTER_CRITICAL(&g_runqMux);
    bool has = (g_runqTail != g_runqHead);
    if (has) { e = g_runq[g_runqTail]; g_runqTail = (g_runqTail + 1) % RUNQ_N; }
    portEXIT_CRITICAL(&g_runqMux);
    if (!has) return;

    bool fresh = !LittleFS.exists(RUN_FILE);
    File f = LittleFS.open(RUN_FILE, FILE_APPEND);
    if (!f) return;
    if (fresh) { uint32_t m = RUN_MAGIC, r = (uint32_t)sizeof(RunEvent);
                 f.write((uint8_t*)&m, 4); f.write((uint8_t*)&r, 4); }
    f.write((uint8_t*)&e, sizeof(RunEvent));
    size_t sz = f.size();
    f.close();
    g_fsBytes += sizeof(RunEvent) + (fresh ? 8 : 0); g_fsCommits++;
    if (sz >= 8 + (size_t)RUN_ROTATE * sizeof(RunEvent)) {
      LittleFS.remove(RUN_OLD);
      LittleFS.rename(RUN_FILE, RUN_OLD);
    }
  }
}

// fw 4.78: the safety task asks for a run's ON record to be re-dated when the ECU's
// run-time counter puts the start earlier than voltage did (see evalAutoStart). Records
// are fixed-size, so the loop rewrites that one record in place. LOOP CORE ONLY.
static volatile uint32_t g_runFixOldTs = 0, g_runFixNewTs = 0;   // guarded by g_runqMux
void fixRunStartOnFlash() {
  uint32_t oldTs, newTs;
  portENTER_CRITICAL(&g_runqMux);
  oldTs = g_runFixOldTs; newTs = g_runFixNewTs; g_runFixOldTs = 0;
  portEXIT_CRITICAL(&g_runqMux);
  if (!oldTs) return;
  flushRunsToFlash();                              // the ON record has to be on flash first
  bool done = false;
  File f = LittleFS.open(RUN_FILE, "r+");
  if (f && f.size() >= 8 + sizeof(RunEvent)) {
    size_t n = (f.size() - 8) / sizeof(RunEvent);
    for (size_t k = 0; k < n && k < 8 && !done; k++) {   // the newest few records
      size_t off = 8 + (n - 1 - k) * sizeof(RunEvent);
      RunEvent e;
      if (!f.seek(off) || f.read((uint8_t*)&e, sizeof(e)) != sizeof(e)) break;
      if (e.kind == RUN_ON && e.ts == oldTs) {
        e.ts = newTs;
        e.flags |= RUN_F_OBD;
        done = f.seek(off) && f.write((uint8_t*)&e, sizeof(e)) == sizeof(e);
      }
    }
  }
  if (f) f.close();
  if (done) { g_fsBytes += sizeof(RunEvent); g_fsCommits++; }
  else logLine("run log: could not re-date the ON record at %lu", (unsigned long)oldTs);
}

// Close a run that was left open by a reboot. LOOP CORE ONLY (touches LittleFS).
//
// engRunning used to be a plain function-static, so it zeroed on every boot. Two
// ways that lost data:
//   * Reboot (or OTA) while the engine runs -> the ON never gets its OFF, and the
//     next start appends a SECOND ON. The log reads ON, ON, OFF and the first run
//     has no duration at all.
//   * Reboot just after a run -> the ON is orphaned permanently, because nothing
//     ever re-examines it.
// Runs once, as soon as the clock is valid and we have a real reading.
//
// The OFF timestamp is RECOVERED, not guessed. The history ring is restored from
// flash at boot (loadHistory), so it still holds the samples from before the
// reset: the last one at or above AS_ENG_OFF_V is the last moment the alternator
// was charging, which dates the shutdown to within one sample interval. Only when
// the ring cannot answer does this fall back to a bound, and the event is flagged
// RUN_F_RECON either way so a reconstructed duration is never mistaken for a
// measured one.
void reconcileOpenRun() {
  g_runRecDone = true;                     // one attempt per boot unless we bail below

  // Most recent ON or OFF, newest-first, across both generations.
  uint32_t onTs = 0; bool open = false; bool found = false;
  auto scan = [&](const char* path) {
    if (found || !LittleFS.exists(path)) return;
    File f = LittleFS.open(path, FILE_READ);
    if (!f) return;
    long n = (f.size() >= 8) ? (long)((f.size() - 8) / sizeof(RunEvent)) : 0;
    for (long i = n - 1; i >= 0 && i >= n - 64 && !found; i--) {
      RunEvent e;
      f.seek(8 + i * sizeof(RunEvent));
      if (f.read((uint8_t*)&e, sizeof(RunEvent)) != (int)sizeof(RunEvent)) break;
      if (e.kind == RUN_ON)  { onTs = e.ts; open = true;  found = true; }
      if (e.kind == RUN_OFF) {              open = false; found = true; }
    }
    f.close();
  };
  scan(RUN_FILE); scan(RUN_OLD);
  if (!open || !onTs) return;              // nothing open -- normal case, done

  float v = g_lastV;
  uint32_t nowS = (uint32_t)time(nullptr);

  // Still charging: adopt the open run instead of logging a duplicate ON. Guarded
  // on plausibility -- an ON from days ago is a leftover of the old bug, not a
  // drive still in progress, and adopting it would report a multi-day run.
  if (v >= AS_ALT_V) {
    if (nowS > onTs && nowS - onTs <= RUN_MAX_PLAUSIBLE_S) {
      engRunning  = true;
      engOnMs     = millis() - (nowS - onTs) * 1000UL;   // so dur_s stays right
      g_lastRunTs = onTs;
      logLine("boot: engine still running, adopted the open run from %lus ago",
              (unsigned long)(nowS - onTs));
      return;
    }
    // Implausibly old AND charging now: close the stale one, let the live
    // detector open a fresh run for what is actually happening.
  } else if (v >= AS_ENG_OFF_V) {
    g_runRecDone = false;                  // in the dead band -- ask again next pass
    return;
  }

  // Date the shutdown from the ring: the end of the last STRETCH of charging
  // samples, scanning newest-first.
  //
  // Not simply the newest sample above the threshold. recordSample() stores one
  // instantaneous 250 ms reading per minute, so the ring faithfully captures
  // brief excursions the engine had nothing to do with -- on 2026-08-19 a pair of
  // samples read 13.65/13.14 V seven minutes AFTER shutdown, and taking the
  // newest would have dated this run 7 minutes late. Requiring the same
  // persistence the live detector requires rejects them: a real drive holds the
  // threshold for its whole length, a blip does not.
  uint32_t offTs = 0;
  if (hist && histCount > 0) {
    int idx = (histHead - 1 + HIST_N) % HIST_N;
    uint32_t oldestTs = 0;
    int      consec   = 0;
    uint32_t candEnd  = 0;                                   // newest ts of the current stretch
    for (int k = 0; k < histCount; k++) {
      const Sample& sm = hist[idx];
      idx = (idx - 1 + HIST_N) % HIST_N;
      if (!sm.ts) continue;
      oldestTs = sm.ts;                                      // ends on the oldest
      if (sm.ts <= onTs) break;                              // before the run began
      if (!offTs) {
        if (sm.vbatt >= AS_ENG_OFF_V) {
          if (consec == 0) candEnd = sm.ts;
          if (++consec >= RUN_RECON_MIN_N) offTs = candEnd;
        } else { consec = 0; candEnd = 0; }
      }
    }
    // Never saw a sustained charge after the ON: it had already stopped by our
    // oldest sample, so that is the tightest bound the ring can give.
    if (!offTs && oldestTs > onTs) offTs = oldestTs;
  }
  if (!offTs || offTs < onTs) offTs = nowS;                  // no ring, no bound

  uint32_t ran = (offTs > onTs) ? (offTs - onTs) : 0;
  logLine("boot: closing a run left open by the reset -- stopped %lum ago, ran %lum",
          (unsigned long)((nowS > offTs ? nowS - offTs : 0) / 60),
          (unsigned long)(ran / 60));
  runLogAt(offTs, RUN_OFF, RSRC_EXT, v, ran, RUN_F_RECON);
  engRunning = false;

  // Same as the live OFF path: without this the long-term drain baseline never
  // arms, and the whole days-to-weeks view stays blank until the next real run.
  if (!g_ltDue) {
    g_ltDue = offTs + LT_SETTLE_S;
    prefs.putUInt("lt_due", g_ltDue);
  }
}

// Append the one pending hourly bucket. Loop core only -- same rule as the
// event log: the safety task must never touch LittleFS.
void flushDrainToFlash() {
  if (!g_drPending) return;
  g_drPending = false;
  bool fresh = !LittleFS.exists(DR_FILE);
  File f = LittleFS.open(DR_FILE, FILE_APPEND);
  if (!f) return;
  if (fresh) { uint32_t m = HAG_MAGIC, r = (uint32_t)sizeof(HourAgg);
               f.write((uint8_t*)&m, 4); f.write((uint8_t*)&r, 4); }
  f.write((uint8_t*)&g_drPend, sizeof(HourAgg));
  size_t sz = f.size();
  f.close();
  g_fsBytes += sizeof(HourAgg) + (fresh ? 8 : 0); g_fsCommits++;
  if (sz >= 8 + DR_MAX * sizeof(HourAgg)) {      // ~62 days per generation
    LittleFS.remove(DR_OLD);
    LittleFS.rename(DR_FILE, DR_OLD);
  }
}

// Append the one pending daily bucket. Loop core only.
void flushDailyToFlash() {
  if (!g_dyPending) return;
  g_dyPending = false;
  bool fresh = !LittleFS.exists(DY_FILE);
  File f = LittleFS.open(DY_FILE, FILE_APPEND);
  if (!f) return;
  if (fresh) { uint32_t m = HAG_MAGIC, r = (uint32_t)sizeof(HourAgg);
               f.write((uint8_t*)&m, 4); f.write((uint8_t*)&r, 4); }
  f.write((uint8_t*)&g_dyPend, sizeof(HourAgg));
  size_t sz = f.size();
  f.close();
  g_fsBytes += sizeof(HourAgg) + (fresh ? 8 : 0); g_fsCommits++;
  if (sz >= 8 + (size_t)DY_MAX * sizeof(HourAgg)) {
    LittleFS.remove(DY_OLD);
    LittleFS.rename(DY_FILE, DY_OLD);
  }
}

void loadDailyFromFlash() {
  if (!g_dy) return;
  g_dyN = 0;
  const char* files[2] = { DY_OLD, DY_FILE };
  for (int k = 0; k < 2; k++) {
    if (!LittleFS.exists(files[k])) continue;
    File f = LittleFS.open(files[k], FILE_READ);
    if (!f) continue;
    uint32_t magic = 0, rec = 0;
    f.read((uint8_t*)&magic, 4); f.read((uint8_t*)&rec, 4);
    if (magic == HAG_MAGIC && rec == sizeof(HourAgg)) {
      HourAgg b;
      while (f.read((uint8_t*)&b, sizeof(HourAgg)) == sizeof(HourAgg))
        if (b.ts > 1700000000UL) dyPush(b);
    }
    f.close();
  }
  if (g_dyN) logLine("daily archive restored: %d days from flash", g_dyN);
}

// Write the whole ring to `path` in the current format. Used by the legacy
// migration -- and, per the 4.39 lesson, the source is only removed AFTER this
// has succeeded.
static int seedHourlyFile(const char* path) {
  if (!g_dr || g_drN <= 0) return 0;
  LittleFS.remove(path);
  File f = LittleFS.open(path, FILE_WRITE);
  if (!f) return 0;
  uint32_t m = HAG_MAGIC, r = (uint32_t)sizeof(HourAgg);
  f.write((uint8_t*)&m, 4); f.write((uint8_t*)&r, 4);
  for (int i = 0; i < g_drN; i++) f.write((uint8_t*)&g_dr[i], sizeof(HourAgg));
  f.close();
  g_fsBytes += 8 + sizeof(HourAgg) * g_drN; g_fsCommits++;
  return g_drN;
}

// Read one archive generation into the ring. Returns the number of LEGACY
// (pre-4.40, 12 B {ts,v,t}) records it had to convert, so the caller knows the
// file needs rewriting. A leading epoch can never equal HAG_MAGIC, so a missing
// header is an unambiguous "this is the old format".
struct LegacyHour { uint32_t ts; float v; float t; };     // 4.36-4.39 on-disk record

static int readHourlyFile(const char* path) {
  if (!g_dr || !LittleFS.exists(path)) return 0;
  File f = LittleFS.open(path, FILE_READ);
  if (!f) return 0;

  uint32_t magic = 0, rec = 0;
  f.read((uint8_t*)&magic, 4); f.read((uint8_t*)&rec, 4);
  int conv = 0;

  if (magic == HAG_MAGIC && rec == sizeof(HourAgg)) {
    size_t n = (f.size() - 8) / sizeof(HourAgg);
    size_t skip = (n > (size_t)DR_MAX) ? (n - DR_MAX) : 0;      // keep the newest
    f.seek(8 + skip * sizeof(HourAgg));
    HourAgg b;
    while (f.read((uint8_t*)&b, sizeof(HourAgg)) == sizeof(HourAgg))
      if (b.ts > 1700000000UL) drPush(b);
  } else if (magic != HAG_MAGIC) {
    size_t n = f.size() / sizeof(LegacyHour);
    size_t skip = (n > (size_t)DR_MAX) ? (n - DR_MAX) : 0;
    f.seek(skip * sizeof(LegacyHour));
    LegacyHour L;
    while (f.read((uint8_t*)&L, sizeof(LegacyHour)) == sizeof(LegacyHour)) {
      if (L.ts <= 1700000000UL || L.v < 8.0f || L.v > 16.0f) continue;
      HourAgg b; b.ts = L.ts;
      // Only voltage and temperature were ever recorded. Everything else is
      // marked absent rather than zero -- a zero RSSI would be a lie on a graph.
      for (int i = 0; i < AG_N; i++) b.mean[i] = b.mn[i] = b.mx[i] = NAN;
      b.mean[AG_VBATT] = b.mn[AG_VBATT] = b.mx[AG_VBATT] = L.v;
      b.mean[AG_TEMP]  = b.mn[AG_TEMP]  = b.mx[AG_TEMP]  = L.t;
      drPush(b); conv++;
    }
  }
  f.close();
  return conv;
}

// Restore buckets at boot. This is the point of the whole design: a reboot --
// watchdog, brownout or OTA -- must not reset the measurement.
void loadDrainFromFlash() {
  if (!g_dr) return;
  // 4.37 renamed /drain.bin to /hourly.bin and shipped without a migration, so
  // the upgrade orphaned the file and dropped whatever buckets it held. Adopt it
  // if the new name is not in use yet, otherwise just clear the stray.
  if (LittleFS.exists("/drain.bin")) {
    if (!LittleFS.exists(DR_FILE)) {
      LittleFS.rename("/drain.bin", DR_FILE);
      logLine("hourly archive: adopted pre-4.38 /drain.bin");
    } else {
      LittleFS.remove("/drain.bin");
      logLine("hourly archive: removed orphaned /drain.bin");
    }
  }

  g_drN = 0;
  int legacy = 0;
  const char* files[2] = { DR_OLD, DR_FILE };    // oldest generation first
  for (int i = 0; i < 2; i++) legacy += readHourlyFile(files[i]);

  // A legacy file was read: rewrite both generations in the current format so
  // this conversion happens exactly once. Seed first, remove only on success --
  // the 4.39 lesson. /hourly.old is dropped rather than converted; its contents
  // are already in the ring and one generation of history is enough to keep.
  if (legacy > 0 && g_drN > 0) {
    if (seedHourlyFile("/hourly.new") > 0) {
      LittleFS.remove(DR_FILE); LittleFS.remove(DR_OLD);
      LittleFS.rename("/hourly.new", DR_FILE);
      logLine("hourly archive: converted %d legacy hours to the wide format", legacy);
    } else {
      logLine("hourly archive: WIDE CONVERSION FAILED, keeping the legacy file");
    }
  }
  if (g_drN) logLine("hourly archive restored: %d hours from flash", g_drN);
}

// A run ends the current park, but it does NOT invalidate the archive: the fit
// already skips everything before g_lastRunTs + DR_SETTLE_S, so old buckets are
// harmless to the estimate and are the only long-term record this board keeps.
// Only the part-built hour is dropped -- it straddles the run and is meaningless.
void resetDrainBuckets(const char* why) {
  agReset(); g_drHour = 0;
  g_drPending = false;
  g_hfit = {false, 0, 0, 0, 0, 0};
  logLine("hourly bucket in progress discarded (%s); %d archived hours kept", why, g_drN);
}

void flushLogToFlash() {
  if (g_logSeq == g_logPersistedSeq) return;         // nothing pending (unlocked read, benign)
  static char pend[16][LOG_LEN];                      // loop-only -> static is safe, keeps it off the stack
  int np = 0;
  portENTER_CRITICAL(&g_logMux);
  uint32_t behind = g_logSeq - g_logPersistedSeq;
  if (behind && g_log) {
    if (behind > 16) { g_logPersistedSeq = g_logSeq - 16; behind = 16; }  // fell behind: keep newest 16
    int idx = (g_logHead - (int)behind + LOG_LINES) % LOG_LINES;
    for (uint32_t k = 0; k < behind; k++) {
      strncpy(pend[np++], g_log[idx], LOG_LEN); idx = (idx + 1) % LOG_LINES;
    }
    g_logPersistedSeq = g_logSeq;
  }
  portEXIT_CRITICAL(&g_logMux);
  if (!np) return;

  File f = LittleFS.open(LOG_FILE, FILE_APPEND);
  if (!f) return;
  for (int k = 0; k < np; k++) { f.print(pend[k]); f.print('\n'); }
  size_t sz = f.size();
  f.close();
  if (sz >= LOG_FILE_CAP) {                    // keep exactly one prior generation
    LittleFS.remove(LOG_OLD);
    LittleFS.rename(LOG_FILE, LOG_OLD);
  }
}

// Replay the persisted tail (old generation first, then current) into the ring
// so /logtext shows history from before the reboot. Only the newest LOG_LINES
// survive the ring -- a naturally bounded tail. Everything read is already on
// flash, so the persist cursor is set caught-up.
void loadLogFromFlash() {
  const char* files[2] = { LOG_OLD, LOG_FILE };
  for (int i = 0; i < 2; i++) {
    if (!LittleFS.exists(files[i])) continue;
    File f = LittleFS.open(files[i], FILE_READ);
    if (!f) continue;
    while (f.available()) {
      String ln = f.readStringUntil('\n');
      ln.trim();                                // drop a trailing \r if present
      if (ln.length()) logRingPush(ln.c_str());
    }
    f.close();
  }
  portENTER_CRITICAL(&g_logMux);
  g_logSeq = g_logCount; g_logPersistedSeq = g_logSeq;   // loaded lines are already on flash
  portEXIT_CRITICAL(&g_logMux);
}

// Append a start event and flush it to flash right away. Called for BOTH the
// automatic trigger and a manual dashboard press, so the log answers "when did
// this car get started, and what started it".
// Returns the ring index it was written to, so the caller can patch in the
// verification result once we know whether the engine actually caught.
int recordStart(float v, uint8_t src, bool ok) {
  StartEvent e;
  e.ts    = timeIsValid() ? (uint32_t)time(nullptr) : 0;
  e.up_s  = millis() / 1000;
  e.vbatt = v;
  e.src   = src;
  e.ok    = ok ? 1 : 0;
  e.ver   = 0;                                  // pending
  e._pad  = 0;
  int idx = g_startHead;
  g_starts[idx] = e;
  g_startHead = (g_startHead + 1) % START_N;
  if (g_startCount < START_N) g_startCount++;
  saveStarts();                                 // write through -- don't risk losing it
  if (src == 2)                                 // fw 4.78: this used to print as "manual"
    logLine("ENGINE START (external: key or FOB) at %.2f V", v);
  else
    logLine("ENGINE START (%s) at %.2f V, tx=%s",
            src ? "manual" : "AUTO", v, ok ? "ok" : "FAILED");
  return idx;
}

// Begin watching for the alternator to come up, which is the only real proof
// the engine caught. Used for manual presses too -- it answers "did that work?"
// Only an AUTOMATIC start counts toward the lockout: a manual test press (on
// the bench, or with the battery out) must never latch the automatic system off.
void beginVerify(int idx, bool isAuto) {
  g_pendingIdx = idx;
  g_verifying  = true;
  g_verifyAuto = isAuto;
  g_verifyMs   = millis();
}

// ---------- low-voltage auto-start ----------

// Seconds left in the post-start cooldown (0 = clear). Prefers wall-clock so
// the cooldown SURVIVES A REBOOT -- otherwise a brownout right after a start
// would clear it and let the car re-fire immediately.
// The gap that applies right now. g_asFails is non-zero exactly when the last
// automatic start produced no charging (it is reset the moment one verifies), so
// it is the signal for "that attempt did not work, retry sooner".
uint32_t autoStartGapS() { return g_asFails > 0 ? g_as_retry : g_as_cool; }

uint32_t autoStartCooldownLeft() {
  uint32_t gap = autoStartGapS();
  if (timeIsValid() && g_lastStartTs > 0) {
    uint32_t nowTs = (uint32_t)time(nullptr);
    if (nowTs < g_lastStartTs) return 0;        // clock stepped backwards; don't wedge
    uint32_t el = nowTs - g_lastStartTs;
    return (el >= gap) ? 0 : (gap - el);
  }
  if (g_lastStartMs == 0) return 0;
  uint32_t el = (millis() - g_lastStartMs) / 1000;
  return (el >= gap) ? 0 : (gap - el);
}
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
void loop() {
  esp_task_wdt_reset();                            // loop serviced a pass -> healthy
  if (apMode) dnsServer.processNextRequest();
  loopMark("http");   server.handleClient();       // top suspect: a slow client on a weak link
  if (SNMP_ENABLED) { loopMark("snmp"); snmp.poll(); }
  // All filesystem writes are suspended while an OTA is streaming: Update.write()
  // erases with the cache off, and a second flash user at that moment is how the
  // interrupt watchdog reset the board mid-upload.
  if (!g_otaActive) {
    loopMark("logflush"); flushLogToFlash();        // persist any new event-log lines (idle-cheap)
    flushDrainToFlash();                            // and the hourly drain bucket, if one completed
    flushRunsToFlash();                             // and any engine start/stop events
    fixRunStartOnFlash();                           // fw 4.78: re-date a start the ECU dated earlier
    flushObdLogToFlash();                           // and any OBD log rows
    flushDailyToFlash();                            // and the daily bucket, at midnight
    // (fw 4.76: no idle auto-off -- the Bluetooth stack stays up from boot.)
    obdEngineMaybeStart();                          // a running engine gets the OBD link, page or no page
    if (!g_runRecDone && timeIsValid() && g_lastV > 5.0f) reconcileOpenRun();
  }
  loopMark("loop");
  uint32_t now = millis();

  if (DISPLAY_ENABLED) {
    bool t = ts.touched();
    if (t && !dispTouchPrev) {                     // tap toggles voltage <-> temperature
      dispMode = 1 - dispMode;
      dispDrawStatic();
      dispDrawValue(readBatteryVolts(), temperatureRead());
    }
    dispTouchPrev = t;
    if (now - lastDisp >= 400) { lastDisp = now; dispDrawValue(readBatteryVolts(), temperatureRead()); }
  }

  applyPendingWifi();                              // pending credential switch (safe: reverts on failure)

  if (!apMode) {                                   // configurable downtime -> AP
    if (WiFi.status() == WL_CONNECTED) downSince = 0;
    else { if (downSince == 0) downSince = now;
           else if (now - downSince >= g_ap_after_s * 1000UL) { startAP(); lastApRetry = now; } }
  } else if (now - lastApRetry >= g_ap_retry_s * 1000UL) {
    // In AP mode: periodically try to get back onto the home network. Runs the
    // AP and STA together during the attempt so anyone connected to the
    // fallback AP isn't kicked off just because the retry failed.
    lastApRetry = now;
    Serial.printf("AP mode: retrying home WiFi '%s'...\n", g_sta_ssid.c_str());
    loopMark("wifi-ap-retry");                     // driver calls below can block if the stack wedges
    WiFi.mode(WIFI_AP_STA);
    applyWifiRangeProfile();                     // re-assert proto + TX on the retry
    WiFi.begin(g_sta_ssid.c_str(), g_sta_pass.c_str());
    uint32_t t0 = millis();
    while (WiFi.status() != WL_CONNECTED && millis() - t0 < g_ap_wait_s * 1000UL) {
      server.handleClient();                       // stay responsive while waiting
      esp_task_wdt_reset();                         // legit retry -- don't let the WDT trip
      delay(100);
    }
    if (WiFi.status() == WL_CONNECTED) {
      loopMark("wifi-rejoin");                    // teardown mode-flips below can also block
      dnsServer.stop();
      WiFi.softAPdisconnect(true);                 // tear the AP down, back to plain STA
      WiFi.mode(WIFI_STA);
      applyWifiRangeProfile();                     // re-assert 11b + max TX after the mode flip
      WiFi.setSleep(g_wifi_ps);                    // re-apply the persisted power-save
      apMode    = false;
      downSince = 0;
      if (MDNS.begin(g_hostname.c_str())) MDNS.addService("http", "tcp", 80);
      syncTimeNow();
      Serial.printf("rejoined '%s' as %s - AP torn down\n",
                    g_sta_ssid.c_str(), WiFi.localIP().toString().c_str());
      logLine("WiFi rejoined home as %s (AP torn down)", WiFi.localIP().toString().c_str());
    } else {
      WiFi.mode(WIFI_AP);                          // give up for now; AP-only draws less
      Serial.println("home WiFi still unavailable; staying in AP mode");
    }
  }

  // NTP time: only meaningful with a live STA connection.
  if (!apMode && WiFi.status() == WL_CONNECTED) {
    if (!g_timeSynced) {
      // Not synced yet -- retry every 30 s after the boot kick until the
      // clock reads a plausible year.
      if (timeIsValid()) {
        g_timeSynced = true;
        Serial.printf("NTP synced: %lu\n", (unsigned long)time(nullptr));
      } else if (now - lastNtpSyncMs >= 30000) {
        syncTimeNow();
      }
    } else if (now - lastNtpSyncMs >= NTP_RESYNC_MS) {
      syncTimeNow();                               // periodic re-sync (drift)
      Serial.println("NTP re-sync (6h)");
    }
  }

  // Sampling + the low-voltage auto-start decision now run in safetyTaskFn on
  // core 0, so a WiFi/HTTP stall in this loop can no longer starve them. The loop
  // keeps history persistence, the LED, CPU-load sampling, and the heartbeat.
  // History is no longer snapshotted on a timer -- flushSamplesToFlash() writes
  // a batch only when one is ready, which is ~48 times a day instead of 144
  // rewrites of the entire ring. SAVE_MS is now only a backstop so a partly-full
  // batch still reaches flash if sampling stops for some reason.
  if (!g_otaActive) flushSamplesToFlash();           // no filesystem writes mid-OTA
  if (now - lastSave >= SAVE_MS) { lastSave = now; if (g_sbN) g_sbFlush = true; }
  if (now - lastPrint >= 2000) {
    lastPrint = now;
    float v = g_lastV;         // sampled by the safety task (ADC owner)
    updateLed(v);
    sampleCpuLoad();           // per-core utilisation over the last 2 s
    Serial.printf("Vbatt=%6.2f V  temp=%4.1f C  heap=%uKB  disk=%uKB  samples=%d  %s\n",
                  v, g_lastTemp, (unsigned)(ESP.getFreeHeap() / 1024),
                  (unsigned)(LittleFS.usedBytes() / 1024), histCount, apMode ? "[AP]" : "[STA]");
  }
}
