SixOfFive/2009_kia_spectra/(commit log)

2026-05-23 Initial scaffolding: docs, BOM, architecture, SDR plan
    Sets up the project structure for the voltage-triggered remote start
    on a 2009 Kia Spectra:
    - README with high-level architecture diagram
    - docs/BOM.md — finalized parts list, two units, ~$478 CAD total
    - docs/architecture.md — ESP32/Pi division of labor, power, sleep states
    - docs/compustar-research.md — what we know about the installed Compustar
    system and the plan to synthesize Keeloq RF packets
    - esp32/ and pi/ stubs with planned module layouts
    - sdr/ with the capture + URH analysis workflow
    - .gitignore covering Python, MicroPython, SDR capture artifacts, secrets
    No code yet — awaiting parts delivery.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
2026-05-23 Scope to single-unit; add daily log for 2026-05-23
    - README and BOM now describe ONE unit so the repo is directly
    reproducible by anyone wanting to copy the build (was previously
    written as a "two-unit" reference)
    - Add logs/ directory with 2026-05-23 daily journal entry covering
    the architecture decisions, OBD-II-only connection, Compustar
    Keeloq-synthesis plan, and project rules established this session
    - Fix .gitignore that was excluding all of logs/ — only application
    *.log files should be ignored, not the daily journal markdown
2026-05-23 Log shopping run results in 2026-05-23 journal
    Dispatched 4 parallel browser-MCP agents + 3 follow-up agents to shop
    the BOM across Amazon.ca and AliExpress. Final cart totals:
    - Amazon.ca: ~$555.45 CAD
    - AliExpress: ~$121.60 CAD
    - Grand total: ~$677 CAD for two units + missing tools
    Key shopping decisions documented: SD card upgrade rationale, AliExpress
    wins on ESP32/buck converter/MOSFETs, USB cable skip due to integrated
    USB-A on chosen display, and the note about cart audit needed before
    checkout since 6 agents touched the carts.
2026-05-24 Log final shopping outcome and lessons learned
    Order placed. User took over manually after agents had cart-state
    visibility issues and a couple of long-running ones crashed mid-task.
    Documenting the lessons for future agent-driven shopping sessions:
    quantity-decrement gotchas, Asurion modal handling, AliExpress
    new-tab pattern, find-tool context costs.
2026-05-24 Warn about AliExpress ESP32-WROOM-32U bait-variant scam
    User caught a variant-selector trap on the AliExpress listing the
    shopping agent kept choosing: the "$3 ESP32-WROOM-32U DevKitC" default
    variant actually ships only the bundled 2.4 GHz antenna, not the board.
    The real board variant is buried in the dropdown at $8-12.
    Adds a buyer warning section to docs/BOM.md so anyone copying this
    build doesn't fall for the same listing pattern. Adds a lesson-learned
    note to today's session log linking to the warning.
2026-05-24 Add KeeLoq cipher (esp32/src/lib/keeloq.py) with passing tests
    Pure-Python implementation of the 32-bit/64-bit/528-round KeeLoq block
    cipher used by HCS3xx remote keyless entry encoders. Runs unchanged in
    both CPython 3.x (for desktop testing) and MicroPython on ESP32 (for
    deployment).
    Tests verify:
    - Fixed point: encrypt(0, 0) = 0 (known degenerate property)
    - Deterministic output
    - Round-trip: decrypt(encrypt(p, k), k) == p for various inputs
    - Input masking: oversized inputs get clipped instead of crashing
    Notes on "published" test vectors: several vectors floating around
    online don't reproduce in any implementation I could verify against,
    and they appear to come from non-standard varia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
    [test_keeloq.py]
2026-05-24 Add Compustar HCS packet builder + PWM pulse generator
    esp32/src/lib/compustar.py wraps the keeloq cipher to produce the full
    66-bit HCS300/301/361 transmission packet (32-bit hopping code + 28-bit
    serial + 4-bit function + 2-bit status). Also generates the (high_us,
    low_us) pulse-pair list for driving a CC1101 in OOK mode.
    Function codes, TE timing, preamble length, and header gap are all
    PLACEHOLDERS to be confirmed against real SDR captures of the 1WSHR-PRO
    FOB. Documented inline.
    Tests verify packet structure, status flag packing, input masking, and
    PWM encoding sanity. All 6 pass.
2026-05-24 Add OBD-II PID query/response module + tests
    esp32/src/lib/obd2.py implements single-frame ISO 15765-4 PID requests
    and response parsing. Covers the 14 most useful standard mode 01 PIDs
    for a 2009 Kia Spectra: RPM, speed, coolant/intake/ambient temp,
    engine load, MAF, throttle position, fuel level, control module
    voltage, run time, distance traveled (with MIL / since clear),
    intake manifold pressure.
    PIDS dict structure: pid -> (name, byte_count, scale_function, units)
    making it trivial to add more later. Parser returns name/value/units
    for known PIDs and raw bytes for unknown ones.
    9 tests pass, including realistic CAN frame examples (1726 rpm,
    80 km/h, 55C coolant, 14.0V) verified agains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
2026-05-24 Add UART link protocol between ESP32 and Pi (both sides + tests)
    Line-delimited JSON over UART at 115200 baud. Symmetric encoder/decoder
    on both ends so either side can send any message type.
    esp32/src/lib/pi_link.py — MicroPython side, with UartLink helper that
    wraps machine.UART and buffers partial reads until a full \n line arrives.
    pi/app/comms/esp32_link.py — Pi side, mirrors the schema and provides
    Esp32Link wrapping pyserial. Accepts a file-like object instead of a
    serial port for tests so unit tests run without hardware.
    Message types: STATUS, OBD, EVENT, COMMAND, ACK, LOG. Constants for
    command names and event names defined identically in both modules to
    prevent drift; the cr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
    [esp32_link.py]
2026-05-24 Add config + secrets templates for ESP32 and Pi
    esp32/src/config.py — non-secret tunables: voltage thresholds, run
    duration, RF frequency / TE / burst settings, UART pins, CAN pins,
    OBD-II poll list, reporting cadence, deep-sleep interval.
    esp32/src/secrets.py.example — template for WIFI_SSID/PASSWORD,
    MQTT_BROKER/credentials, COMPUSTAR_DEVICE_KEY/SERIAL/COUNTER. Copy
    to secrets.py (gitignored) before deploying.
    pi/app/config.py — UART port, Flask bind host/port, dashboard poll
    rate, OBD history size, state/log directories, MQTT enable flag.
    pi/app/secrets.py.example — WiFi (optional, usually configured via
    raspi-config instead) + MQTT credentials.
    config.secrets_ready() / config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
2026-05-24 Add Flask dashboard skeleton (server + HTML + CSS + JS)
    pi/app/display/server.py — Flask app with three routes:
    GET / dashboard.html
    GET /api/state current STATE dict as JSON (browser polls 1Hz)
    POST /api/command trigger start/stop/ping (queued for ESP32 forwarding)
    dashboard.html — 6 gauges (battery V large + RPM, speed, coolant,
    throttle, fuel small), 3 buttons (start/stop/ping), 3 status pills
    (engine state, ESP32 state, WiFi RSSI), updated-at and uptime in
    the footer.
    main.css — dark theme tuned for 800x480 in a dimly-lit car cabin.
    Grid layout for gauges, big tabular numbers, color-coded engine/start/
    stop. -webkit-user-select disabled to prevent accident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
2026-05-24 Log evening code sprint — first 5 modules + tests + dashboard
    Summarizes today's late-night work after the order was placed:
    25 passing tests across keeloq cipher, HCS66 packet builder, OBD-II
    PID parser, and the symmetric UART JSON protocol between ESP32 and
    Pi. Plus the Flask dashboard skeleton with mocked state.
    Lists what's confirmed in pure software vs what remains placeholder
    until we have SDR captures or actual hardware to verify against.
2026-05-24 Add detailed SDR reproduction walkthrough (7 numbered docs + top-level index)
    docs/reproduce.md — master TOC for reproducing the entire build,
    phase-by-phase. SDR section now fully populated; later phases (bench
    prototype, in-car install, polish) listed as WIP placeholders that
    get filled in as we get to them.
    Replaces the old monolithic sdr/README.md with a navigational version
    plus 7 focused step files:
    01-software-setup.md — install rtl-sdr drivers (Zadig on Windows),
    URH, on all three OSes
    02-hardware-verification.md — confirm the dongle works end-to-end via
    FM broadcast reception + 433 MHz baseline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
2026-05-24 Add braindump.md — full context-preservation document
    Comprehensive single-file dump of everything I know about this project,
    written immediately before conversation compaction so future sessions
    can pick up without losing context.
    Covers: project goal, car details + existing Compustar system,
    hardware architecture (hybrid ESP32+Pi), order contents (Amazon +
    AliExpress), repo structure, every code module written today with
    test counts, project memory rules, SDR/Keeloq plan, known gotchas,
    user preferences, decisions-made-and-why (so they don't get
    re-litigated), next-session priority list, recent git history,
    and an explicit do/don't list for the next Claude.
    Particularly important to pr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
2026-05-24 Add SDR helper scripts so the walkthrough is executable end-to-end
    Four pure-stdlib Python helpers, each one referenced by the numbered
    walkthrough docs but previously only described in prose:
    - plot-power-csv.py — aggregate an rtl_power CSV, report top peaks
    - diff-bits.py — compare two .bits files, group differing positions into
    contiguous runs (so the hopping-code region jumps out visually)
    - try-mfkeys.py — for each (mfr_key, derivation_type) in a Flipper-style
    keystore, derive a candidate device key from your serial and decrypt
    one captured hopping code; report any plausible plaintexts
    - validate-key.py — decrypt N captures with a candidate device key,
    check the discrim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
2026-05-24 Add ESP32 hardware drivers (cc1101, ads1115, twai_can) + tests
    - cc1101.py: SPI driver for the TI CC1101 sub-GHz transceiver. Configured
    for 433.92 MHz async OOK mode where we bit-bang GDO0 with the PWM-encoded
    pulse sequence from compustar.packet_to_pulses. GC is disabled during
    transmit so a collect cycle can't stretch a low-pulse and break the
    receiver's PWM window. At TE=400µs the per-bit timing has comfortable
    MicroPython overhead headroom. (For TE<50µs we'd need esp32.RMT instead.)
    - ads1115.py: I2C driver for the 16-bit ADC, single-shot single-ended read
    with selectable PGA. Includes raw_to_volts helper and two's-complement
    decode. Sized for the 30k/10k battery divider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
2026-05-24 Add ESP32 state machine (controller.py + main.py boot entrypoint)
    States: MONITORING -> STARTING -> RUNNING -> STOPPING -> COOLDOWN -> MONITORING.
    - MONITORING: sample battery V every WAKE_INTERVAL_S, accumulate sustained
    low-V streak; trigger when streak >= LOW_V_SUSTAIN_S
    - STARTING: power-on Pi via active-low P-MOSFET, transmit Compustar Start RF
    - RUNNING: poll OBD-II PIDs at OBD_POLL_INTERVAL_S, broadcast to Pi via UART;
    exit when RUN_DURATION_S elapses (or Pi sends stop_engine)
    - STOPPING: transmit Stop RF, send shutdown_pi command, wait
    PI_SHUTDOWN_GRACE_S, then cut Pi MOSFET
    - COOLDOWN: refuse new triggers for START_COOLDOWN_S (prevents thrash)
    Persistent state: Compustar rol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
    [controller.py, main.py, test_controller.py]
2026-05-24 Add Pi daemon (UART listener + MQTT publisher + Flask) and provisioning
    Single-process design: Flask main thread + uart-listener daemon thread +
    mqtt-publisher daemon thread all share STATE in pi/app/state.py. No IPC
    needed; the lock around STATE serializes writes.
    Components:
    - pi/app/state.py: thread-safe STATE dict with update_state/update_obd/
    append_event helpers and a snapshot() that returns a JSON-safe shallow
    copy. ESP32_LINK module-level slot so Flask handlers can forward
    commands without plumbing the link through every call.
    - pi/app/comms/uart_listener.py: reads messages from the ESP32 link in a
    daemon thread, dispatches each into STATE. STATUS -> v_battery + esp32
    st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
2026-05-24 Log: SDR scripts, ESP32 drivers + state machine, Pi daemon
    Capture today's late-evening continuation push that completed all
    hardware-dependent code from braindump section 11:
    - SDR helper scripts (plot-power-csv, diff-bits, try-mfkeys, validate-key)
    - ESP32 drivers (cc1101, ads1115, twai_can)
    - ESP32 controller state machine (monitor -> start -> run -> stop -> cooldown)
    - Pi daemon (state module + uart listener + mqtt publisher + Flask wired up)
    - systemd unit + provision.sh
    Test totals stand at 57 across the project, all green.
2026-05-24 Add deep-sleep + RTC-memory streak persistence for MONITORING
    The ESP32's whole job in MONITORING is to draw as little current as
    possible for as long as possible. Without deep sleep we sit at ~80 mA
    constantly which drains a car battery in days. With deep sleep we drop
    to <10 µA between samples.
    Implementation:
    - esp32/src/lib/persistence.py: RTC memory helpers. Stores a small
    8-byte blob containing magic("VRM2") + uint16 low_v_count + 2 padding
    bytes. RTC memory survives deep sleep (not power loss); fresh boot
    starts with count=0 which is the right behavior.
    - esp32/src/controller.py:
    - low_v_streak_start (timestamp) replaced with low_v_count (samples).
    time.time() resets t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
    [controller.py, test_controller.py, test_persistence.py]
2026-05-24 Add Phase 2 reproduction docs: bench prototype (steps 08-12)
    Five new docs that walk anyone reproducing the build from "fresh-out-of-
    box ESP32 and Pi" to "synthesized Keeloq Lock cycle accepted by the car":
    - 08-flash-micropython.md: Thonny + esptool flash, COM port + driver
    notes for cheap clone boards, CAN-availability check
    - 09-bench-smoke-tests.md: five quick per-module tests in isolation
    (blink, WiFi scan, ADS1115 I2C, CC1101 SPI + part-ID + first OOK
    burst, SN65HVD230 CAN loopback). Includes pin maps and a
    troubleshooting matrix.
    - 10-pi-setup.md: Imager settings, first-boot SSH, provision.sh run,
    secrets.py config, systemd service start, chromium kiosk verification
    on t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
2026-05-24 Add GitHub Actions CI + end-to-end integration tests
    CI:
    - .github/workflows/tests.yml runs all unit tests across Python 3.10,
    3.11, 3.12 on every push to main and every PR. Also smoke-tests Flask
    routes after install. Flask is the only third-party dep needed for the
    test suite (paho-mqtt is no-op'd cleanly when missing).
    Integration tests (esp32/tests/test_integration.py):
    - FakeUartPort + make_pair() builds an in-memory bidirectional pipe
    with two endpoints, one for each side of the link
    - Wraps one end in the ESP32-side pi_link.UartLink, the other in the
    Pi-side esp32_link.Esp32Link
    - Drives the controller through realistic scenarios:
    * MONITORING sample → STATUS message de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
    [test_integration.py]
2026-05-24 Refresh top-level docs to reflect actual current state
    After the production-hardening push, the prior README/braindump claims
    were significantly understating what exists. This commit aligns them.
    - README.md: rewrote build-status (74 tests passing, CI on every push,
    all hardware-independent firmware done, awaiting parts), updated
    repo-layout table, swapped the diagram detail (deep sleep <10µA
    callout, JSON line protocol annotated), pointed reproduce path at
    the new docs/08-12.
    - docs/architecture.md: replaced the "to be designed in the firmware
    phase" stub on UART protocol with the actual details (line-delimited
    JSON, six message types, symmetric pi_link.py + esp32_link.py,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
2026-05-24 Add hardware watchdog, dashboard events panel, mpremote install scripts
    Three small additions to round out the production surface:
    1. Hardware watchdog (esp32/src/controller.py + config.py):
    - WDT_ENABLED / WDT_TIMEOUT_MS in config (default on, 120s timeout)
    - controller._init_wdt() constructs machine.WDT in MicroPython,
    returns None in CPython
    - controller.tick() calls _feed_wdt() at the top of every tick
    - Timeout is 2 minutes — comfortably exceeds the default 60s
    WAKE_INTERVAL_S so deep sleep doesn't trip it
    - 2 new controller tests (wdt-is-None in CPython, feed called per tick)
    2. Dashboard recent-events panel:
    - dashboard.html: <section class="events"> wi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
    [config.py, controller.py, test_controller.py]
2026-05-24 Add simulator, MQTT command subscriber, power budget analysis
    Three additive features that bring closure to several earlier hand-waves.
    1. esp32/scripts/simulate.py — CPython driver that runs the
    VroomController through scripted scenarios with mocked hardware:
    - low_voltage: drop battery, watch sustained-low samples accumulate,
    trigger, run, stop, cooldown — full state-machine playthrough
    - manual: Pi sends start_engine + ping + set_threshold, watch dispatch
    - long_idle: alternating low/high voltage, confirm no spurious trigger
    Every emitted UART message is printed in human-readable form. ASCII-only
    (Windows cp1252 console can't handle box-drawing).
    2. MQTT comma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
2026-05-24 Add tools/preflight.py — fast config + secrets + import sanity check
    Run from your dev machine before flashing the ESP32 or deploying the Pi.
    Catches missing secrets, sketchy threshold values, broken imports, and
    absent optional deps in <2s.
    Checks per side:
    esp32: config threshold ranges (LOW_V_TRIGGER, sustain, run duration,
    wake interval, cooldown, TE, burst repeats), secrets file
    presence + secrets_ready(), placeholder-value sniffing on
    Compustar device key/serial, all firmware module imports
    pi: config presence, secrets file presence, MQTT broker config,
    all daemon module imports, flask installed (required), paho-mqtt
    installed (opt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
2026-05-24 Add docs/day-one.md - cheat sheet for parts-arrival day
    When the boxes show up you don't want to re-derive the install order from
    twelve docs. This page combines:
    - Pre-flight checklist (tools/preflight.py, Thonny, mpremote, FOB battery)
    - Per-module triage table (visual + multimeter check as you unbox each
    thing, with pass criteria — especially the AliExpress ESP32 antenna-only
    scam check and the OBD-II pigtail male-vs-female check)
    - Ordered operating sequence for Days 1-3 with deep links to docs/08-12
    and sdr/01-07
    - Common-failure troubleshooting section (FOB frequency mismatch, Flipper
    DB miss, counter desync, immobilizer bypass)
    - Safety reminders (valet switch location, sec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
2026-05-24 Add dashboard toast notifications + SECURITY.md threat model
    Dashboard:
    - Replaces the modal alert() on command failure with a slide-up toast at
    the bottom of the screen (cleaner on touchscreen, doesn't block the
    rest of the UI). Color-coded: green for success, red for failure.
    Fade in/out at 2.5s. Pulls the server's error string when available
    ("esp32 link not initialized" etc.) instead of just "HTTP 503".
    SECURITY.md:
    - Documents what's in the repo (code, docs, KeeLoq cipher impl) vs
    gitignored (secrets.py with device key + WiFi + MQTT creds, raw IQ
    captures)
    - Threat model: what an attacker physically near the car can already
    do (SDR capture/replay/rollback) vs what this pr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
2026-05-24 README + log: capture the 12-commit production-hardening day
    Test totals 85, feature set current, day-one.md linked from build-status.
    The daily log catches the final-polish round (day-one cheat sheet,
    dashboard toast notifications, SECURITY.md threat model).
2026-05-24 Fix sdr/01: osmocom GitHub mirror has no releases — point at real sources
    User reported the link to https://github.com/osmocom/rtl-sdr/releases
    showed "There aren't any releases here." Confirmed via web fetch: the
    osmocom GitHub mirror does NOT publish releases.
    Replaced with two working sources:
    1. Official osmocom FTP at https://ftp.osmocom.org/binaries/windows/rtl-sdr/
    (regularly updated; today's date shows 20260524.zip builds present)
    2. RTL-SDR Blog fork releases on GitHub
    (https://github.com/rtlsdrblog/rtl-sdr-blog/releases — V1.3.6 is the
    latest signed release; works fine with generic R820T2 dongles like
    the Vomeko one this project uses)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
2026-05-24 Document Python 3.13+ URH install gotcha
    User hit "You need Cython to build URH's extensions" running pip install
    urh on Python 3.14. URH 2.10 publishes prebuilt wheels for 3.10-3.12
    only; on newer Python pip falls back to a source build that needs both
    Cython and a Microsoft Visual C++ compiler. Easier path is to install
    Python 3.12 alongside (NOT replacing) the existing Python and target it
    via `py -3.12 -m pip install urh` / `py -3.12 -m urh`.
2026-05-24 Correct URH Python-version guidance: Windows wheel is 3.13 only
    Earlier commit recommended Python 3.12 — wrong. Checked PyPI directly:
    urh 2.10.0 has exactly one Windows wheel, cp313-win_amd64. Python 3.10,
    3.11, 3.12, and 3.14 all fall back to source build on Windows and fail.
    Fixed to point at the Python 3.13 installer and confirm the wheel name
    that gets pulled.
    Linux is unaffected — wheels available for 3.10-3.14.
2026-05-24 Document R828D tuner variant + i2c -9 USB-power troubleshooting
    User's Vomeko dongle has R828D tuner (not R820T2 as previous docs
    assumed). Both R820T2 and R828D ship in these clones depending on
    year/batch. R828D works fine but is more sensitive to USB power and
    benefits from the rtl-sdr-blog fork driver.
    Added:
    - Drop the `-t` from rtl_test in the verify step (it's an E4000-specific
    test that always errors on R820T2 / R828D and gives the misleading
    "No E4000 tuner found, aborting" message)
    - Troubleshooting section for the i2c wr failed=-9 / pipe-stall pattern:
    USB 2.0 port first, then Blog fork driver, then cable
    - Note on the two tuner variants you might see in these dongles
    Co-A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
2026-05-24 Document 250 kSps fallback for USB-3-only PCs / R828D dongles
    User confirmed R828D dongle is unstable at 2 MS/s on USB-3-only host
    (intermittent cb transfer status 4/5 errors even with a USB 2.0 hub
    between the dongle and the PC). 250 kSps streams reliably and is still
    2.5x the FOB occupied bandwidth.
    - sdr/04: added "If your dongle can't sustain 2 MS/s" section with -s
    250000 substitution guidance; capture-parameter table now lists both
    rates with a pointer
    - sdr/05: URH import sample rate matches whichever rate rtl_sdr was
    actually running at (2000000 or 250000)
2026-05-24 sdr/05: match URH sample rate to whatever rtl_sdr captured at
    Follow-up to f0bae96 which added the 250 kSps fallback in step 04 but
    missed the matching note in step 05.
2026-05-24 Split framing.md into public + local files; ignore stray counter state
    User has explicit privacy concern about FOB-identifying data leaking
    to the public repo even though the project itself is public. Took the
    device-key precedent and extended it to all per-FOB identifiers.
    - .gitignore: added sdr/analysis/framing.local.md plus *.local.md and
    *.secret.md patterns under sdr/analysis. Also added compustar_counter.json
    (a stray runtime artifact left behind when COUNTER_FILE defaults to cwd
    during tests/simulator runs that don't redirect properly).
    - sdr/analysis/framing.md: rewritten to contain ONLY the universal /
    explicitly-OK fields: packet layout (universal HCS300/301), timing
    (H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
2026-05-24 Add sdr/scripts/inspect-capture.py — pre-URH burst finder
    User had a 15-second capture file with 3 FOB presses (long-record-many-
    presses pattern, friendlier to a flaky dongle than 10 one-second files).
    Needed a quick way to confirm "yes, the file has real bursts in it"
    without firing up URH.
    inspect-capture.py reads an unsigned-8-bit IQ file in chunks, computes
    a power envelope (|I-128| + |Q-128| per sample), estimates the noise
    floor from the lower 60% of envelope values, and reports every
    contiguous run above floor + threshold (default 3 dB).
    Output on user's fob-start-001.bin: 3 strong bursts (2 seconds each,
    ~32 dB above floor) at 2.0s / 6.2s / 10.5s — clean confirmation that
    the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
2026-05-24 sdr/01: fix URH launch command — -m urh does not work
    URH is packaged as a setuptools script entry point, not a runnable
    module. py -3.13 -m urh fails with "'urh' is a package and cannot be
    directly executed". Correct invocation is the urh.exe wrapper script in
    the per-user Scripts directory.
    Documented:
    - Full-path invocation that works immediately
    - PowerShell one-liner to add the Scripts dir to PATH permanently
    - Explicit note that -m urh does not work, with the exact error message
2026-05-24 Add sdr/scripts/trim-burst.py — slice long captures into per-burst files
    User reported URH stalling indefinitely on a 7 MB / 15-second multi-press
    recording. URH does signal processing in-memory on the GUI thread; large
    multi-burst files can hang it for minutes or never recover.
    trim-burst.py reuses inspect-capture.py's burst detector to slice each
    strong burst out of a long capture as its own small .bin file, with
    configurable padding. Default: process all bursts above 15x floor (filters
    weak chatter / debounce). --burst N picks one specifically.
    User's captures trimmed cleanly:
    - 3 Start files * 3 bursts each = 9 single-burst Start files
    - 1 Lock file -> 3 single-burst Lock files
    - 1 U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
2026-05-24 Drop URH as a dependency; the project's own Python demodulator replaces it
    User decision: "one less dependency" - replace URH with sdr/scripts/demod-ook.py
    for the demodulation step. URH still works as an optional GUI alternative
    but is no longer required to make this project go end-to-end.
    New tools (all pure-stdlib Python, no third-party deps):
    - sdr/scripts/demod-ook.py: headless OOK demodulator. Reads rtl_sdr
    unsigned-8-bit IQ, computes magnitude envelope (sqrt(I^2 + Q^2)),
    low-pass filters at TE/2, AC-couples to subtract slow AGC baseline,
    applies a Schmitt trigger with adaptive thresholds derived from the
    80th-percentile peak, detects preamble + header gap, decodes 66 PWM
    b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
2026-05-24 Add consensus-bits.py + analyze-framing.py for noisy-bit analysis
    The demodulator on user's Compustar 1WSHR-PRO has ~80% per-bit accuracy
    due to (S,S) and (L,L) pair lengths within the encoding being noise-
    sensitive. To recover the real bits we majority-vote across:
    - multiple .pN.bits decoded from same press (same counter): kills noise
    - multiple presses per button: stable bits = serial+function+status
    - across multiple buttons: stable+same = serial+status, stable+different = function
    consensus-bits.py: globs .bits files and majority-votes per position,
    flagging positions below confidence threshold with '?'.
    analyze-framing.py: takes per-button glob patterns, groups by burst,
    compu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
2026-05-24 Log: end-of-day SDR progress — partial framing classification
    User did 10+ presses per button across Start/Unlock/Trunk (Lock missed,
    only 3 presses from earlier round). Ran end-to-end pipeline:
    inspect-capture -> trim-burst -> demod-ook -> consensus-bits ->
    analyze-framing.
    Findings:
    - Packet is 66 bits MSB-first
    - HOP region clearly identified (varies between presses): positions
    24-37, 58-64 mainly
    - SER region clearly identified (stable everywhere): 39 positions
    - FN (function code) not cleanly identified — Start's noisy decodes
    produce '?' at the very positions where Unlock vs Trunk show stable
    differing values. Probable function code bits: 29, 35, 36 plus one
    more we can't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
2026-05-24 demod-ook.py: add bit-clock-recovery envelope decoder (decode_bits_from_envelope)
    The pair-ratio decoder (decode_bits_from_runs) gave ~80% per-bit accuracy
    on user's Compustar 1WSHR-PRO because that FOB's encoding produces (S,S)
    and (L,L) pulse pairs that don't fit standard HCS PWM's 2:1 length ratio.
    The ratio test (hi_len < lo_len) coin-flips on those near-equal pairs.
    New approach: bit-clock recovery. For each bit's 3*TE period, sample the
    AC-coupled envelope at offset 1.5*TE (the middle of the second TE slot):
    - PWM "0" = HIGH(TE) + LOW(2*TE) -> level at 1.5*TE is LOW
    - PWM "1" = HIGH(2*TE) + LOW(TE) -> level at 1.5*TE is HIGH
    This samples the signal level directly rather than meas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
2026-05-24 PROTOCOL DISCOVERY: Compustar 1WSHR-PRO is fixed-code, not KeeLoq
    Cross-referenced rtl_433's compustar_1wg3r device decoder (covers
    1WG3R-SH and 1WAMR-1900 — same protocol family as our 1WSHR-PRO).
    Findings completely overturn the project's original assumption:
    - Modulation: OOK_PULSE_PWM with short_width=708us, long_width=1076us,
    sync_width=1448us, reset_limit=1532us
    - Bit encoding per rtl_433 PWM model: each HIGH pulse encodes one bit,
    short pulse = "0", long pulse = "1". LOW gaps ignored.
    - Packet: only 36 bits (not 66): 16-bit Remote ID + 3-bit "111" sanity +
    8-bit ~button + 8-bit button + 1-bit "0" sanity
    - Integrity: button_inverse XOR button_code == 0xFF
    - *** FIXED CODE ***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
2026-05-24 Add sdr/scripts/scan-compustar.py — brute-force packet finder
    After confirming the protocol family (rtl_433's compustar_1wg3r),
    classify every HIGH pulse in a capture as "0" (short ≈ 708us), "1"
    (long ≈ 1076us), or "X" (sync ≈ 1448us). Print the resulting symbol
    stream; scan all bit offsets for a window of 36 bits that passes the
    1WG3R protocol sanity checks.
    Empirical result on user's captures:
    - 7 packet repeats per burst, separated by sync TRIPLETS (3 X marks)
    - Between consecutive XXX = 35 bits (not 36)
    - All 7 repeats produce identical 35-bit pattern (= fixed code confirmed)
    - First 23 bits constant across all buttons (Remote ID 0x2DD6 + 0x08 header)
    - Last ~11 bits differ per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
2026-05-24 Update braindump.md with today's protocol discovery and next steps
    Replaced yesterday's braindump (which assumed KeeLoq rolling-code
    architecture) with today's findings:
    - READ-THIS-FIRST section at top: protocol is fixed-code, not KeeLoq
    - Section 2.5: full protocol discovery details (rtl_433 1WG3R family,
    708us short / 1076us long / 1448us sync, 36-bit packet, no encryption)
    - Section 3: updated repo state showing which files need rewrite
    - Section 4: numbered next steps starting with "install rtl_433 nightly
    Windows build for ground-truth validation"
    - Section 5: inventory of captures we have
    - Section 7: log of today's SDR session struggles + fixes
    - Section 8: decisions made today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
2026-05-24 sdr/analysis/framing: record rtl_433 -A ground-truth verification
    Running rtl_433 (nightly Windows build) with -A on fob-start-lg20-b1.bin
    confirms our independent decode:
    - 142 short HIGH pulses (732 us) = "0" bits
    - 144 long HIGH pulses (1100 us) = "1" bits
    - 24 sync HIGH pulses (1476 us)
    - SNR 42 dB, modulation depth clean
    Arithmetic matches our packet model: 8 packet repeats per burst,
    each = 3-sync-triplet + 35 data bits, with a 6-pulse wake-up
    preamble. Total = 6 + 8 * (3+35) = 310 pulses, matches rtl_433's
    total count exactly.
    Important correction: the FOB uses *symmetric* PWM, not HIGH-only.
    "0" = HIGH(732) + LOW(1136); "1" = HIGH(1100) + LOW(756);
    sync = HIGH(1476) + LO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
2026-05-24 firmware: replace KeeLoq path with 1WSHR-PRO fixed-code packet replay
    SDR analysis (verified via rtl_433 -A pulse analyzer) confirms the
    Compustar 1WSHR-PRO is a 1WG3R-family FIXED-CODE FOB — no KeeLoq
    encryption, no rolling counter, no device key. To replicate any
    button we just transmit its captured 35-bit pattern verbatim.
    This commit rips out the KeeLoq path that was built on the wrong
    assumption and replaces it with a much simpler capture-and-replay
    implementation.
    esp32/src/lib/compustar.py:
    - Drop build_packet / build_hopping_code / packet_to_pulses with
    TE-based PWM encoding. Replace with parse_bit_pattern,
    packet_to_pulses (symmetric PWM with HIGH+LOW per bit), and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
    [config.py, controller.py, esp32_link.py, test_compustar.py, test_controller.py, test_integration.py]
2026-05-24 logs/2026-05-24: add late-day plot twist + firmware rewrite milestone
    Captures the three big developments after the original log was written:
    1. PROTOCOL DISCOVERY — the FOB isn't KeeLoq; it's Compustar 1WG3R
    fixed-code. The ~80% demodulator accuracy was the (S,S)+(L,L)
    sync triplets being misclassified by a wrong-protocol decoder.
    All 10 Start presses produce identical bits — that's the
    fingerprint of a fixed-code protocol.
    2. rtl_433 ground-truth verification — nightly Windows build with
    the compustar_1wg3r decoder confirms our pulse measurements
    (732/1100/1476 us with symmetric PWM, 24 syncs / 8 packets per
    burst). -R 302 doesn't decode our 1WSHR-PRO sub-varia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
2026-05-24 docs: rewrite reproduction docs for Compustar fixed-code path
    Companion to the firmware rewrite in 80bef8d. The docs were still
    walking readers through KeeLoq device-key recovery and HCS66 packet
    synthesis -- which doesn't match the actual code anymore and isn't
    needed for this FOB.
    Major changes:
    docs/12-keeloq-bench-validation.md -> docs/12-bench-validation.md
    Renamed and rewritten. Now walks: populate secrets.py with the
    4 captured 35-bit patterns -> render via build_pulses_for_button
    -> SDR-cross-check the synthesized burst against the genuine FOB
    -> Lock cycle -> Unlock -> Start. No counter desync warning
    because there is no counter in fixed-code protocols.
    sd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
2026-05-24 security: scrub real FOB identifying values from committed docs + code
    Previous commits leaked real Compustar 1WSHR-PRO values into committed
    files when writing examples. Removed all of them.
    WHAT LEAKED INTO THE WORKING TREE (and was therefore pushed):
    - Real 16-bit Remote ID in 7 files: braindump.md (3 places),
    docs/12-bench-validation.md (expected REPL output),
    sdr/05-demodulation.md (example demod output line),
    esp32/tests/test_controller.py, esp32/tests/test_integration.py,
    esp32/scripts/simulate.py
    - Real button code byte (and its bitwise-NOT) in
    sdr/05-demodulation.md's example demod output
    - Real 35-bit captured Start pattern in esp32/src/lib/compustar.py'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
    [test_controller.py, test_integration.py]
2026-05-24 logs/2026-05-24: doc-cleanup round + security pass
    Append two more sections covering the rest of the day after the
    late-afternoon protocol-discovery milestone:
    1. Doc-cleanup round (commit 502f8ec): rewrote the reproduction docs
    to reflect the new fixed-code firmware path. Renamed doc 12,
    updated sdr/05 + 06 + 07, fixed cross-refs. ~700/-500 LOC.
    2. Security pass: real Remote ID + button codes + 35-bit patterns
    had leaked into committed example text. Scrubbed everything in
    6e82722 (HEAD now clean). Untracked braindump.md entirely in
    379e2b1 (it's a Claude-session artifact, not a deliverable).
    Wrote a force-push history-rewrite procedure at
    tools/scrub-history/ (gitigno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
2026-05-24 docs: align top-level + smoke-test READMEs with fixed-code path
    Quality pass catching stale references that survived 502f8ec's
    reproduction-doc rewrite:
    README.md (top-level): replace "software synthesis of the KeeLoq
    rolling-code RF signal" with the correct fixed-code framing.
    Bumped test count from 85 (stale) to 105 (81 ESP32 + 24 Pi).
    esp32/README.md: was a "not started, awaiting parts" stub.
    Replaced with the actual current module list, an accurate
    description of compustar.py (1WG3R-family fixed-code replay)
    with keeloq.py noted as the HCS-KeeLoq fallback, and a how-to-run
    the tests block.
    sdr/README.md: walkthrough description updated to reflect
    fixed-code FOB; st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
2026-05-24 cc1101: audit + align with Compustar 1WG3R fixed-code path
    Docstring quality pass + new test coverage. No behavior change.
    Driver verdict: works correctly for our use. The bit-banging loop is
    protocol-agnostic — it just toggles GDO0 per (high_us, low_us) tuple.
    The 700-1500 us pulse widths the Compustar 1WG3R family uses are well
    inside what MicroPython's time.sleep_us can deliver with ~10-50 us
    jitter on ESP32 (= 1-7% of pulse width, inside the receiver's
    ~10-15% tolerance window). No driver changes needed.
    Docstring updates:
    - Top-of-file header now describes the Compustar 1WG3R family
    use case + symmetric-PWM bit encoding (was: HCS PWM only).
    - Usage example shows build_pulse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
    [test_cc1101.py]
2026-05-24 pi/display: add Manual Control panel + /api/transmit/<button> endpoint
    Wires four fob-style buttons (Start/Lock/Unlock/Trunk) under the existing
    controls. Start reuses CMD_START_ENGINE end-to-end. Lock/Unlock/Trunk
    return HTTP 501 with a structured detail blob noting that a follow-on
    commit needs to add CMD_TRANSMIT_BUTTON to the wire protocol on both
    sides (esp32/src/lib/pi_link.py + pi/app/comms/esp32_link.py + a new
    handler in controller.py).
2026-05-24 docs/13-obd2-install: wire to OBD-II via Y-splitter + fused pigtail
    First in-car install step. Covers passive Y-splitter selection (Bafx-
    style, avoid switched/active splitters), pin-16 always-hot pickup with
    2 A ATM fuse + SMBJ24CA TVS placement, single-point ground via pin 4,
    twisted-pair CAN to SN65HVD230 with no terminator at the controller
    end (Spectra has 60 ohm at each ECU already), strain relief at the
    plug, and a power-up bench-check sequence before going live in the
    car. Includes the "do not bench-test with engine running until
    verified" safety callout the phase-3 plan calls out.
2026-05-24 docs/14-case-mounting: removable under-dash install + display routing
    Covers the physical install: Hammond 1591ESBK case mounted with
    heavy-duty Velcro (not VHB) under the driver's-side knee panel,
    removable wire ties for cable anchoring to factory harness only,
    antenna placement priorities (433 MHz quarter-wave vertical and
    clear of metal-foil insulation), 5" display VHB-mounted to the dash
    top above the radio bezel with HDMI + USB routed up behind the
    column trim, vent holes for summer heat. Includes a full removability
    dry-run before sign-off. Explicitly avoids waterproofing (interior
    install, IP54 enclosure is overkill) and steering-column airbag
    clockspring zones.
2026-05-24 controller: log machine.reset_cause() at boot
    Adds persistence.reset_cause_string() that maps the MicroPython reset code
    to a stable label (PWRON_RESET, WDT_RESET, DEEPSLEEP_RESET, etc.) and falls
    back to "cpython" on the host. VroomController.run() now emits this as an
    "info" LOG event so post-mortems can answer "did the watchdog fire?" from
    the Pi-side event archive without a serial console.
    [controller.py, test_persistence.py]
2026-05-24 pi/trip-log: persist engine-run cycles to JSONL + show last 10 on dash
    Each engine_started event opens a trip row in memory, OBD samples
    track peak rpm/coolant_temp during the run, and engine_stopped
    finalizes the row to /var/log/vroom/trips.jsonl (configurable via
    TRIP_LOG_PATH in pi/app/config.py).
    A new GET /api/trips endpoint returns the last N rows newest-first;
    the dashboard polls it every 30 s and renders a small dark-theme
    table under the events panel.
2026-05-24 pi/dashboard: per-PID OBD history + inline SVG sparklines on gauges
    state.update_obd() now appends each numeric sample to a bounded
    60-entry ring per PID (OBD_HISTORY_MAX), keyed by name. snapshot()
    returns deep-copied rings so request handlers can't mutate state.
    Each gauge tile in the dashboard grows an auto-scaled SVG sparkline
    underneath the big number, with a dot at the most-recent sample.
    Pure vanilla SVG — no JS library, no new deps. Range auto-fits the
    60-sample window and pads flat data so the line draws mid-tile.
2026-05-24 docs/15-first-trigger: first in-car manual trigger with safety guards
    Walks through the first time the dashboard Start button fires the
    engine from the fully-installed in-car system. Safety checklist (Park,
    key out, hood open, valet switch reachable, real FOB on person, CO-
    safe location), expected timeline from button press to OBD data
    flowing (target ~5 s end-to-end), abort conditions that demand
    flipping the valet switch, three stop paths in order of preference
    (dashboard Stop, re-tap Start, valet switch), and a five-cycle
    verification before sign-off. Explicitly gates step 16 on five clean
    cycles in a row.
2026-05-24 docs/16-first-auto-start: voltage-triggered auto-start via raised threshold
    Tests the actual point of the project without waiting weeks for a real
    voltage drop. Temporarily raises LOW_V_TRIGGER to 0.2 V above the
    current resting voltage, watches the sustain counter satisfy, observes
    the full trigger -> crank -> idle -> stop -> cooldown -> deep-sleep
    cycle, then restores the production 12.2 V threshold. Includes a
    sanity-check pass after restore to confirm trigger doesn't re-fire,
    and a prominent safety callout about NEVER walking away from the car
    with an elevated threshold still set.
2026-05-24 docs/17-home-assistant-integration: HA entity YAML + Lovelace + alerts
    Surface battery voltage, engine state, OBD telemetry, and last-event
    in Home Assistant via the Pi's existing MQTT publishes. Covers the
    broker setup (Mosquitto add-on or external), entity declarations
    (sensors, binary_sensor for engine running, button entities for
    Start/Stop/Ping using the daemon's COMMAND whitelist), a minimal
    Lovelace card, and an automation that notifies on every
    low_voltage_trigger event. Also discusses InfluxDB + Grafana for
    long-term voltage-trend logging, which is the single most useful
    piece of data this build produces.
2026-05-24 controller: warn on ADC drift between successive samples
    If a battery reading jumps by more than ADC_DRIFT_WARN_V (default 1.0 V
    battery-side) compared to the previous sample, emit a warn LOG event with
    prev/now/delta. Catches stuck ADC channels, brown-out conditions, and a
    divider connector going flaky — observability only, the trigger logic
    still runs on the new reading. First sample after boot is skipped to
    avoid a false-positive against last_voltage=None.
    [config.py, controller.py, test_controller.py]
2026-05-24 docs/18-long-term-stability: monthly+seasonal observation playbook
    Defines normal vs concerning for the metrics that only show up after
    weeks of installed operation: parked current after LM2596 settles,
    false-trigger rate, MQTT publish volume, /var/log/vroom growth + log-
    rotation verification, ESP32 watchdog/brownout/cosmic-ray reboot
    distribution, and the winter (cold battery V curve) / summer (engine-
    bay + Pi thermal) seasonal behaviors. Includes a weekly / monthly /
    seasonal / annual checkup schedule. The hardest problems on this
    build are slow drifts; this doc is the catch.
2026-05-24 controller: hard cap on STOPPING phase to prevent wedged state
    If the controller is still in STOPPING after RUN_DURATION_S +
    STOPPING_HARD_CAP_MULT * PI_SHUTDOWN_GRACE_S have elapsed since
    run_start_ts (default 2x the grace), force-cut Pi power, emit a warn
    LOG, and transition to COOLDOWN. Guards against a hung Pi or a UART
    death that would otherwise leave the state machine stuck waiting for
    a grace timer that never ticks.
    [config.py, controller.py, test_controller.py]
2026-05-24 persistence: cap absurd streak counts as RTC corruption
    If load_streak() reads a valid magic but a count > _MAX_REASONABLE_STREAK
    (10000), return 0 instead of trusting the value. Defends against partial-
    magic-match-with-garbage scenarios (low-voltage glitch, all-0xFF erased
    RTC, brown-out) where a 0xFFFF count would otherwise be interpreted as a
    huge streak and trigger the engine on the next sample after boot.
    [test_persistence.py]
2026-05-24 sdr/scripts/capture-to-secrets: bench-day helper to extract paste-ready secrets
    Wraps demod-compustar.py to take an rtl_sdr .bin capture and print the
    exact COMPUSTAR_PACKETS line + COMPUSTAR_REMOTE_ID comment for the
    specified button. Decodes all bursts in the capture and warns if their
    patterns disagree (mixed-button capture or demod alignment issue).
    Filters out the first two sync candidates per 3-sync burst so the
    1WSHR-PRO framing decodes correctly.
2026-05-24 esp32/scripts/self_test: automated smoke-test for the controller state machine
    Walks VroomController through MONITORING -> STARTING -> RUNNING ->
    STOPPING -> COOLDOWN -> MONITORING with mocked ADC / radio / UART /
    Pi-power pin, asserting each transition. Distinct from simulate.py:
    this script makes assertions and exits non-zero on failure, suitable
    for a "did the flashed firmware load and behave at all?" sanity check
    after pulling new code.
2026-05-24 docs/19-cellular-alerting: optional sketch for off-network monitoring
    Marked explicitly as not-yet-applicable to this Spectra build (which
    lives in home-WiFi range). Sketches the extension path for readers
    who want cellular: modem options (SIM7600G-H as the default,
    SIM7080G for cheaper NB-IoT, EC25 for industrial), the second-buck
    power split to absorb the modem's 2 A TX surge, MQTT bridge via
    HiveMQ Cloud free tier vs. self-hosted with port forwarding, and a
    $120/yr cost estimate. Includes two lower-cost alternatives (Pi-
    side daily summary email over home WiFi; prepaid USB cellular stick
    for once-a-week SMS) for readers who don't need full real-time
    off-network alerting.
2026-05-24 docs/reproduce: link phases 3-4 to the newly written 13-19 docs
    Converts the previously-unchecked WIP bullets to linked entries
    matching the style used for steps 08-12. Phase headings drop the
    " — WIP" suffix now that all referenced docs exist.
2026-05-24 wire protocol: add CMD_TRANSMIT_BUTTON for Lock/Unlock/Trunk dashboard buttons
    Completes the follow-up flagged by subagent B's Pi-side dashboard work.
    Lock/Unlock/Trunk dashboard buttons were returning HTTP 501 pending this
    ESP32-side wire-protocol extension; now they actually transmit.
    esp32/src/lib/pi_link.py + pi/app/comms/esp32_link.py:
    Add CMD_TRANSMIT_BUTTON = 'transmit_button'. Payload field 'button' is
    case-insensitive ('start' / 'lock' / 'unlock' / 'trunk').
    esp32/src/controller.py:
    Extend _handle_command with a branch for CMD_TRANSMIT_BUTTON. The
    'start' button is routed through _trigger_start so it still gets the
    full voltage-trigger handshake (power on Pi, transition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
2026-05-24 docs: reconcile cross-doc inconsistencies flagged by subagent A
    Five issues, four fixes (one resolved as a non-issue):
    1. BOM fuse size: was '1A blade fuse', should be '2A ATM mini'.
    docs/13-obd2-install.md uses 2A throughout for good reason
    (~700 mA peak display + everything else needs margin, and 1A
    is tight enough to nuisance-trip on alternator-spike inrush).
    Fixed in docs/BOM.md and the inline ASCII diagram in
    docs/architecture.md.
    2. Shutdown-command naming: docs/architecture.md said 'ESP32 sends
    SHUTDOWN over UART', but the actual constant is CMD_SHUTDOWN_PI
    = 'shutdown_pi'. Updated both the architecture section and the
    trigger-timeline narrative to use the re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
2026-05-24 process: pyproject.toml + ruff lint, scrubbed F-level issues
    Adds a minimal pyproject.toml that defines the project metadata and a
    conservative ruff lint config (rules F + E9 + W6) — captures real
    bugs (unused imports, undefined names, syntax) without imposing style
    on a personal-scale project.
    Initial ruff run flagged 11 issues, 10 auto-fixed:
    esp32/scripts/simulate.py F541 + f-string fixup
    sdr/scripts/synth_capture.py F401 unused 'import os'
    sdr/scripts/demod-compustar.py F401 unused 'math'
    sdr/scripts/analyze-framing.py F401 unused 'sys'
    sdr/scripts/consensus-bits.py F401 unused 'sys'
    sdr/scripts/diff-bits.py F541 f-string fixup
    sdr/scripts/diff-captures.py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
2026-05-24 snmp: add stdlib SNMPv2c read-only responder for vroom OIDs
    Adds a second Pi-side daemon that exposes vroom telemetry over SNMP so
    an existing NMS (LibreNMS, Cacti, observium, snmpwalk) can poll the
    unit alongside other LAN infrastructure. Read-only — no SET requests
    honored — and intentionally scoped to vroom-specific OIDs only; the
    host MIBs (sysUptime, ifTable, etc.) come from whatever else polls
    the box.
    Design choices follow the asus2snmp / ddwrt2snmp pattern documented
    in the operator's vault:
    - Stdlib only (~300 LoC of BER + PDU handling; pysnmp-lextudio
    would be overkill for nine read-only scalars)
    - In-process snapshot from pi.app.state — same data the dashboard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
2026-05-27 gitignore: chat transcripts (chat.txt and variants)
    Same intent as the braindump.md entry above it — local reference
    transcripts written out from Claude sessions contain conversational
    context (operational details, half-decided tradeoffs) that shouldn't
    land on a public remote.
    The chat.txt currently in the working tree was never staged, never
    committed, never pushed (verified via git log --all, ls-files, and
    ls-tree of origin/main) so this is purely a forward-looking rule.
2026-05-30 snmp: drop misleading systemd Wants= + document cross-process bug + daily log
    While provisioning vroom on the bench Pi (a Pi Zero 2 W on the LAN),
    discovered the SNMP responder serves boot-time defaults forever — not
    live ESP32 telemetry. Cause: snmp_responder runs as its own process,
    imports pi.app.state, gets its OWN module-level STATE dict; the
    daemon process has a different dict that the UART listener writes to.
    Same Python module name does not mean shared state across processes.
    The wire format is correct (snmpwalk works, BER encoding round-trips,
    GET/GETNEXT/walk all do the right thing) — just the values are stale.
    Three changes:
    pi/systemd/vroom-snmp.service:
    Drop After=v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
2026-05-30 snmp: refactor responder to thread-in-daemon (fixes cross-process bug)
    The yesterday's commit shipped snmp_responder as a separate process
    (vroom-snmp.service). Today's provisioning on the bench Pi found that
    'separate process' meant 'separate copy of the STATE dict', so every
    OID returned its boot-time default forever — the UART listener was
    writing to a dict the SNMP process couldn't see. snmpwalk worked at
    the wire-format level but the values were meaningless.
    This commit moves the responder into a thread inside pi.app.daemon
    (sibling to uart_listener, mqtt_publisher, mqtt_subscriber). Same
    process, same module, same STATE dict.
    pi/app/snmp_responder.py
    + start_thread(bind_host,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
    [config.py]
2026-05-30 logs/2026-05-30: append SNMP refactor deploy + live-data verification
    Same-day continuation of the daily log. Covers the c3876a1 refactor:
    what changed, the git-pull-blocked-by-local-sed-patch gotcha that
    ate ten minutes during deploy, the post-deploy /api/state vs
    snmpwalk side-by-side proving the cross-process bug is fixed
    (battery_mv:12600 now matches v_battery:12.6 in JSON, instead of
    the previous battery_mv:0), and the BCM43430 UDP-over-Wi-Fi packet-
    loss observation that explains intermittent walk timeouts (UDP +
    Wi-Fi+BT coexistence, not a code bug).
    Forward-scrubbed: no LAN IPs, hostnames, or deploy creds. Vault has
    the unredacted version including the deploy-time commands.
    TODO li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
2026-05-30 logs/2026-05-30: restore hostnames + project context (kept IPs/users out)
    Prior pass was too aggressive — replaced 'slypi' with 'the bench Pi',
    'BEAST' with 'the dev workstation', dropped vault note references
    entirely, and lost the BCM43430 Wi-Fi/BT coexistence context. None
    of that is PII; hostnames are labels, not credentials.
    Restored:
    - 'slypi' / 'BEAST' as host labels throughout (23 mentions)
    - Reference to the slypi vault note as 'the slypi vault note'
    (not the full IP-bearing wikilink)
    - The 'prior setup state' paragraph in the intro — slypi already
    had NetworkManager static IP, Postfix relay, logcheck,
    unattended-upgrades, paired BT before vroom landed on top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
2026-05-30 pi: uart_listener error-suppression + vroom.service systemd hardening
    Two cleanups for slypi (and any future deployed vroom Pi):
    uart_listener.listen_forever:
    Adds repeated-error suppression. First instance of an identical
    recv() error logs immediately; further identical errors are
    suppressed for ERROR_SUPPRESSION_WINDOW_S (60s by default), at
    which point a single 'still failing' summary line lands with the
    count + elapsed time. When recv() recovers, a 'recv() recovered'
    line is logged (with the suppressed count if any). Pre-fix
    behavior — every error logs — is preserved when
    error_suppression_window_s=0.
    Real-world trigger: pre-ESP32-arrival, /dev/serial0 doesn't exi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
    [uart_listener.py]
2026-05-30 logs/2026-05-30: append evening hygiene pass — 4 small Pi-side TODOs cleared
    Closes the four items the user requested from the table:
    - Test suite baseline on slypi's Python 3.13 — 192/192 → 197/197
    - uart_listener error suppression (60s window, 'still failing'
    summary, recovery line) — kills journal spam
    - vroom.service systemd hardening — defense-in-depth directives
    matching the deleted vroom-snmp.service (minus NoNewPrivileges,
    since the daemon needs sudo shutdown to work)
    - enable_uart=1 + serial console off + node in dialout group —
    /dev/serial0 now usable; zero ERROR lines after restart
    Two new slypi-specific gotchas pinned (in both this log and th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
2026-05-30 logs/2026-05-30: append mosquitto broker setup
    Final TODO from the morning's list — picked 'fresh mosquitto on slypi'
    over 'reuse existing LAN broker'. vroom is a self-contained appliance,
    no upside to coupling its messaging to another service that could be
    retired independently. ~3 MB RSS, slypi has the headroom.
    Setup:
    - mosquitto 2.0.21 + mosquitto-clients from trixie
    - /etc/mosquitto/conf.d/vroom.conf: 3-line override (listener 0.0.0.0,
    allow_anonymous false, password_file). Anything more would
    duplicate base config keys, which is fatal in 2.x.
    - vroom user, 128-bit random password (openssl rand -hex 16),
    hashed in /etc/mosquitto/passwd (root:mosquitto, 0640)
    - cle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
2026-06-01 dashboard: add map view + toggle; switch kiosk docs from chromium to surf
    Two related changes driven by the 2026-05-31 slypi bring-up findings
    relayed via braindump.md.
    (1) Docs + provision.sh: chromium -> surf/openbox/xinit
    Chromium reliably OOM-killed itself on the Pi Zero 2 W (512 MB total,
    ~250 MB free after vroom.service + mosquitto are loaded). Surf (the
    suckless WebKit2GTK browser) handles the dashboard + Leaflet map at
    ~60 MB RSS without OOM.
    docs/10-pi-setup.md:
    - Replace 'chromium kiosk' mentions with 'surf/openbox/xinit' kiosk
    - New 'Why surf, not Chromium' section explaining the OOM finding
    and the fallback path (Chromium is still installed if you want
    to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
    [config.py]
2026-06-01 logs/2026-06-01: dashboard map view + surf docs update
    Closes both gaps surfaced by the slypi session 2026-05-31 heads-up:
    the vroom repo's reproduction docs still said 'chromium kiosk' even
    though Chromium OOM-killed on the Pi Zero 2 W, and the dashboard had
    no map view yet (slypi was running a standalone map.html instead of
    vroom's dashboard).
    Same-day pass:
    - docs/10-pi-setup.md + provision.sh: chromium -> surf/openbox/xinit
    with a 'Why surf, not Chromium' callout explaining the OOM
    observation. Chromium kept as apt fallback.
    - Dashboard gets a map view + corner toggle button. Tap toggles
    between gauges and map; choice persisted to localStorage.
    Default center is Edm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
2026-06-01 scope: ship v1 as ESP32-only; park Pi-side as optional v2 telematics
    Docs-only refactor. No code deleted, no slypi services stopped,
    firmware untouched (was always self-sufficient — Pi-related I/O is
    inert when no Pi is wired up).
    Original goal of the project was 'battery never dies in winter' — a
    voltage-triggered remote-start that fires when battery sags. The
    trigger function has always lived entirely on the ESP32 (voltage
    monitoring via ADS1115, RF replay via CC1101, run timer, cooldown).
    Recent weeks grew a meaningful Pi-side telematics half on top of that
    core — dashboard, MQTT broker, SNMP responder, map view, kiosk on
    slypi. All of it works (199 tests passing, clean lint, depl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
2026-06-10 logs/2026-06-09: Stage 1 — ESP32 reads a voltage (first hardware)
    First real-hardware milestone of v1. Parts arrived; built the
    voltage-sensing front end on a breadboard and confirmed the ESP32
    reads a divided voltage through its onboard ADC and reports it on a
    self-served WiFi dashboard.
    Captured from today's 'ESP32' session + 5 bench/dashboard photos
    (logs/images/2026-06-09/):
    - Voltage divider: 1 MOhm (top) + 220 KOhm (bottom) + 100 nF cap
    across the low leg. Ratio (R1+R2)/R2 = 5.545, confirmed by the
    dashboard caption 'divider x5.545'. Chosen over the BOM's
    30k/10k for ~10 uA quiescent draw (vs ~315 uA) — important for
    an always-on battery monitor. The 100 nF cap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
2026-06-10 logs/2026-06-09: reword divergence section — state facts, drop reader-facing questions
    The divergence section read like it was asking the site visitor my
    open questions ('Is the onboard ADC accurate enough...', 'Is the S3
    the permanent choice...') and narrating my process ('flagging, not
    fixing', 'I'd rather answer those...'). A writeup of what was done
    shouldn't pose questions to the reader. Rewrote it to state plainly
    what diverged from the documented design and why (lower quiescent
    draw, S3 RAM/PSRAM enables the dashboard, onboard ADC replaces the
    ADS1115 pending calibration), and noted that the BOM/architecture
    will be reconciled once calibration confirms accuracy — as a
    statement, n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
2026-06-10 esp32-s3: import S3 Arduino firmware + integrate CC1101 433MHz Compustar TX
    Stage 2 of the v1 build: the 433 MHz transmitter (the BOM's CC1101
    module) is now programmed into the ESP32-S3 firmware. Compiles clean;
    not yet wired or flashed (board #1 still runs fw 1.5 + bare divider).
    Brought the firmware into vroom so it no longer depends on the sibling
    Claude_Projects/esp32 learning folder:
    esp32-s3/ NEW tree — the actual flashed build
    voltage_monitor/voltage_monitor.ino fw 1.6
    voltage_monitor/cc1101_compustar.{h,cpp} self-contained CC1101 driver
    voltage_monitor/partitions.csv
    voltage_monitor/secrets.h.example
    docs/voltage-monitor.md + wir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
    [partitions.csv]
2026-06-11 esp32-s3: fw 1.7 — CC1101 non-transmitting self-test; wired + verified
    CC1101 is now physically wired to board #1 (VCC/GND + CSN15 SCK18
    MOSI16 MISO17 GDO0 4, 433 MHz whip). Added a safe self-check so '433
    working?' can be answered without radiating a starter code, flashed it
    OTA, and confirmed the RF chain is healthy.
    Low-voltage remote-starter mode stays DISABLED as instructed — no
    auto-trigger code, COMPUSTAR_PATTERNS_CAPTURED still 0, /transmit still
    blocked. No starter packet transmitted.
    cc1101_compustar.{h,cpp}: + CC1101SelfTest selfTest()
    - reads PARTNUM/VERSION
    - reads back 6 config registers (FREQ2/1/0, PKTCTRL0, MDMCFG2,
    FREND0) and compares to what configure433Ook w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
2026-06-12 esp32-s3: fw 1.8 — GDO0 wire-continuity self-check (no SDR needed)
    A single CC1101 can't hear its own TX (half-duplex), so on-air
    radiation still needs an external receiver. But the one wire the 1.7
    self-test didn't exercise — GDO0 (the data line) — CAN be verified with
    no extra hardware: have the CC1101 drive a ~135 kHz clock onto GDO0 and
    read it back on the ESP32 GPIO against internal pull-down then pull-up.
    Driven-both-ways = connected; floating = follows the pull. Chip stays
    IDLE, nothing radiated.
    cc1101_compustar.{h,cpp}: + gdo0Continuity(), + CC1101SelfTest.gdo0Ok;
    selfTest() now includes it and folds it into the overall verdict.
    voltage_monitor.ino (1.7 -> 1.8): /rftest + boo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
    [cc1101_compustar.cpp, cc1101_compustar.h, voltage_monitor.ino]
2026-06-12 esp32-s3: fw 1.9 — arm manual remote-start TX + prominent Start Engine button
    On instruction: wire up manual remote-start transmit via a dashboard
    button. Voltage-based auto-start stays OFF (no such code exists).
    The real 35-bit Compustar patterns (captured from the FOB 2026-05-24,
    in the gitignored sdr/analysis/framing.local.md) were pasted into the
    gitignored secrets.h with COMPUSTAR_PATTERNS_CAPTURED 1. The patterns
    and WiFi creds are NOT committed — only this source change is:
    - dashboard: START is now a prominent green '🔥 Start Engine' button
    (Lock/Unlock/Trunk stay as secondary); confirm dialog reworded to
    state it transmits the real code and cranks the engine
    - FW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
2026-06-12 logs/2026-06-11: add CC1101 wiring photos + gap-filled pin mapping
    The firmware/config name the ESP32 GPIOs by number+signal but not which
    physical pin on the CC1101's 2x4 header each signal is. Added the module
    pinout reference (what was actually used to wire it) + the as-wired
    photo, and a combined table: header pin -> signal -> ESP32-S3 GPIO.
    Also: retitled to span the day's fw 1.7->1.9 (wired, self-tested,
    remote-start armed) and noted what's left for the car install — buck
    converter set to 5V + a 12V tap (trying a 12V adapter to find an
    always-on accessory socket before falling back to the OBD-II tap).
    Images are hardware/reference only — no secrets. Real FOB patterns +
    WiFi creds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
2026-06-12 logs/2026-06-11: add dashboard ARMED screenshot
    The CC1101 · ARMED status + green Start Engine button on the live
    dashboard. No secrets in frame (RSSI/uptime/mem only — no IP/SSID).
2026-06-12 docs: document fixed-code brute-force weakness (the real exposure)
    Per discussion: the security risk isn't that this FOB's specific codes
    leaked — it's that the Compustar 1WG3R scheme is FIXED CODE and therefore
    cycle-able. The only per-vehicle variable is the 16-bit Remote ID (~65k);
    button codes are a small known set. Anyone with a sub-GHz transmitter
    (this project's own CC1101 + ESP32) can walk the code space and
    remote-start / unlock every 1WG3R-equipped vehicle in range — in a full
    parking lot you hit one quickly. Keeping these particular bits secret
    buys little against that.
    - docs/compustar-research.md: replaced the over-reassuring 'why a thief
    can't exploit this' section with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
2026-06-12 esp32-s3: fw 2.0 — NTP time sync + timestamped history + graph hover tooltips
    Three dashboard asks, all tied to having a real wall-clock:
    NTP sync:
    - configTzTime(TZ, time.windows.com, pool.ntp.org) on STA connect.
    TZ_INFO = MST7MDT,M3.2.0,M11.1.0 (Mountain/Edmonton w/ DST), a
    single config constant; dashboard formats timestamps in the
    browser's TZ so display is right regardless.
    - re-sync every 6h (NTP_RESYNC_MS) for drift, plus retry-every-30s
    until the clock reads a plausible year after connect.
    - /json gains epoch + time_ok; footer shows a live clock.
    Timestamped history:
    - Sample gains uint32_t ts (epoch when sampled, 0 pre-sync).
    - /history CSV leads with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
    [voltage_monitor.ino]
2026-06-14 esp32-s3: fw 2.1 — CPU clock toggle (80/240 MHz) + WiFi power-save toggle
    Dashboard "Power and performance" card with two runtime controls, each
    showing current state plainly:
    - CPU clock: POST /cpu?mhz=80|240 (setCpuFrequencyMhz); segmented
    buttons with the active clock highlighted + live MHz readout. 80 MHz
    is the WiFi-safe floor; only 80/240 accepted (else 400). New /json
    field cpu_mhz.
    - WiFi power saving: POST /wifips?on=0|1 (WiFi.setSleep); ON/OFF badge
    + toggle button. New /json field wifi_ps from WiFi.getSleep().
    Runtime-only (reset to 240 MHz / PS-on on reboot). No RF changes.
    Verified live: toggles work over HTTP (server stays up at 80 MHz),
    bad mhz rejected 400, histor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
    [voltage_monitor.ino]
2026-06-14 esp32-s3: fw 2.2 — persist CPU clock + WiFi power-save across reboot/brownout (NVS)
    The 2.1 toggles were runtime-only. For a car device that browns out on
    crank, the chosen settings should stick.
    - Store both in NVS via Preferences (namespace "vroom", keys cpu_mhz /
    wifi_ps). NVS is a dedicated flash partition: survives power loss,
    and its journaled/wear-levelled writes are power-loss safe (brownout
    mid-write leaves old-or-new, never corrupt).
    - Write on every toggle (/cpu, /wifips handlers).
    - Restore at boot: CPU clock applied before WiFi (setCpuFrequencyMhz);
    WiFi power-save applied after WiFi.begin (WiFi.setSleep). First boot
    or bad value falls back to 240 MHz / PS-on.
    - Unt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
    [voltage_monitor.ino]
2026-06-14 esp32-s3 README: document fw 2.2 dashboard features
    Bump the firmware README from fw 1.6 to fw 2.2 and add the dashboard
    features that accreted since: per-point graph hover tooltips + NTP time
    sync (2.0), and the new Power and performance card — CPU clock toggle
    (80/240 MHz, /cpu) and WiFi power-save toggle (/wifips), both NVS-
    persistent across reboot/brownout (2.1/2.2).
2026-06-14 esp32-s3: fw 2.3 — fix CPU/WiFi buttons firing a stray /transmit
    The RF transmit handler bound to every button.tx; the new CPU clock and
    WiFi power-save buttons share that class but have no data-b attribute,
    so clicking one POSTed /transmit?button=null and flashed "null failed:
    unknown button" in the RF status line. The firmware rejected it (no
    pattern matched, nothing transmitted) — harmless but wrong/confusing.
    Fix: scope the RF handler to button.tx[data-b], so only the four real
    RF buttons (START/LOCK/UNLOCK/TRUNK) get it. Power controls now run
    only their own handlers and never touch /transmit. No endpoint or RF
    behavior change.
    Verified: OTA 2.2 -> 2.3; served dashboard now carrie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
    [voltage_monitor.ino]
2026-08-06 docs: add OBD-II power tap pinout diagram (12 V socket is switched)
    The plan to power from a 12 V accessory socket is dead — testing showed
    it is not always-on, and a parked-car battery monitor needs unswitched
    supply. Committing to the OBD-II tap per doc 13 (pin 16 is unswitched
    battery+ by the J1962 standard).
    Adds docs/images/obd2-power-pinout.svg (+ 2x PNG for phone use under the
    dash), drawn rather than downloaded: no licensing question and it is
    tailored to this build, highlighting only the two wires v1 needs
    (pin 16 +12 V, pin 4 chassis GND) and greying out the rest.
    Orientation verified against an independent CAN-tools vendor pinout
    rather than from memory: looking into the car's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
2026-08-06 esp32-s3: fw 2.5 — low-voltage auto-start (opt-in), start log, CPU load
    The feature held back since June. Ships DISABLED; a dashboard toggle arms
    it when the unit goes in the car.
    Auto-start: fires the Compustar START code once battery voltage stays
    below a threshold for a sustained period, so the alternator can recharge
    before the battery is too flat to crank. Defaults below 12.4 V held 60 s,
    2 h cooldown, all configurable and persisted in NVS.
    12.4 V rather than the MicroPython tree's 12.2 V, for a car parked
    outside in Alberta: near -20 C the engine wants ~2x cranking torque while
    the battery gives ~half its power, and 12.2 V resting (~SG 1.19) has
    electrolyte that slushes near -26 C.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
2026-08-06 esp32-s3: fw 2.6 — 24 h cap optional (0/-1 = unlimited), CPU load graphs
    The hard cap of 3 auto-starts per 24 h was wrong. It is now optional and
    OFF by default; 0 or -1 means unlimited, configurable from the dashboard.
    Why: this car has a parasitic drain that has already destroyed two
    batteries, and cold kills them here every winter. A count cap means
    choosing to let the battery sit flat once it is hit — the exact failure
    the project exists to prevent, and deep-discharge sulfation is what
    killed the last two. Extra starter cycles are cheap by comparison: a
    starter is good for tens of thousands of cycles. The runaway guard that
    actually works is the lockout — two starts in a row drawi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
    [voltage_monitor.ino]
2026-08-06 esp32-s3: fw 2.7 — native read-only SNMP agent so Cacti can poll the board
    SNMP existed only on the Pi (pi/app/snmp_responder.py, subtree .99999.7),
    and that is the v2 telematics half that is parked — so the shipped v1
    ESP32-only build had nothing for an NMS to poll. This adds an agent to
    the firmware itself.
    snmp_agent.h/.cpp: read-only SNMPv1/v2c on UDP 161, hand-rolled BER
    (~300 lines, no library). GET / GETNEXT / GETBULK. There is no SET path
    at all, by construction. Wrong community is dropped silently, as snmpd
    does. Subtree 1.3.6.1.4.1.99999.8 — deliberately .8 so it cannot collide
    with the Pi responder's .7 if both ever run.
    39 OIDs covering everything the dashboard shows: bat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
    [snmp_agent.cpp, snmp_agent.h, voltage_monitor.ino]
2026-08-06 esp32-s3: fw 2.8 — surface every SNMP metric on the dashboard too
    Several values were pollable over SNMP but not visible on the main page,
    or only surfaced conditionally inside one state's status line (fail
    count only while locked out, park timer only while park-waiting, low
    countdown only while counting). Now all of them are always-on tiles.
    New system tiles: voltage status (colour-coded), NTP clock synced yes/no,
    HTTP bytes in/out totals. Free heap and free PSRAM now show used/total
    rather than free alone.
    New always-visible auto-start grid: low-for countdown, cooldown left,
    park confirm progress, auto-starts in 24 h (with the cap or "no cap"),
    fail streak, lockout, starts logged, and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
    [voltage_monitor.ino]
2026-08-06 esp32-s3: fw 2.9 — battery drain rate (mV/h) + projection to flat
    Turns the parasitic-drain hunt from "does this trace look flatter?" into a
    number you can compare between fuse pulls.
    Least-squares fit of voltage against time over the most recent PARKED
    window: the walk backwards ends at any sample where the alternator was
    running (>= 13.2 V), at an implausible reading, or at a >10 min hole in
    the timestamps (board was off), so a drive cycle or a power gap cannot
    contaminate the slope. Two passes rather than buffering, to keep ~11 KB
    of arrays off the heap.
    Reports signed mV/h (negative = discharging), r2, sample count, window
    span, and projected days to 11.8 V (the point it will not cra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
2026-08-06 esp32-s3: fix mojibake in the dashboard, normalize sources to ASCII
    The dashboard was rendering "divider Ã—5.545 Â· cal 1 Â· ADC 589 mV"
    instead of the intended text.
    Cause was mine, not the browser's: an earlier PowerShell edit that moved
    a block of code read the file with Get-Content (which decodes as
    Windows-1252) and wrote it back with Set-Content -Encoding UTF8, so every
    multi-byte UTF-8 character got double-encoded and a BOM was added. The
    file then had a mix of double-encoded text from before that edit and
    correctly-encoded text from edits after it, so simply reversing the
    double-encode would have corrupted the good half.
    Fixed by normalizing all four firmware sources to pure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
    [cc1101_compustar.cpp, cc1101_compustar.h, snmp_agent.cpp, snmp_agent.h, voltage_monitor.ino]
2026-08-06 esp32-s3: drain tile reports its partial window instead of a bare 0
    computeDrain() returned n=0 whenever the contiguous parked window was
    shorter than the 30-sample minimum, which on the dashboard read as
    "broken" rather than "still settling".
    It was in fact working correctly: a reflash had left an 842 s hole in the
    history (plus one ts=0 sample recorded at boot before NTP resolved), the
    backward walk hit the >10 min gap guard and stopped, and the remaining
    window was legitimately too short to fit. Refusing to fit a slope across
    a hole where the board was powered off is the intended behaviour, and is
    what stops a reboot from inventing a fake discharge trend.
    Now f.n carries the partial cou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
    [voltage_monitor.ino]
2026-08-06 docs: correct the parked power budget for the as-built always-on S3
    power-budget.md budgeted ~9.5 mA parked and ~41 days to no-start. That
    described a design we did not build: an ESP32-WROOM-32U in deep sleep
    waking 1 s per minute with an ADS1115. The shipped build is an
    ESP32-S3-WROOM-1-N16R8 that never sleeps -- it holds a WiFi STA
    association up continuously for the dashboard, SNMP agent and OTA, and
    CONFIG_PM_ENABLE is not set in the Arduino-ESP32 3.3.10 prebuilt libs so
    automatic light sleep is compiled out too. There is no duty cycle
    anywhere in this firmware.
    Corrected estimate: ~33 mA at 12.6 V (range 25-45), i.e. 3.5x the old
    figure, and ~13 days rather than ~41 to the point a cold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
2026-08-06 esp32-s3: fw 3.0 - AP fallback retries the home WiFi instead of latching
    The SoftAP fallback was a one-way door. apMode was set true once and never
    cleared, and WiFi.begin() was only ever called from setup(), so a brief
    router hiccup stranded the board in SoftAP until someone power-cycled it.
    That is bad in two ways for a car. The board becomes unreachable, and AP
    mode has no power save at all, so it silently roughly doubles the parked
    draw (~33 mA -> ~61 mA per docs/power-budget.md) exactly when nobody can
    see that it happened. This was already flagged as the highest
    value-per-effort item on that document's mitigation list.
    Now, while in AP mode, the firmware re-tries the home network eve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
2026-08-06 esp32-s3: fw 3.1 - wait for CC1101 TX before clocking data (sync was eaten)
    Symptom: manual Lock/Start transmitted (start log ok=true, self-test all
    green, version 0x14 genuine TI part) but the car did nothing, while the
    real FOB locked the car fine -- so the receiver was healthy and the fault
    was ours.
    Cause: transmitButton() strobed STX and immediately began bit-banging
    GDO0. But MCSM0 = 0x18 sets FS_AUTOCAL = calibrate-on-every-IDLE->TX,
    which takes ~721 us during which the PA radiates nothing. The leading
    sync pulse is ~1476 us, so calibration swallowed the first half of it --
    and because each of the 8 repeats returned to IDLE and re-entered TX,
    every repeat lost its sync. The sync trip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
2026-08-06 esp32-s3: fw 3.4 - SDR-free RF diagnostics (crystal measure + register dump)
    Added two no-SDR diagnostics to chase why the transmitter, though verified
    faithful to the FOB in content/timing/structure, does not trigger the car.
    /xtaltest: measures the CC1101 crystal by clocking CLK_XOSC/192 onto GDO0
    and counting it with the ESP32 PCNT hardware counter. This rules the 27 MHz
    -> ~450 MHz "wrong crystal, silent, self-test still green" failure in or
    out. Result on this module: 25.991 MHz, rock-solid over 4 runs = a 26 MHz
    part, so we transmit ~433.8 MHz -- on target. (An earlier software-ISR
    version read ~25.5 MHz; that was edge loss under WiFi ISR preemption at
    135 kHz, which is exactly why th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
    [cc1101_compustar.cpp, cc1101_compustar.h, voltage_monitor.ino]
2026-08-06 esp32-s3: fw 3.6 - correct TX frequency to match the FOB (SDR-verified)
    With the SDR finally streaming (it needed a direct laptop USB port; the
    hub/other ports threw libusb -9/-7/-1 errors), captured our own board and
    the genuine FOB on the same dongle and measured the real delta:
    our board (as configured): 433.874 MHz
    genuine FOB: 433.9415 MHz
    -> we were ~68 kHz LOW
    Cause: the textbook FREQ word 0x10B071 assumes a 26.000 MHz crystal, but
    this module measures 25.991 MHz (via /xtaltest), which drags the carrier
    down. Trimmed FREQ to 0x10B11C (+68 kHz); re-captured and confirmed our
    carrier now sits at 433.9418 MHz, essentially on top of the FOB
    (0.3 kHz apart), and survi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
    [cc1101_compustar.cpp, cc1101_compustar.h, voltage_monitor.ino]
2026-08-06 docs: add as-built OBD-II -> buck -> ESP32 power wiring photo + 12V sense tap
    Real-build photo of the OBD-II pigtail feeding the 12V->5V 5A buck, with the +12V rail spliced to also feed the voltage-divider sense tap (monitors the battery rail before the buck). Added to doc 13 with a right-to-left wiring description and the two safety cross-checks not visible in the photo: the inline 2A fuse + TVS belong at the splice (pin 16 is unfused battery+), and single-point ground.
2026-08-06 esp32-s3: fw 4.0 - faithful remote-start replay (wake-up carrier + 8x data)
    Root-caused why remote start never worked, using the SDR to compare our
    board's on-air transmission against the genuine FOB. Three separate
    defects, all now fixed:
    1. WRONG CODE (fw 3.7, in gitignored secrets.h). Our stored START came
    from a long-press capture (fob-start-lg20/-004), a different function
    than a normal Start tap. Normal Start presses -- May 001/002/003 and a
    fresh Aug capture that actually cranked the engine -- all decode to a
    different, stable code. Stored the correct one.
    2. NO WAKE-UP CARRIER (fw 3.9). The Compustar receiver is duty-cycled: it
    sleeps and only briefly samples the air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
    [cc1101_compustar.cpp, cc1101_compustar.h, voltage_monitor.ino]
2026-08-06 esp32-s3: fw 4.1 — match the FOB's packet timing (1 ms gap + 0.5 s trailing carrier)
    A full 60 s SDR capture of the genuine FOB (one Start + one Stop press) showed
    our fw 4.0 was a structural twin on content and packet count but wrong on two
    timings the earlier envelope analysis never checked:
    - the 8 data packets are spaced only ~1.1 ms apart (back-to-back inside the
    window the wake-up carrier just opened), not the 39 ms we were using — a
    35x-too-wide gap that can let the duty-cycled receiver drop bit-clock lock
    between packets;
    - the FOB holds a ~525 ms trailing carrier after the data; we sent none.
    transmitButtonWakeup() gains pktGapMs (default 1) and tailCarrierMs (default
    52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
    [cc1101_compustar.cpp, cc1101_compustar.h, voltage_monitor.ino]
2026-08-06 esp32-s3: fw 4.3 — remote start WORKS (fix swapped bit-gap timing + single burst)
    After matching the FOB on frequency, power, code bits, and packet structure, two
    final defects kept the Compustar brain from accepting our replay. Both were found
    by capturing our own board on the SDR and comparing to the FOB bit-for-bit.
    fw 4.2 — SWAPPED data-bit gap timing. A 1WG3R bit is a pulse plus a matching
    gap: '0' = short-HIGH + short-LOW (period ~1493 us), '1' = long-HIGH + long-LOW
    (~2243 us). Our firmware had the two LOW values swapped (short-HIGH + long-LOW,
    long-HIGH + short-LOW), making the 0 and 1 periods nearly identical (~1850 us
    each) so a receiver decoding by period/gap can't distinguis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
    [cc1101_compustar.cpp, cc1101_compustar.h, voltage_monitor.ino]
2026-08-06 esp32-s3: fw 4.4 — ETA to next auto-start; finalize docs (ESP32-only is the build)
    autoStartEtaS() projects the parked battery-drain regression down to the
    user's trigger voltage and adds the sustain hold, giving an estimated time
    until low-voltage auto-start would fire. Returns n/a when disarmed/locked, when
    the battery is holding or charging (won't reach the threshold at this rate), or
    before the drain fit settles; returns the hold remaining once already below the
    threshold. Surfaced on the dashboard (new "Est. to auto-start" card + enriched
    "watching" status line), in /json as as_eta_s, and via SNMP OID .44
    autoStartEtaSec for Cacti.
    Docs: with remote start proven and auto-start armed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
    [voltage_monitor.ino]
2026-08-06 esp32-s3: fw 4.5 — graph the battery drain rate over time
    The drain rate is a regression over a window, not a raw per-sample field, so to
    graph it like voltage/CPU it's now stored per sample: Sample gains an int16_t
    drain (mV/h, signed; 0 while the fit settles), stamped in recordSample() from
    the current fit. Added a drain_mvph column to the /history CSV and a 10th
    dashboard graph ("Battery drain rate mV/h -- below 0 = discharging") with the
    same mouseover tooltip as the others; its y-axis always keeps the 0 line in
    view so discharge reads as dipping below zero. This turns the parasitic-drain
    hunt into something you can watch trend over days.
    Bumped the persisted-history magic (VOL4->VOL5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
2026-08-06 esp32-s3: fw 4.6 — drain tile shows honest partial progress (was bare "0 of 30")
    computeDrain() early-returned n=0 whenever total histCount < DRAIN_MIN_N, which
    short-circuited the partial-window progress reporting it already had below. So
    after any event that shortens history (a reboot, or the fw 4.5 storage-format
    reset), the drain tile read "0 of 30 min needed" and looked frozen/broken even
    though samples were accumulating fine. Relaxed the guard to histCount < 1 so
    Pass 1 runs and drain_n reflects the real partial count; the n < DRAIN_MIN_N
    guard below still withholds the fitted slope until there are 30 samples.
    Verified on the board: drain_n went 0 -> 22 right after the flash and clim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
    [voltage_monitor.ino]
2026-08-06 docs: add autoStartEtaSec SNMP OID (.44); bump README status to fw 4.6
    Documents the telemetry added in fw 4.4-4.6:
    - SNMP OID reference gains .44.0 autoStartEtaSec (est. seconds to auto-start).
    - README status reflects firmware 4.6 and the new dashboard battery-drain-rate
    graph alongside the auto-start ETA.
    The /history CSV drain_mvph column and the 10th dashboard graph are
    self-documenting (CSV header + on-page label); no doc enumerated those.
2026-08-07 esp32-s3: fw 4.7 — voltage min/max lines, uptime + combined CPU load in hero
    Dashboard changes:
    - Voltage graph draws dashed max/min reference lines with labelled values,
    always visible (not just on mouseover); y-range padded ~18% so the lines sit
    inside the plot. Corner hi/lo labels suppressed on that graph to avoid dupes.
    - Hero row gains two promoted metrics: "CPU load (avg)" (mean of the two core
    loads) and "Uptime" (moved out of the small grid). Per-core CPU cards kept.
    Also recorded the diagnosis of the ~12:30 drain-rate "spike": it's a regression
    artifact, not a battery event. Two ~16-min sampling gaps (Wi-Fi stalls at weak
    -68 dBm; no reboot) reset the drain window, which re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
    [voltage_monitor.ino]
2026-08-08 esp32-s3: fw 4.8 — min/max reference lines on temp, RSSI, both CPU cores, drain
    Extends the dashed max/min lines (added to the voltage graph in 4.7) to the
    temperature, WiFi RSSI, CPU core 0, CPU core 1, and battery-drain graphs.
    Generalized the per-chart `minmax` flag with headroom padding so the lines sit
    inside each plot; drawChart already renders them and suppresses the corner
    hi/lo labels on those graphs. Network/heap/disk graphs unchanged.
    Verified the dashboard JS from local source with node --check (the board's HTTP
    server was mid-stall at flash time — a known weak-signal Wi-Fi issue, noted in
    the log; the change itself is HTML/JS-only and cannot affect the firmware loop).
    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
    [voltage_monitor.ino]
2026-08-08 esp32-s3: fw 4.9 — safety task off the loop, task watchdog, reboot button
    Reliability hardening after the board went HTTP-unresponsive post-flash (loop
    stall at weak WiFi). A hung loop also stalls evalAutoStart(), so the low-voltage
    protection would be offline until a manual power-cycle. Fixes:
    - Safety task on core 0: battery sampling (ADC) + the auto-start decision run in
    a dedicated FreeRTOS task, independent of the loop (core 1, WiFi/HTTP/SNMP).
    A weak-signal reassociation or HTTP stall can no longer starve the safety
    check. The task owns the ADC and temp sensor; everything else reads cached
    g_lastV / g_lastTemp (no cross-core peripheral contention).
    - RF mutex (g_rfMutex): au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
    [voltage_monitor.ino]
2026-08-08 docs: README status -> fw 4.9 (deployment reliability: safety task + watchdog)
    Reflects the current installed firmware: the sampling and low-voltage safety
    decision run in a dedicated FreeRTOS task off the WiFi/HTTP loop, guarded by a
    task watchdog (auto-reboot on stall), with a dashboard reboot button, plus the
    4.7/4.8 dashboard additions (min/max lines, uptime, combined CPU load).
2026-08-08 esp32-s3: fw 4.10 — /powerup endpoint (Wi-Fi power-save off + CPU 240 MHz)
    POST /powerup is a parameterless, one-shot "max performance" call (fireable
    automatically like /reboot): disables Wi-Fi power-save and sets the CPU to
    240 MHz, persisting both to NVS. Returns {"ok":true,"cpu_mhz":240,"wifi_ps":
    false}. Also adds a "power-up" link to the dashboard footer next to reboot.
    Verified on the board: knocked it to CPU 80 / PS on, fired /powerup, both
    flipped to 240 / off and stuck.
    Log (2026-08-08) also records the connectivity diagnosis: the "goes unusable
    until reboot" was not a resource leak (heap/CPU flat 19.5 h) but a combination
    of a moved DHCP IP (.238->.153; use esp32-volt.local), a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
    [voltage_monitor.ino]
2026-08-08 esp32-s3: fw 4.11 — temp-compensated drain, since-last-start, rolling /logs viewer
    - Temperature-compensated drain fit: computeDrain() is now a two-variable least
    squares (V ~ time + temperature). Chip temp explains ~55% of the parked voltage
    wobble (+5.1 mV/degC, r=0.74 over 26h), so the plain V-vs-time slope was noisy.
    The time term is now the true depletion rate with the diurnal swing regressed
    out (falls back to the plain fit when temp is flat); reports the coefficient as
    drain_mvpc. Payoff: raw ~-24 mV/h vs temp-compensated ~-4 mV/h -- most of the
    apparent drain was thermal. Trigger stays on raw voltage.
    - "Since last start" tile (elapsed) next to the last-start timestamp.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
    [voltage_monitor.ino]
2026-08-08 esp32-s3: fw 4.12 — event log lines carry full date+time (was time-only)
    logLine() now stamps each line "YYYY-MM-DD HH:MM:SS" (strftime) instead of just
    HH:MM:SS, so a log spanning days is unambiguous. Pre-NTP lines still use "+<uptime>s".
2026-08-08 esp32-s3: fw 4.14 — verbose event logging (WiFi/NTP/reset/heap), debounced
    Diagnostics into the /logs event ring, aimed at the drop-out / "goes unusable" hunt:
    - Reset reason at boot via esp_reset_reason() (power-on/software/BROWNOUT/
    TASK-WATCHDOG/PANIC/...) -- reveals a silent reboot if one is behind it.
    - WiFi events via WiFi.onEvent: assoc (channel), got-IP (IP+RSSI), and DISCONNECT
    with the reason code + name (beacon-timeout, no-AP-found, auth-expire, ...),
    lost-IP. Disconnect logging is DEBOUNCED -- out of range the driver retries
    every few seconds, so it logs the first, suppresses identical repeats for 2 min,
    and reports the suppressed count, instead of flooding the ring.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
    [voltage_monitor.ino]
2026-08-08 esp32-s3: fw 4.16 — engine on/off via voltage, 1000-line PSRAM log, min/max on all graphs
    NOTE: committed as source-of-truth; compiles clean and DRAM verified (global vars
    back to 18%), but NOT yet flash-verified on hardware -- the OTA to the board timed
    out over its weak -70 dBm WiFi link, so the board is still running last-good 4.14
    (it never ran 4.16, so 4.16 is not implicated in the WiFi flap that followed).
    - 4.15: voltage-derived engine on/off ("Last charge (ran)") -- logs ENGINE ON/OFF
    from the alternator-charging threshold (>=13.2 V, 0.3 V hysteresis) whoever
    started it (key/FOB/board), persists last_run (NVS), shown next to "Last start
    (cmd)" so a start command with no char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
2026-08-08 esp32-s3: fw 4.20 — tabbed dashboard, flash-persisted log, WiFi telemetry
    Covers the 4.17→4.20 arc (accumulated while OTA was gated on a weak link;
    verified live on the board before committing):
    - 4.17: event log persisted to LittleFS (rolling /log.txt + /log.old, ~96 KB
    cap), replayed into the PSRAM ring on boot so /logtext survives reboots. All
    flash I/O drained from the loop core via a seq cursor; logLine() stays in the
    spinlock-only fast path.
    - 4.18: tried 802.11b-only for range — backfired on this AP (1.7 s/20% loss +
    TASK-WATCHDOG reboot loop). Reverted.
    - 4.19: explicitly restore b/g/n (esp_wifi_set_protocol persists to NVS, so the
    revert must overwrite the stored b-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
    [voltage_monitor.ino]
2026-08-08 docs: log known issue — occasional TASK-WATCHDOG resets tied to WiFi-loss
    Post-4.20 finding from the persistent boot log: the tight 85s reboot loop
    (4.18 11b misstep) is gone, but isolated TASK-WATCHDOG resets remain (4.19
    16:26/16:38, 4.20 17:02), correlated with the board being off home WiFi
    (AP fallback during a drive). Self-recovers in ~30s; fix deferred per user.
2026-08-09 esp32-s3: fw 4.23 — server-side log paging, WDT breadcrumbs, CPU-route fix, drain cap
    Verified live on the board (the 4.23 OTA stuck at -70 dBm):
    - 4.21: server-side log pagination. New /logpage?p=N returns the total then only
    that page's 25 newest-first lines; /logs fetches one page per view (~1.5 KB vs
    the whole ring) — a quick log stays cheap on a flaky link. /logtext unchanged.
    - 4.21: WDT-culprit breadcrumbs. loop + safety tasks stamp their current phase
    into RTC_NOINIT memory (survives the reset); next boot logs
    "^ WDT stall: loop was 'X', safety was 'Y'" so the stuck task names the op.
    - 4.22: fix /cpu route shadowing (regression from the 4.20 tab split). The CPU
    tab wa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
    [voltage_monitor.ino]
2026-08-09 docs: drop hardcoded paths to the (moved) esp32 toolchain folder
    The sibling arduino-cli toolchain folder moved off local disk, and these were
    the only two spots in the repo pointing at it by absolute path (both stale):
    - voltage-monitor.md: the flash snippet hardcoded the arduino-cli/.yaml paths and
    pointed $dir at the OLD sketch location (…\esp32\esp32-s3\…, pre-vroom). Now a
    portable recipe: arduino-cli on PATH, sketch at .\esp32-s3\voltage_monitor.
    - make_wiring.py: wrote its PNG into the sibling folder via an absolute path. Now
    writes next to the script (vroom/esp32-s3/docs/) via os.path + __file__.
    Note: voltage_monitor.ino's Part-B change (WDT feed in streaming handlers +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
2026-08-11 chore: pin line endings to LF via .gitattributes
    This tree lives on a CIFS share that is also reachable from Windows. A
    Windows-side editor rewrote 29 tracked files to CRLF, which git reported
    as a ~9,400-line diff that was entirely whitespace -- and which buried a
    real uncommitted firmware change underneath it.
    `* text=auto eol=lf` makes git normalize to LF on commit and check out LF
    on every platform, so a Windows-side rewrite can no longer produce diff
    noise. Binary assets are marked explicitly so they are never normalized
    or diffed as text.
    The 29 affected files were converted back to LF in the working tree
    first, so this commit contains no content changes -- `git add
    --renormalize .`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
2026-08-11 esp32-s3: fw 4.24 — feed the WDT during slow-client sends
    The chunked-send loops in /history, /logtext, /logpage and /starts can
    span many seconds against the car's ~-70 dBm link, and none of them fed
    the task watchdog while sending. That made a legitimately slow send
    indistinguishable from a stall, so the ~30 s WDT could panic-reboot the
    board in the middle of a response.
    This is a plausible contributor to the isolated TASK-WATCHDOG resets
    logged against fw 4.19/4.20, which correlated with WiFi disruption --
    exactly when sends are slowest. All four loops now call
    esp_task_wdt_reset() between chunks, which is what the OTA handler
    already does for the same reason.
    Safe: these handlers run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
    [voltage_monitor.ino]
2026-08-11 docs: record 2026-08-11 field diagnosis off the installed board
    Live telemetry (fw 4.23) rather than a release. Three findings that
    change priorities:
    1. Auto-start can be prevented from EVER arming. Park-confirm needs
    900 s and a reboot resets it to zero; observed watchdog resets were
    42, 39 and 17 minutes apart. Under ~15 min apart the low-voltage
    protection never arms, and nothing surfaces that. Same silent-
    protection-loss class the 4.9 hardening was written to prevent --
    the watchdog that prevents it can now cause it, because recovery
    costs a full park-confirm window.
    2. The WiFi instability is the AP, not the board or the antenna. One
    BSSID seen on channels 5->4-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
2026-08-11 docs: fw 4.24 is compile-verified; record the Linux toolchain rebuild
    4.24 now builds clean against esp32 core 3.3.10 -- the same core that
    produced 4.23, so the two differ only by the source change. 1,197,408
    bytes (38% of the 3 MB app slot), globals 61,512 (18% DRAM), and "4.24"
    confirmed present in the output binary. Still not flashed; board remains
    on 4.23.
    The FQBN came from the 4.23 build's own build.options.json, not the
    docs, which disagree: esp32-s3/docs/voltage-monitor.md claims
    PartitionScheme=custom but the real build used app3M_fat9M_16MB. Worth
    correcting separately -- a wrong partition scheme on a 16 MB OTA board
    is what bricks an update.
    Toolchain notes recorded because the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
2026-08-11 esp32-s3: fw 4.25 — GET /scan as a WiFi antenna health check
    The board reads -66..-75 dBm with the car TEN FEET from the AP, where
    free-space loss alone predicts about -30 and the car body should still
    leave -45..-55. That is a 20-30 dB deficit, and the bench reading before
    installation was -43 -- so the antenna path is the leading suspect for
    the whole WiFi saga, and the flapping/OTA failures/watchdog reboots look
    like consequences rather than causes.
    The ESP32 gives you nothing direct to test that with: no VSWR, no
    reflected power, no antenna-detect pin, and DC resistance is meaningless
    on an antenna that is open or near-short by design. A scan is the
    closest available substitute, and i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
    [voltage_monitor.ino]
2026-08-11 esp32-s3: fw 4.25 — persist a scan-start marker before blocking
    /scan blocks for seconds inside the HTTP handler. logLine() only writes
    the RAM ring; flash persistence happens in loop(), which cannot run
    while the scan is blocking -- so a brownout or non-WDT reset mid-scan
    would have left NO trace that a scan was ever in flight.
    Now it logs "scan: starting" and calls flushLogToFlash() explicitly
    before the blocking call, the same way the OTA handler persists pending
    lines before it reboots.
    This completes the coverage. Reboot during scan was already caught by
    4.24's breadcrumb (trackReq() stamps "/scan", so the next boot prints
    "WDT stall: loop was '/scan'"), and a disconnect after the s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
    [voltage_monitor.ino]
2026-08-11 docs: fw 4.25 flashed — antenna cleared, weak AP identified
    OTA landed at -77 dBm (1,199,367 bytes, 21.5 s, clean software reset).
    /scan then settled the question the WiFi work had been circling.
    THE ANTENNA IS FINE. The board sees 14 APs from -64 down to -96 dBm. A
    disconnected or buried antenna costs 20-30 dB and would leave it hearing
    two or three APs with nothing below about -80; receiving -96 proves the
    front end is healthy. The earlier suspicion -- that -74 dBm with the car
    ten feet away indicted the antenna -- was wrong.
    WHAT IS WEAK IS THE IoT AP. Same receiver, same instant, from the car:
    the user's ch10 router reads -64/-64/-65 while IoT reads -75. An 11 dB
    gap between two of t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
2026-08-11 esp32-s3: fw 4.26 — runtime-configurable WiFi (STA, AP fallback, timers, radio)
    secrets.h now only SEEDS the WiFi config on first boot instead of
    dictating it. Everything is editable from a new section on the WiFi tab
    and persisted to NVS: home SSID (with a scan-assisted picker), password,
    minimum accepted security; fallback AP SSID/password/security/channel/
    hidden; the timers (raise-AP-after, retry-home-every, per-retry wait,
    boot connect window); and radio TX power, protocol and hostname.
    THE SAFETY DESIGN IS THE POINT. This board is behind a dash and can
    start a car. A mistyped SSID or password would strand it on its fallback
    AP -- and there was nothing you could DO from that AP, so r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
2026-08-11 esp32-s3: fw 4.27 — bound per-write stalls; 4.24 did not fix /history
    The field log on 4.26 still showed "WDT stall: loop was '/history',
    safety was 'idle'" -- so fw 4.24 did NOT fix this. The 4.24 breadcrumb
    is what localised it: on 4.23 the same line read a generic 'http'.
    WHY 4.24 FAILED. It fed the watchdog BETWEEN chunks. The stall is inside
    a SINGLE write. NetworkClient::write() retries up to
    WIFI_CLIENT_MAX_WRITE_RETRY (10) times, each a 1 s select() plus a
    send() bounded by SO_SNDTIMEO -- which WebServer sets from
    HTTP_MAX_SEND_WAIT = 5000 ms. One write against a stalled client can
    therefore block ~10 x (1 + 5) = 60 s, twice the 30 s watchdog, and the
    esp_task_wdt_reset() sits AFT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
    [voltage_monitor.ino]
2026-08-12 esp32-s3: fw 4.28 — non-blocking send gate, long-term drain ETA, external starts
    THE STALL FIX, THIRD AND CORRECT ATTEMPT. 4.27 did not work either --
    three more "WDT stall: loop was '/history'" overnight. The mechanism:
    NetworkClient::write() retries up to 10 times, each with a HARDCODED 1 s
    select() (WIFI_CLIENT_SELECT_TIMEOUT_US) that no setting can change, so
    one write has a ~10 s floor regardless of SO_SNDTIMEO -- and
    sendContent() issues several writes per chunk. 4.24 fed the watchdog
    after a call that never returned; 4.27 shrank a timeout that was never
    the binding constraint.
    The fix is to never ENTER a blocking write. waitWritable() polls the
    socket with select() in 50 ms slices,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
    [voltage_monitor.ino]
2026-08-12 esp32-s3: fw 4.29 — anchor the long-term baseline to the vehicle, not the boot
    4.28's bootstrap anchored the reference at the moment the BOARD booted,
    which on a device that reboots means the baseline restarts every time --
    defeating the whole purpose of the feature, which exists precisely to
    escape that. The anchor must be tied to the CAR's last run.
    The target is now last_run + LT_SETTLE_S (12 h after the engine stopped,
    past the fast fluctuating settle). If that moment has already passed it
    does not wait for a new cycle: the 24 h history ring is written through
    to flash by saveHistory() and SURVIVES REBOOTS, so the voltage at that
    time is usually still on record. seedLongTermFromHistor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
    [voltage_monitor.ino]
2026-08-12 esp32-s3: fw 4.30 — cycle + last-auto-start cards; every ETA uses the anchor
    Two cards on the Voltage tab:
    - "Last run -> next auto-start": the whole projected cycle, elapsed since
    the vehicle last ran plus the remaining estimate. Verified against
    /json independently (3.7 days elapsed + 4.8 remaining = 8.5 total).
    - "Last auto-start": as_last, which is written ONLY by the auto-start
    fire path, so it can never be confused with a dashboard button press
    or a key/FOB start.
    autoStartEtaS() now prefers the long-term anchor. It was still computing
    from the 24 h least-squares fit, which fed the Main tab card, the
    dashboard status line AND SNMP OID .44. That fit is a short window, it
    rest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
    [voltage_monitor.ino]
2026-08-12 esp32-s3: fw 4.31 — real dates, cycle progress % and bar on the Voltage tab
    4.30 shipped every forward-looking value as a countdown when the request
    was for a DATE. Corrected:
    - "Next auto-start" and "Last auto-start" are now actual calendar dates
    (Wed 19 Aug 06:21), via a shared fmtDate() helper.
    - "Last run -> next auto-start" shows the duration AND both endpoints
    (Sat 8 Aug 16:52 -> Wed 19 Aug 06:21).
    - Percent elapsed through the cycle with a progress bar: green under
    60%, amber to 85%, red beyond. Validated against an independent
    calculation -- card read "50% elapsed", bar 50.3% wide, computed
    50.3%.
    Note on stability: the estimate refines as the baseline grows and the
    per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
    [voltage_monitor.ino]
2026-08-12 esp32-s3: fw 4.32 — smoothed long-term fit; task watchdog 30 s -> 5 min
    SMOOTHING. Both ends of the long-term fit were single ADC samples. The
    rate is (vNow - refV)/hours, and with the anchor only ~30 mV from the
    present reading a one-LSB wobble (~5.5 mV at the battery) is a large
    fraction of the signal -- and that rate is the DENOMINATOR of the ETA.
    Measured on 4.31 across consecutive polls: v=12.30 -> -0.840 mV/h ->
    Mon 17 Aug -> 43.2%, and v=12.29 -> -1.260 mV/h -> Sat 15 Aug -> 56.2%.
    10 mV of quantisation halved the rate and slid the date four days.
    Both ends now use a 120-sample (2 h) mean; the anchor averages 120
    samples forward instead of trusting one. NVS schema bumped to 3 so th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
    [voltage_monitor.ino]
2026-08-12 esp32-s3: fw 4.33 — recommended trigger 12.4 V -> 12.2 V
    The board has run 12.2 V from NVS all along while the firmware kept
    recommending 12.4 V, so every status report flagged a discrepancy that
    was never going to be actioned.
    This is measurement-led, not a relaxation. The cold-weather case for
    12.4 V is sound in general and stays in the source comment: near -20 C
    the engine needs roughly double the cranking torque while the battery
    delivers about half its power, and 12.2 V rested (~SG 1.19) slushes
    around -26 C where 12.4 V (~SG 1.23) is good to about -37 C.
    It is the wrong number FOR THIS CAR. The battery settles at about
    12.30 V after days parked, so a 12.4 V trigger sits ABOVE its r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
    [voltage_monitor.ino]
2026-08-14 esp32-s3: fw 4.34 — live sustain countdown on Main; every reset explained
    LIVE COUNTDOWN. When voltage drops below the threshold a banner appears
    immediately on the Main tab with remaining time, a progress bar, and the
    elapsed/required seconds against the current and threshold voltages.
    It ticks every second WITHOUT polling the board every second. The
    dashboard polls /json every 2 s and that was left alone deliberately --
    weak link, small socket pool, and a day already lost to socket-related
    failures. The seconds are interpolated locally and resynced to the
    board's authoritative as_low_s on every poll, so the display can never
    drift from the device by more than one poll.
    On recovery the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
    [voltage_monitor.ino]
2026-08-14 esp32-s3: fw 4.35 — tooltips everywhere, log flap consolidation, UI spacing
    TOOLTIPS. Every visible card, hero metric and badge now explains what it
    means, what it says right now, and what would change it. Rebuilt each
    poll so they quote live values, discoverable via a dotted underline on
    the label, and they fire on tap for phones. 17 elements on Main.
    The prompt was "Lockout", which showed two words and nothing else. It
    now explains that it latches after 2 consecutive automatic starts that
    drew no charge, reports the live fail streak, and says what would trip
    it or how to clear it.
    LOG FLAP CONSOLIDATION. A value dithering at a threshold emits the same
    one- or two-line pattern endlessly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
    [voltage_monitor.ino]
2026-08-14 docs: the 4.35 hold change was deliberate, not an NVS fault
    The 4.35 entry recorded the hold reading 300 s before the flash and 60 s
    after as an open question. Confirmed by the owner as a deliberate change:
    NVS persistence is working correctly and there is no bug to chase.
    The gap it exposed still stands -- auto-start config changes reach NVS
    and Serial but not the flash log, so the device could not answer a
    question about its own configuration and time went into ruling out a
    fault that never existed.
2026-08-14 esp32-s3: fw 4.36 — build stamp; hourly drain buckets across the whole park
    BUILD STAMP. Footer now reads "fw 4.36 . built Aug 14 2026 12:12:11"
    from __DATE__/__TIME__, also in /json as "build". Two flashes can share
    a version during development, so the stamp is what identifies what is
    actually running on a board in the field.
    HOURLY DRAIN BUCKETS replace the two-point anchor. The 24 h ring cannot
    see a multi-day drain; the 4.29 anchor spanned days but was hostage to
    noise at either end. Now one bucket per hour for the whole park, each
    the mean of ~60 samples, regressed across all of them.
    - Persisted to LittleFS (12 B/hour, ~62 days), restored at boot, so a
    reboot no longer resets the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
    [voltage_monitor.ino]
2026-08-14 docs: retract the "wrong partition scheme" note — the docs were right
    The fw 4.24 entry claimed esp32-s3/docs/voltage-monitor.md was stale for
    specifying PartitionScheme=custom, on the grounds that the real build used
    app3M_fat9M_16MB. That had it backwards, and it pointed at the change that
    destroys the filesystem.
    Verified against the installed board:
    disk_total 10354688 = 0x9E0000 matches voltage_monitor/partitions.csv
    LittleFS.begin(true) default partition label "spiffs"
    partitions.csv names the data partition "spiffs", which is the label
    LittleFS.begin() mounts. Stock app3M_fat9M_16MB names it "ffat", subtype
    fat. The two schemes have identical app geometry (a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
2026-08-14 esp32-s3: fw 4.37 — tiered sample storage, RTC RAM -> journal -> hourly archive
    saveHistory() rewrote the entire 1440-sample ring (46,092 bytes) to
    /history.bin every 600 s. Measured:
    before after
    bytes/day 6.64 MB 46 KB (144x)
    commits/day 144 48
    block erases/day ~1728 ~24 (72x)
    history lost/reboot up to 10m nothing
    Being straight about why: flash wear was NOT the failure mode. Spread over
    the partition's 2528 blocks that is 0.68 erases per block per day, about
    400 years to a 100k-cycle limit — the car loses that race. The rewrite was
    worth killing for the last row. This board has taken a lo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
    [voltage_monitor.ino]
2026-08-14 esp32-s3: fw 4.38 — migrate the file 4.37 renamed without a migration
    4.37 renamed the hourly bucket file /drain.bin -> /hourly.bin and shipped
    no migration for it. The upgrade orphaned the old file and dropped the
    buckets it held. Caught on the live board within seconds of flashing:
    hr_buckets went 1 -> 0, and with no file-management endpoint the stray
    /drain.bin could not be removed remotely.
    loadDrainFromFlash() now adopts a pre-4.38 /drain.bin when /hourly.bin does
    not exist yet, and deletes it otherwise. Either way the stray goes.
    The damage was one bucket and ~12 bytes, because the archive had barely
    started accumulating. The lesson is worth more than the damage: the same
    release c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
    [voltage_monitor.ino]
2026-08-14 esp32-s3: fw 4.39 — 4.37's migration never reached flash; 24 h of history lost
    4.37's /history.bin migration read the old snapshot into the RAM ring and
    then deleted the file, without ever writing those samples to the journal.
    The Serial line claimed "history: migrated /history.bin -> append-only
    journal"; it had not. Only samples taken after boot were journaled.
    The 1440 migrated samples therefore existed solely in volatile PSRAM. They
    survived as long as 4.37 ran and died at the next reboot, which was the
    4.38 flash. ~24 h of voltage history was destroyed and is not recoverable:
    LittleFS has no undelete and the source file was already gone.
    Caught immediately after the 4.38 boot:
    sa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
    [voltage_monitor.ino]
2026-08-14 esp32-s3: fw 4.41 — week/month chart ranges, aggregated on the board
    Adds a 24 h / 7 d / 30 d selector to all four chart pages, persisted in
    localStorage, with the existing dashed min/max lines applying to every
    span.
    The transport is the point. A month of raw samples is ~44,600 rows and
    about 1.8 MB. /history at 24 h was already the largest transfer on the
    device (~36 KB) and it was refetched every 30 s — ~4.3 MB/h with a chart
    page open, and the original cause of the /history watchdog stalls.
    /agg?span=day|week|month divides the window into a fixed number of buckets
    and sends only the mean of each:
    day 24 h 288 x 5 min from the raw ring ~4.5 KB
    week 7 d 168 x 1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
    [voltage_monitor.ino]
2026-08-14 esp32-s3: fw 4.42 — hovering a sparse graph finds the nearest reading
    Reported after flashing 4.41: only the 24 h range appeared to have
    per-datapoint mouseover. The tooltip was working. There was almost nothing
    to hover: the week view holds 2 populated buckets out of 168, so an exact
    bucket hit was required across a graph that is 99% empty, and showTip
    correctly hid itself everywhere else. Correct behaviour, unusable result.
    - Hover snaps to the nearest populated bucket. Unbounded on purpose: the
    crosshair and dot move to whatever it landed on, so which reading is
    being shown is never ambiguous. Far-left hover on a week graph now
    reports bucket 166 instead of nothing.
    - A series wi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
    [voltage_monitor.ino]
2026-08-14 esp32-s3: fw 4.43 — the auto-start fire path had no record that survives
    Auto-start has never fired in this vehicle and is expected to trigger within
    a day. Checking the fire path ahead of that: every outcome went to
    Serial.printf and nowhere else, and the board sits in a car with nothing
    attached to serial.
    *** AUTO-START FIRED at %.2f V (tx %s) *** Serial only
    start verified: engine running (charging seen) Serial only
    auto-start: no charging after 180 s -- fail N of 2 Serial only
    *** auto-start LOCKED OUT *** Serial only
    /logtext would have shown "LOW-V countdown STARTED" and then nothing at all
    about the fire or whether the engine caugh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
    [voltage_monitor.ino]
2026-08-15 esp32-s3: fw 4.44 — adjustable lockout limit, after the first real auto-start
    Auto-start fired for the first time on 2026-08-15. The first attempt drew
    no crank at all; the retry 35 minutes later started the engine in 19 s.
    09:10:39 FIRED at 12.14 V, tx=ok
    09:13:39 FAILED: no charging after 180s -- fail 1 of 2
    09:45:27 FIRED at 12.16 V, tx=ok
    09:45:46 ENGINE ON: alternator charging at 13.29 V
    10:11:28 ENGINE OFF: charging ended at 12.89 V after 25m 41s
    The starter never engaged on the first attempt. Raw samples either side:
    12.14 V at 09:09:42, then 12.17 V at 09:10:42 — three seconds after the
    burst and HIGHER than before it. Cranking pulls 150-250 A and would drag
    this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
    [voltage_monitor.ino]
2026-08-15 esp32-s3: fw 4.45 — separate, adjustable retry gap for starts that drew no charge
    as_cool was governing two opposite situations. After a VERIFIED start the
    engine is running, and firing again would toggle it off (the 1WG3R start is
    a toggle) and waste fuel — a long gap is right. After an UNVERIFIED start
    there is positive evidence the engine is NOT running, so a further burst
    cannot toggle anything off and waiting a full cooldown only drains the
    battery.
    POST /autostart?retry=N (60-86400 s, NVS as_retry, default 300 s), with a
    "Retry after no-start" dashboard field. /json reports as_retry and also
    as_gap — the gap actually in force. Selection is on g_asFails > 0, which is
    non-zero exa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
2026-08-15 esp32-s3: fw 4.46 — a dedicated run history, kept for years
    The event log answers "what happened recently" and rotates at 48 KB x 2 —
    under a fortnight on this board. "How long does this car sit between runs,
    and how often does a start not take?" needs months. Different retention
    problems, so now different stores.
    /runs.bin + /runs.old, 16 B per event, two generations of 2000 — roughly
    4000 events, or years at the handful per day this car produces. Records
    start commands (with whether the CC1101 accepted the burst), engine on
    attributed auto/manual/key-FOB, engine off with run length, and failed
    attempts. The attribution is what makes "time between manual and auto
    starts" answerable m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
    [voltage_monitor.ino]
2026-08-16 esp32-s3: fw 4.47 — click any graph for a full detail view, and a year of history
    Clicking any graph now opens it larger with its own range selector
    (24 h / 7 d / 30 d / 1 y), a min/max envelope band, dashed window extremes
    labelled in-graph, a stat row, and a per-point tooltip carrying everything
    the board recorded for that bucket:
    12.31 V | Sun, 15 Feb 2026 | mean over 1 day
    low 12.19 V - high 12.40 V | spread 0.21 V | 75% of the way up this
    range | 181d 12h ago
    The popup is built in JS and appended at load, so all four chart pages get
    it without touching any page template.
    A year needed data that did not exist: the hourly archive covers ~125 days
    across two generations. There i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
2026-08-16 esp32-s3: fw 4.48 — the detail popup's tooltip was painting behind it
    Reported after 4.47: hovering inside the detail popup produced tooltip
    content belonging to the page underneath, wherever the pointer moved.
    #tip is z-index 50; the popup overlay is 60. The tooltip was rendering
    BEHIND the backdrop, so what showed through the 82%-opaque overlay was the
    layer beneath — which is exactly what it looked like. #tip is now 80, and
    the ordering is written down where the popup is defined so it cannot drift:
    page < #gmod (60) < #tip (80)
    Second, smaller cause: the delegated data-tip handlers fire on every
    document mousemove/mouseover, including over the popup, so a card tip from
    the page b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
    [voltage_monitor.ino]
2026-08-17 esp32-s3: fw 4.49 — countdown flapping collapses to two lines per 30 minutes
    The 4.35 flap consolidation keys on the full line text including voltages,
    so 12.19 V and 12.20 V are different strings and the repeat count never
    accumulates. A battery dithering across the trigger filled the 1000-line
    ring with near-identical STARTED/RESET pairs and buried everything else.
    The countdown no longer logs per event. Events accumulate into a 30-minute
    window that emits exactly two lines, one per kind, with voltages as a range
    so different values fold together instead of splitting:
    countdown: 10 starts/30m, 12.18-12.20 V (trigger 12.20, need 60s)
    countdown: 15 resets/30m, 12.19-12.22 V, max 30s/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
    [voltage_monitor.ino]
2026-08-17 esp32-s3: fw 4.50 — OTA was resetting the board; boot lines were six hours out
    A dozen consecutive uploads failed at wildly varying byte counts (66 KB,
    97 KB, 597 KB, 809 KB, sometimes the full 1.28 MB with no reply). The cause
    was in the log the whole time:
    2026-08-17 12:36:55 boot: fw 4.48, CPU 80 MHz, reset=interrupt-watchdog
    Not the task watchdog — the INTERRUPT watchdog, which fires when interrupts
    stay disabled too long. Update.write() erases 4 KB sectors with the cache
    off, and on the S3 that stalls both cores. Two things made it worse:
    - Core 0 was still touching the filesystem mid-OTA. recordSample() calls
    LittleFS.usedBytes() for disk_kb every 60 s and the loop runs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
    [voltage_monitor.ino]
2026-08-17 docs: retract the 4.50 RF "correction" — the link really was degraded
    The 4.50 entry claimed the 4.49 RF diagnosis had been a mistake. It was not.
    The link was genuinely degraded, on the laptop rather than the car: the
    owner moved MOBILE off 5 GHz and it cleared. Measured afterwards on the
    healthy link, loss to the gateway is 0% at 540 Mbit/s, against 46.7% during
    the failures.
    Two errors produced the bad retraction:
    - The inference ran backwards. Identical loss to the board, the gateway
    AND a wired host was read as "the measurement must be broken". Those
    three paths share a first hop — the laptop's own Wi-Fi — so identical
    loss across all of them is the strongest avail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
2026-08-17 esp32-s3: fw 4.51 — one drive was logged as fourteen runs
    The 2026-08-17 drive verified the run history's live path: 32 events with
    flags=0 (not reconstructed) and src=2 (key/FOB), proving runLog() -> queue
    -> flushRunsToFlash() from the safety task. That was the last unproven
    piece of 4.46.
    The data it produced was wrong, though. One continuous drive, 13:21:24 to
    14:57:30, was recorded as FOURTEEN separate runs, several lasting 1-2
    seconds:
    13:22:01 OFF 12.77 V ran 37s
    13:22:09 ON 14.16 V (+8s)
    13:22:26 OFF 12.66 V ran 17s
    13:22:28 ON 13.48 V (+2s)
    14:13:11 ON 13.29 V
    14:13:12 OFF 12.52 V ran 1s
    The detector had voltage hysteresis but no time hyste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
    [voltage_monitor.ino]
2026-08-19 esp32-s3: fw 4.53 — the drain rate now also reads as % of battery per day
    The Long-term rate card showed "-5.57 mV/h" and nothing else. Millivolts
    per hour only means something to someone who already knows the
    conversion. It now reads:
    LONG-TERM RATE
    -5.57 mV/h · 12.8 %/day
    Computed in the browser from vbatt and lt_mvph, both of which /json
    already carried, so this costs ZERO extra bytes on the wire. The link is
    poor enough that that mattered more than the convenience of assembling it
    on the board.
    The card also gained a tooltip that shows its working, because 12.8 %/day
    is an alarming number and should be auditable rather than believed:
    -134 mV/day, flat in ~7.7 days, charge now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
2026-08-19 esp32-s3: fw 4.55 — %/day on the short-term card, and a caption that was wrong
    Puts the 4.53 conversion on the 24 h "Battery drain rate" card as well:
    BATTERY DRAIN RATE PROJECTED TO 11.8 V
    -6.3 mV/h · 14.3 %/day 4.9 days
    Dimmed to #6e7681 when r2 < 0.6, so a figure the fit cannot support
    visibly recedes rather than reading as confidently as a good one.
    The pairing is worth more than the convenience. The two cards are
    independent fits over different spans, and they currently read 14.3 %/day
    (24 h least-squares) against 12.5 %/day (long-term anchor). Agreement at
    that level says far more about the ~280 mA parasitic drain than either
    card does alone.
    I ALSO HAD THE W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
    [voltage_monitor.ino]
2026-08-19 esp32-s3: fw 4.56 — %/day gets its own line instead of wrapping mid-phrase
    4.53 hung the %/day off the end of the value as an inline span. On the
    Long-term rate card that rendered as:
    -5.49 mV/h · 12.7
    %/day
    Splitting a number from its unit, which is about the worst place a line
    can break. Two causes, both in .card .v: it carries word-break:break-word,
    and the grid track is minmax(158px,1fr), so a 165 px card cannot hold a
    19 px value plus a 14 px suffix on one line.
    Now a real second line rather than a span squeezed onto the first:
    .card .sv{color:var(--mut);font-size:13px;font-weight:600;
    margin-top:4px;line-height:1.2;white-space:nowrap}
    The inte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
2026-08-19 esp32-s3: fw 4.57 — engine-off edge 12.90 V -> 13.10 V, surface charge straddled it
    A run that ended at 12:57 today had still not closed 37 minutes later.
    The off edge was AS_ALT_V - 0.3 = 12.90 V, which sits inside the band a
    freshly-charged battery rests in. After two drives the voltage plateaued
    at 12.91-12.99 V — surface charge, not depletion — so the detector never
    saw the engine stop:
    12:57 engine actually stops
    12:58 13.11 V -> detector: still running
    13:06 12.98 V -> still running
    13:20 12.94 V -> still running
    13:34 12.90 V -> still running, 37 min after shutdown
    Left alone it self-clears once surface charge decays, but the OF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
2026-08-19 docs: put the measurements into the documentation
    No firmware change. Everything the board has actually recorded lived only
    in commit messages and the changelog — the docs a user reads were still
    pure prediction. Three now carry results.
    docs/power-budget.md gains section 7, "Measured results". It predicted
    -1.2 to -1.9 mV/h for car + board as designed; the installed board
    measures -6.3 mV/h (24 h least-squares, r2 0.80) and -5.5 mV/h (long-term
    anchored), two independent fits agreeing at ~280 mA. Its own section 6
    already said what that means: "worse than -2.5 mV/h -> the fault is
    present."
    Also documented there, all from real recordings: drain as %/day and why
    it beats mV/h (the rested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
2026-08-19 esp32-s3: fw 4.58 — a reboot no longer loses the end of a run
    engRunning was a plain function-static, so it zeroed on every boot. Two
    ways that lost data:
    * Reboot or OTA while the engine runs -> the ON never gets its OFF, and
    the next start appends a SECOND ON. The log reads ON, ON, OFF and the
    first run has no duration at all.
    * Reboot just after a run -> the ON is orphaned permanently, because
    nothing ever re-examined it. 4.57 created exactly one of these.
    engRunning/engOnMs are now file-scope, and reconcileOpenRun() runs once
    per boot as soon as the clock is valid and there is a real reading:
    no open run nothing, the normal case
    open + v >= 13.2 V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
    [voltage_monitor.ino]
2026-08-19 docs: document the run log, which had no user-facing docs at all
    No firmware change. The run log had zero documentation — not the feature,
    not the /runs endpoint, not the badges, not the field encoding. A user
    could see the table on the Logs tab with no way to know what src meant or
    why some rows carry a marker.
    esp32-s3/docs/voltage-monitor.md gains section 7b, "The run log":
    * What it records, and why it is separate from the event log — how long
    does this car sit between runs, and which runs did the board fire?
    * The /runs?n= CSV with the full encoding of kind, src, flags, dur_s.
    * src is the useful column: detection is from alternator voltage, so the
    log is a complete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
2026-08-23 esp32-s3: fw 4.68 — Debug tab with a BLE scanner
    New /debug page and GET /btscan. The radio is off in normal operation and
    this is the only thing that turns it on: bring the stack up, scan, tear it
    down, display. Nothing stored, connected to, or paired. Shows name,
    address, public/random, RSSI and advertised service UUIDs — enough to
    recognise a specific dongle, which is the point.
    The caveat is on the page in bold because it decides how a result should
    be read: THE ESP32-S3 HAS NO BLUETOOTH CLASSIC RADIO AT ALL. A Classic
    (SPP) device is invisible here, so an empty result does not mean nothing
    is there. This can prove "it IS BLE"; it can never prove "it is not".
    The scan runs on its o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
2026-08-23 docs: document the Debug tab's BLE scanner
    esp32-s3/docs/voltage-monitor.md gains section 7c, covering the three
    things a user needs and cannot infer from the page alone.
    It is BLE only. The ESP32-S3 has no Bluetooth Classic radio, so a Classic
    (SPP) device cannot appear no matter what, and an empty result does not
    mean nothing is there. Documented explicitly because the obvious use is
    identifying an OBD-II dongle: most cheap ELM327 clones are Classic, the
    BLE ones exist because iOS will not do arbitrary SPP, and the scanner can
    prove a device IS BLE but never that one is not.
    Expect about two scans per boot, and why. Bringing the stack up and down
    fragments the heap and does not undo it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
2026-08-25 esp32-s3: fw 4.71 — fix "could not start", and a better answer than rebooting
    THE REPORTED BUG WAS NOT FRAGMENTATION.
    The page showed "could not start" with no detail, on a two-minute-old boot
    with 187 KB free. handleBtScan() spawned the scan task and THEN called
    server.send(), so BLEDevice::init() was bringing the radio up, on the same
    core, while the 202 was still trying to go out. A response that should be
    instant measured 2.76 s; when it outlasted the browser the page saw a dead
    socket and reported failure for a scan that was running perfectly.
    The handler answers first and spawns second now, and the task waits 150 ms
    before touching the radio so the reply drains. Task-creation failu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
    [voltage_monitor.ino]
2026-08-25 docs: BLE scanner — keeping the radio up beats rebooting
    Section 7c said a reboot was the fix for fragmentation. There is a better
    one, so the section is rewritten around the distinction that actually
    matters: bringing the stack up and down is what fragments the heap;
    scanning is much cheaper.
    Adds the measured comparison — six scans back to back with the radio kept
    up, all completing, against about two when the stack is rebuilt each time,
    with the per-scan block figures and the recovery on Radio off. Framed as
    an improvement rather than a cure, because the block still steps down.
    Documents the observable state (/json now carries heap_block and bt_up) so
    fragmentation can be watched wi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
2026-08-26 esp32-s3: fw 4.72 — the radio drops itself, and honest advice when it is too late
    THE FRAGMENTATION NEVER RECOVERS. That is stronger than previously written
    and it is the failure reported from the page.
    The board sat overnight with no BLE activity for 16 hours and still
    refused a scan: 184 KB free, largest block 55 KB. Two scans the previous
    afternoon had taken it 147 KB -> 57 KB and it simply stayed there. So it
    is not "uptime fragments the heap" — the BLE fragmentation is permanent
    for the life of the boot, and normal operation neither worsens nor heals
    it. Once you are below the limit only a reboot helps; waiting will not.
    The refusal message used to say "tick 'keep the radio up' be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
    [voltage_monitor.ino]
2026-09-14 esp32-s3: fw 4.73 — a BLE connect test, and the Veepeak passes it
    The scanner could prove a device was advertising, never that the board could
    use it. For the Veepeak BLE OBD-II dongle now in the car's Y-splitter that is
    the question that matters, so every scan row gets a Test button backed by
    GET /btconnect: connect, discover, pick the serial pair (notify for replies,
    write for commands), subscribe, send ATZ ATE0 ATI ATRV, collect each reply up
    to the '>' prompt, disconnect, report a verdict. Own task on core 1, reply
    sent before the radio is touched, result read once -- the scanner's 4.71 shape.
    VERIFIED ON THE CAR, IGNITION OFF, TWICE:
    connect 8317 ms at -58 dBm, MTU 130, serial pai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
2026-09-14 docs: document the BLE connect test
    esp32-s3/docs/voltage-monitor.md section 7c gains "Connection test", covering
    what the page cannot say for itself:
    * the five steps of one test, and how the serial pair is chosen;
    * a verdict table, read as "how far did it get";
    * the Veepeak measurements, ignition off;
    * close the phone's OBD app first -- a held dongle stops advertising;
    * ATRV is not a battery reference (11.9 V against a calibrated 12.89 V);
    * a missing device takes ~30 s, because connect() ignores its timeout;
    * what a connection costs in heap;
    * the read-only allow list, and why mode 04 is unreachable;
    * why one client is reused (the library deletes it inside deinit(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
2026-09-14 esp32-s3: fw 4.74 — OBD-II pages for the Veepeak
    The dongle 4.73 proved now feeds an OBD tab: an Overview (reader status,
    RPM, speed, coolant, ECU supply, check-engine light and code count) and six
    category pages -- Engine, Fuel & air, Electrical, Distance & time, Fault
    codes (stored / pending / permanent, readiness monitors), Vehicle (VIN,
    calibration ID, ECU name, OBD standard, fuel type, protocol).
    TABLE-DRIVEN, READ-ONLY. A value is one row in OBD_PIDS, a page one row in
    OBD_CATS; tabs and overview cards follow from the tables. Only PIDs the car
    reports as supported are requested. The session sends a fixed init, modes
    01 and 09, and 03 / 07 / 0A -- no path clears codes.
    THE READER IS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
    [obd_elm.cpp, obd_elm.h, voltage_monitor.ino]
2026-09-14 docs: document the OBD tab
    esp32-s3/docs/voltage-monitor.md gains section 7d, covering what the pages
    cannot say for themselves:
    * what each page shows, and that only supported PIDs are read;
    * picking or changing the reader, and that it is stored, not compiled in;
    * when the board holds the link -- only while a page polls, dropped 60 s
    after -- and why: a held link costs ~88 KB of heap;
    * that a background tab does not count, and the 25-minute link a page left
    open elsewhere held before the page learned to stop polling when hidden;
    * ignition off: the dongle stays powered, the car does not answer, and the
    board re-asks every 15 s;
    * how the data is read, the host-si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
2026-09-14 esp32-s3: fw 4.75 — an OBD log, and the ECU times engine runs
    AN OBD LOG. /obdlog.csv gets a row every 30 s while the car answers: local
    date/time first, then 25 values with units in the column names, then
    atrv_V, battery_V, mil, dtc_count -- 30 columns. An unreported value is an
    empty cell, so columns never shift. Nothing is written while the car is off.
    On by default; toggle (NVS obd_log), download as one CSV, clear. Two
    generations of ~512 KB. Rows are built in RAM by the BLE task and written by
    the loop core with every other file write, never mid-OTA.
    WITH LOGGING ON THE LINK IS HELD FOR THE DRIVE. The loop core starts it when
    the voltage detector confirms the engine is running and ke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
2026-09-14 docs: document the OBD log and ECU-timed runs
    esp32-s3/docs/voltage-monitor.md:
    * 7d "The OBD log": what a row holds, that nothing is written with the car
    off, the toggle / download / clear card, two generations of ~512 KB, and
    why logging holds the link for the whole drive;
    * 7d "Engine start and stop from the ECU": when the engine computer times
    the run log's edges, the two guards, and the statement that none of it
    reaches the auto-start decision;
    * 7d "When the board holds the link": no longer "only while a page is
    open";
    * 7d API: /obdlog.csv and /obdlog;
    * 7b badges: retitled, since the new OBD badge marks a more precise edge,
    not a less certain one.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
2026-09-15 esp32-s3: fw 4.76 — Bluetooth placed once at boot, and a running engine opens the OBD link
    "MEMORY IS TOO FRAGMENTED TO START BLUETOOTH" CANNOT HAPPEN AFTER BOOT NOW.
    Bring-ups fragmented the heap, not scans or links. 4.72's 5-minute idle
    auto-off meant the next use needed a fresh bring-up, and each up/down cycle
    cost contiguity for the rest of the boot. Half an hour and one link session
    after a reboot, 4.75 read 186 KB free with an 86 KB largest block; a fresh
    boot measures ~147 KB.
    The stack is now placed once, after WiFi connects and before server.begin()
    and the safety task. The log shows a largest block of 159-167 KB before and
    87-99 KB after. It is never taken down: no idle auto-off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
    [voltage_monitor.ino]
2026-09-15 esp32-s3: fw 4.77 — the reader is left alone unless the engine runs, with a Read-now override
    NO OBD LINK UNLESS THE ENGINE RUNS. Reported with the car parked: the OBD page
    showed "Reader connected -- the car is not answering". 4.76 still let a polling
    page open a link with the engine off. The user: "it shouldnt even connect. It
    should see that the car is not running and do nothing". obdShouldStop is now
    g_otaActive || (!engRunning && !g_obdOneShot) || reader changed, and /obdjson
    never starts a session. The link ends when the engine stops, and the page says
    why: engine stopped, OTA, or reader changed. /obdjson gains
    "engine":"running"|"off", and the page shows "engine off -- the board con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
2026-09-15 esp32-s3: fw 4.78 — runs credited and dated right; the OBD log keeps what the car reports
    RUNS THE BOARD STARTED WERE LOGGED AS EXTERNAL, plus a phantom start. Found on
    the first remote start: "start VERIFIED" clears g_verifying on the first
    charging sample, and the ON edge confirms 5 s later. So the run got source 2,
    and recordStart(v, 2, true) added an external start that printed as "ENGINE
    START (manual)". Run records back to August show the same pattern. A start the
    board verified within AS_VERIFY_S now stays the ON edge's source
    (g_verifiedSrc). The external record is written only for a truly external
    start, and its log line says "external: key or FOB". History is not rewritten.
    A ST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
2026-09-15 esp32-s3: fw 4.79 — core dumps readable over WiFi
    CORE DUMPS OVER WIFI. The core writes an ELF core dump to flash on every panic,
    but the board lives in the car with no serial cable.
    - GET /coredump?info=1 returns the crashing task, PC, cause, fault address, app
    ELF SHA prefix, backtrace and panic reason.
    - GET /coredump streams the raw dump.
    - POST /coredump?erase=1 clears it.
    - After a panic reset, the boot log records the task, PC and backtrace.
    Also fixes the NOT DONE comment at the old PSRAM threshold. The OTA restart
    panic follows btYieldForOta()'s stack teardown, not the threshold.
    FOUND: the "OTA restart panic" is core 0's IPC task overflowing its 1024 B
    stack during the boot-t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
    [voltage_monitor.ino]
2026-09-15 obdlog-dashboard: the car's OBD-II log, kept and graphed on the projects VM
    A page at http://192.168.15.3/vroom/ that graphs the board's OBD log, and a
    puller on the projects VM that keeps every row the board serves. The board
    keeps two ~512 KB generations and drops the older; the VM keeps everything.
    PULLER (obd-dashboard/puller/vroom_obd_pull.py, vroom-obd-pull.timer, 1/min)
    - GET /obdjson every check; GET /obdlog.csv only when log.bytes changed (at
    most every 2 min while the engine runs; backs off after a failure).
    - Rows merge into data/obdlog.csv, de-duplicated across the 30-column (fw
    4.75-4.77) and 26-column (4.78+) formats; the raw download sits beside it.
    - While the engine run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
2026-09-15 obd-dashboard: follow fw 4.80's row every 10 s
    - The page says 10 s, and works out a drive's or a state's length from its
    own rows (30 s apart before fw 4.80, 10 s since) instead of adding a fixed
    30 s.
    - Board & pull shows the row interval and the last sweep's length; the puller
    keeps the new every_s and sweep_ms from /obdjson's log. Both are optional,
    so the page and puller still work against 4.79.
    - README: at 10 s rows the archive grows ~50 KB per hour of driving.
    VERIFIED: 19 puller tests pass; JS syntax checks. Not yet deployed: that
    follows the 4.80 flash.
2026-09-15 esp32-s3: fw 4.80 — the OBD log takes a row every 10 s
    Asked for: OBD polling/logging every 10 s instead of 30 s.
    - OBD_LOG_EVERY_MS 30000 -> 10000. Each sweep reads every logged PID, then
    queues a row. About 50 KB per hour of engine running: a 512 KB generation
    now holds ~10 h, not ~30. The projects VM keeps every row.
    - The row queue holds 12 rows, not 4: still 2 minutes of rows waiting for
    the loop core, which holds off while an OTA streams.
    - A row carries what its sweep read or what was read in the last 10 s,
    whichever reaches back further. At 30 s the window covered any sweep; at
    10 s a sweep slowed by PIDs that time out (4 s each) would have blanked
    the values it read f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
2026-09-15 obd-dashboard: keep each pull as its own file, then clear the board's log
    Asked for: "when its pulled into the projects vm, keep the csv on the server
    and remove the log from the esp32".
    - Every download is kept byte for byte in data/pulled/obdlog_<first row>.csv,
    one file per board log (a re-download of the same log replaces its file; a
    log started after a clear gets a new one), listed in pulled/index.json.
    - Then POST /obdlog?clear=1 -- the board's own Clear -- only when the engine
    is off and the link down, the download is whole (ends in a newline,
    nothing unreadable, size == log.bytes or that less one header line shared
    by both generations), and a fresh /obdjson shows log.bytes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
2026-09-15 obd-dashboard: view one pulled CSV at a time
    Asked for: "have a dropdown to select csv entries that have already been
    downloaded, so we can view by csv (not just a date range)".
    - A CSV list starts the filter row: All rows (obdlog.csv), then each kept
    board log from data/pulled/index.json, newest first, labelled with its
    first and last row and row count, and marked "still on the board" until
    the board's copy is cleared.
    - Picking one loads that file: graphs, drive list, latest values, text
    states, table and download link all follow it; the range resets to All.
    - The choice is part of the link (#csv=<file>&range=all). A file no longer
    listed falls back to All rows; a switch made wh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
2026-09-18 docs: three days of driving verified the 10 s log, the VIN capture and clearing
    Everything the 2026-09-15 entries left open is now measured. No code changed.
    - Rows land 10 s apart: the 2026-09-17 log, 542 rows over 4.5 hours (~90 min of
    engine running), median gap 10.0 s, mean 10.16 s, widest inside a drive 39 s.
    - A sweep of every logged PID takes ~2.1 s, 3.9 s at worst (/obdstate sweep_ms
    2105, sweep_max_ms 3899 since the 4.80 boot), against a 10 s row.
    - Not one of that log's 26 columns has an empty cell, so the freshness window
    (the longer of 10 s and the sweep) holds.
    - The single values were read while the engine ran on the first drive after the
    deploy: VIN, calibration ID, E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
